Noobmaster69korg/EMG_gesture_classifier_Verilog/Files for analysis/description.md

This folder contains the files which was used to check if the model was working as intended.

Total 6 files are there. What's absolutely necessary is that u **add the "emg_data.hex" file to your verilog project. ** Since the test bench will be reading the sample values from this very file itself.
