Noobmaster69korg/EMG_gesture_classifier_Verilog/COE files/description.md

COE files basically contain the paramters which are to be loaded in the respective bram IPs of the verilog project.

**Details**

Total COE files: 197

Mapping of the COE files( the mapping information of the "bram_0.xci – bram_31.xci (32)" is completely verified. Ignore the identifier 'likely' in that respective description)
