Noobmaster69korg/EMG_gesture_classifier_Verilog/Model_description/summary_of_MODEL.png

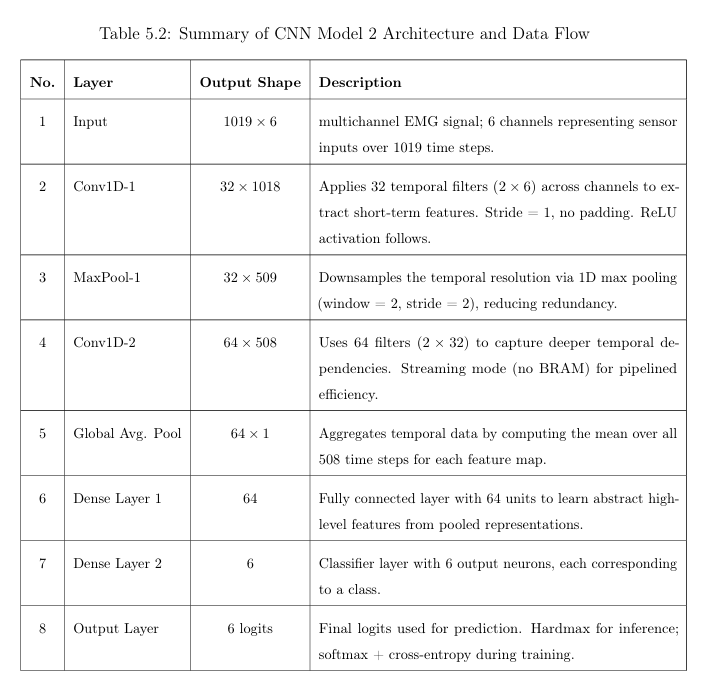
Model_description/summary_of_MODEL.png
