Noobmaster69korg/EMG_gesture_classifier_Verilog/verilog testbench files/description.md

This folder contains the various testbenches of the project
