Noobmaster69korg/EMG_gesture_classifier_Verilog/verilog_code_files/L2_main.v

`timescale 1ns / 1ps


module pre_fetch (
    input clk,
    input reset,
    input clk_2,
    input reset_data,
 (*dont_touch = "true"*)   input signed [17:0] data_in_0, 
 (*dont_touch = "true"*)   input signed [17:0] data_in_1, 
    input signed [17:0] data_in_2, 
    input signed [17:0] data_in_3, 
    input signed [17:0] data_in_4, 
    input signed [17:0] data_in_5, 
    input signed [17:0] data_in_6, 
    input signed [17:0] data_in_7, 
    input signed [17:0] data_in_8, 
    input signed [17:0] data_in_9, 
    input signed [17:0] data_in_10, 
    input signed [17:0] data_in_11, 
    input signed [17:0] data_in_12, 
    input signed [17:0] data_in_13, 
    input signed [17:0] data_in_14, 
    input signed [17:0] data_in_15, 
    input signed [17:0] data_in_16, 
    input signed [17:0] data_in_17, 
    input signed [17:0] data_in_18, 
    input signed [17:0] data_in_19, 
    input signed [17:0] data_in_20, 
    input signed [17:0] data_in_21, 
    input signed [17:0] data_in_22, 
    input signed [17:0] data_in_23, 
    input signed [17:0] data_in_24, 
    input signed [17:0] data_in_25, 
    input signed [17:0] data_in_26, 
    input signed [17:0] data_in_27, 
    input signed [17:0] data_in_28, 
    input signed [17:0] data_in_29, 
    input signed [17:0] data_in_30, 
    input signed [17:0] data_in_31, 
    
 (*dont_touch = "true"*)   output reset_next_stage,
 (*dont_touch = "true"*)    output signed [31:0] data_out_0, 
 (*dont_touch = "true"*)   output signed [31:0] data_out_1, 
    output signed [31:0] data_out_2, 
    output signed [31:0] data_out_3, 
    output signed [31:0] data_out_4, 
    output signed [31:0] data_out_5, 
    output signed [31:0] data_out_6, 
    output signed [31:0] data_out_7, 
    output signed [31:0] data_out_8, 
    output signed [31:0] data_out_9, 
    output signed [31:0] data_out_10, 
    output signed [31:0] data_out_11, 
    output signed [31:0] data_out_12, 
    output signed [31:0] data_out_13, 
    output signed [31:0] data_out_14, 
    output signed [31:0] data_out_15,
    output signed [31:0] data_out_16, 
    output signed [31:0] data_out_17, 
    output signed [31:0] data_out_18, 
    output signed [31:0] data_out_19, 
    output signed [31:0] data_out_20, 
    output signed [31:0] data_out_21, 
    output signed [31:0] data_out_22, 
    output signed [31:0] data_out_23, 
    output signed [31:0] data_out_24, 
    output signed [31:0] data_out_25, 
    output signed [31:0] data_out_26, 
    output signed [31:0] data_out_27, 
    output signed [31:0] data_out_28, 
    output signed [31:0] data_out_29, 
    output signed [31:0] data_out_30, 
    output signed [31:0] data_out_31, 
    output signed [31:0] data_out_32, 
    output signed [31:0] data_out_33, 
    output signed [31:0] data_out_34, 
    output signed [31:0] data_out_35, 
    output signed [31:0] data_out_36, 
    output signed [31:0] data_out_37, 
    output signed [31:0] data_out_38, 
    output signed [31:0] data_out_39, 
    output signed [31:0] data_out_40, 
    output signed [31:0] data_out_41, 
    output signed [31:0] data_out_42, 
    output signed [31:0] data_out_43, 
    output signed [31:0] data_out_44, 
    output signed [31:0] data_out_45, 
    output signed [31:0] data_out_46, 
    output signed [31:0] data_out_47, 
    output signed [31:0] data_out_48, 
    output signed [31:0] data_out_49, 
    output signed [31:0] data_out_50, 
    output signed [31:0] data_out_51, 
    output signed [31:0] data_out_52, 
    output signed [31:0] data_out_53, 
    output signed [31:0] data_out_54, 
    output signed [31:0] data_out_55, 
    output signed [31:0] data_out_56, 
    output signed [31:0] data_out_57, 
    output signed [31:0] data_out_58, 
    output signed [31:0] data_out_59, 
    output signed [31:0] data_out_60, 
    output signed [31:0] data_out_61, 
    output signed [31:0] data_out_62, 
    output signed [31:0] data_out_63

    );
    // multiplexing is done. 16 filters are reused 4 times so as to accomadate 64 filters
    wire signed [7:0] bram_data_out_wire [63:0] ; //outputs of BRAM
    wire signed [7:0] w  [4095:0] ; // holds the 4096 weights of 64 filters; each having 64 parameters
    wire signed [7:0] wa [1023:0]; // holds the 1024 parameters used at a time
    wire signed [26:0] data_out_wire [15:0];
    wire signed [7:0] bias_out_wire [63:0];
    wire signed [7:0] ba [15:0];
    wire signed [31:0] baa [63:0];
(*dont_touch = "true"*)    wire signed [26:0] wxa [15:0];
 //   wire signed [26:0] wxb [15:0];
(*dont_touch = "true"*)    wire [1:0] sel_wire; // for weight mux
(*dont_touch = "true"*)    wire reset_test_1,reset_test_2,new_reset;
(*dont_touch = "true"*)    wire reset_test_3, reset_test_4, reset_test_5;
    genvar i,j,k;
   
    
    bram                      m0 (clk,reset,bram_data_out_wire[0],bram_data_out_wire[1],bram_data_out_wire[2],bram_data_out_wire[3],
                                  bram_data_out_wire[4],bram_data_out_wire[5],bram_data_out_wire[6],bram_data_out_wire[7],bram_data_out_wire[8],
                                  bram_data_out_wire[9],bram_data_out_wire[10],bram_data_out_wire[11],bram_data_out_wire[12],bram_data_out_wire[13],
                                  bram_data_out_wire[14],bram_data_out_wire[15],bram_data_out_wire[16],bram_data_out_wire[17],bram_data_out_wire[18],
                                  bram_data_out_wire[19],bram_data_out_wire[20],bram_data_out_wire[21],bram_data_out_wire[22],bram_data_out_wire[23],
                                  bram_data_out_wire[24],bram_data_out_wire[25],bram_data_out_wire[26],bram_data_out_wire[27],bram_data_out_wire[28],
                                  bram_data_out_wire[29],bram_data_out_wire[30],bram_data_out_wire[31],bram_data_out_wire[32],bram_data_out_wire[33],
                                  bram_data_out_wire[34],bram_data_out_wire[35],bram_data_out_wire[36],bram_data_out_wire[37],bram_data_out_wire[38],
                                  bram_data_out_wire[39],bram_data_out_wire[40],bram_data_out_wire[41],bram_data_out_wire[42],bram_data_out_wire[43],
                                  bram_data_out_wire[44],bram_data_out_wire[45],bram_data_out_wire[46],bram_data_out_wire[47],bram_data_out_wire[48],
                                  bram_data_out_wire[49],bram_data_out_wire[50],bram_data_out_wire[51],bram_data_out_wire[52],bram_data_out_wire[53],
                                  bram_data_out_wire[54],bram_data_out_wire[55],bram_data_out_wire[56],bram_data_out_wire[57],bram_data_out_wire[58],
                                  bram_data_out_wire[59],bram_data_out_wire[60],bram_data_out_wire[61],bram_data_out_wire[62],bram_data_out_wire[63]);
    
    weight_loader_for_bias m1     (.clk(clk),.reset(reset),.bias_0(bias_out_wire[0]), .bias_1(bias_out_wire[1]), .bias_2(bias_out_wire[2]), .bias_3(bias_out_wire[3]),
                                   .bias_4(bias_out_wire[4]), .bias_5(bias_out_wire[5]), .bias_6(bias_out_wire[6]), .bias_7(bias_out_wire[7]), .bias_8(bias_out_wire[8]),
                                   .bias_9(bias_out_wire[9]), .bias_10(bias_out_wire[10]), .bias_11(bias_out_wire[11]), .bias_12(bias_out_wire[12]), .bias_13(bias_out_wire[13]),
                                   .bias_14(bias_out_wire[14]), .bias_15(bias_out_wire[15]), .bias_16(bias_out_wire[16]), .bias_17(bias_out_wire[17]), .bias_18(bias_out_wire[18]),
                                   .bias_19(bias_out_wire[19]), .bias_20(bias_out_wire[20]), .bias_21(bias_out_wire[21]), .bias_22(bias_out_wire[22]), .bias_23(bias_out_wire[23]),
                                   .bias_24(bias_out_wire[24]), .bias_25(bias_out_wire[25]), .bias_26(bias_out_wire[26]), .bias_27(bias_out_wire[27]), .bias_28(bias_out_wire[28]),
                                   .bias_29(bias_out_wire[29]), .bias_30(bias_out_wire[30]), .bias_31(bias_out_wire[31]), .bias_32(bias_out_wire[32]), .bias_33(bias_out_wire[33]),
                                   .bias_34(bias_out_wire[34]), .bias_35(bias_out_wire[35]), .bias_36(bias_out_wire[36]), .bias_37(bias_out_wire[37]), .bias_38(bias_out_wire[38]),
                                   .bias_39(bias_out_wire[39]), .bias_40(bias_out_wire[40]), .bias_41(bias_out_wire[41]), .bias_42(bias_out_wire[42]), .bias_43(bias_out_wire[43]), 
                                   .bias_44(bias_out_wire[44]), .bias_45(bias_out_wire[45]), .bias_46(bias_out_wire[46]), .bias_47(bias_out_wire[47]), .bias_48(bias_out_wire[48]),
                                   .bias_49(bias_out_wire[49]), .bias_50(bias_out_wire[50]), .bias_51(bias_out_wire[51]), .bias_52(bias_out_wire[52]), .bias_53(bias_out_wire[53]),
                                   .bias_54(bias_out_wire[54]), .bias_55(bias_out_wire[55]), .bias_56(bias_out_wire[56]), .bias_57(bias_out_wire[57]), .bias_58(bias_out_wire[58]),
                                   .bias_59(bias_out_wire[59]), .bias_60(bias_out_wire[60]), .bias_61(bias_out_wire[61]), .bias_62(bias_out_wire[62]), .bias_63(bias_out_wire[63]));
   generate
   for(i= 0 ; i < 64 ; i = i+1)begin
          weight_loader q1         (.clk(clk),.reset(reset),.data_in(bram_data_out_wire[i]),.w0(w[i*64 + 0]), .w1(w[i*64 + 1]), .w2(w[i*64 + 2]), .w3(w[i*64 + 3]), .w4(w[i*64 + 4]),
                                    .w5(w[i*64 + 5]), .w6(w[i*64 + 6]), .w7(w[i*64 + 7]), .w8(w[i*64 + 8]), .w9(w[i*64 + 9]), .w10(w[i*64 + 10]), .w11(w[i*64 + 11]), .w12(w[i*64 + 12]),
                                    .w13(w[i*64 + 13]), .w14(w[i*64 + 14]), .w15(w[i*64 + 15]), .w16(w[i*64 + 16]), .w17(w[i*64 + 17]), .w18(w[i*64 + 18]), .w19(w[i*64 + 19]), .w20(w[i*64 + 20]),
                                    .w21(w[i*64 + 21]), .w22(w[i*64 + 22]), .w23(w[i*64 + 23]), .w24(w[i*64 + 24]), .w25(w[i*64 + 25]), .w26(w[i*64 + 26]), .w27(w[i*64 + 27]), .w28(w[i*64 + 28]),
                                    .w29(w[i*64 + 29]), .w30(w[i*64 + 30]), .w31(w[i*64 + 31]), .w32(w[i*64 + 32]), .w33(w[i*64 + 33]), .w34(w[i*64 + 34]), .w35(w[i*64 + 35]), .w36(w[i*64 + 36]),
                                    .w37(w[i*64 + 37]), .w38(w[i*64 + 38]), .w39(w[i*64 + 39]), .w40(w[i*64 + 40]), .w41(w[i*64 + 41]), .w42(w[i*64 + 42]), .w43(w[i*64 + 43]), .w44(w[i*64 + 44]),
                                    .w45(w[i*64 + 45]), .w46(w[i*64 + 46]), .w47(w[i*64 + 47]), .w48(w[i*64 + 48]), .w49(w[i*64 + 49]), .w50(w[i*64 + 50]), .w51(w[i*64 + 51]), .w52(w[i*64 + 52]),
                                    .w53(w[i*64 + 53]), .w54(w[i*64 + 54]), .w55(w[i*64 + 55]), .w56(w[i*64 + 56]), .w57(w[i*64 + 57]), .w58(w[i*64 + 58]), .w59(w[i*64 + 59]), .w60(w[i*64 + 60]),
                                    .w61(w[i*64 + 61]), .w62(w[i*64 + 62]), .w63(w[i*64 + 63]));
   end 
   endgenerate 
   
   mux_4096 q2 (.sel(sel_wire),.data_in_0(w[0]),.data_in_1(w[1]),.data_in_2(w[2]),.data_in_3(w[3]),.data_in_4(w[4]),.data_in_5(w[5]),.data_in_6(w[6]),.data_in_7(w[7]),.data_in_8(w[8]),.data_in_9(w[9]),.data_in_10(w[10]),
                .data_in_11(w[11]),.data_in_12(w[12]),.data_in_13(w[13]),.data_in_14(w[14]),.data_in_15(w[15]),.data_in_16(w[16]),.data_in_17(w[17]),.data_in_18(w[18]),.data_in_19(w[19]),.data_in_20(w[20]),
                .data_in_21(w[21]),.data_in_22(w[22]),.data_in_23(w[23]),.data_in_24(w[24]),.data_in_25(w[25]),.data_in_26(w[26]),.data_in_27(w[27]),.data_in_28(w[28]),.data_in_29(w[29]),.data_in_30(w[30]),
                .data_in_31(w[31]),.data_in_32(w[32]),.data_in_33(w[33]),.data_in_34(w[34]),.data_in_35(w[35]),.data_in_36(w[36]),.data_in_37(w[37]),.data_in_38(w[38]),.data_in_39(w[39]),.data_in_40(w[40]),
                .data_in_41(w[41]),.data_in_42(w[42]),.data_in_43(w[43]),.data_in_44(w[44]),.data_in_45(w[45]),.data_in_46(w[46]),.data_in_47(w[47]),.data_in_48(w[48]),.data_in_49(w[49]),.data_in_50(w[50]),
                .data_in_51(w[51]),.data_in_52(w[52]),.data_in_53(w[53]),.data_in_54(w[54]),.data_in_55(w[55]),.data_in_56(w[56]),.data_in_57(w[57]),.data_in_58(w[58]),.data_in_59(w[59]),.data_in_60(w[60]),
                .data_in_61(w[61]),.data_in_62(w[62]),.data_in_63(w[63]),.data_in_64(w[64]),.data_in_65(w[65]),.data_in_66(w[66]),.data_in_67(w[67]),.data_in_68(w[68]),.data_in_69(w[69]),.data_in_70(w[70]),
                .data_in_71(w[71]),.data_in_72(w[72]),.data_in_73(w[73]),.data_in_74(w[74]),.data_in_75(w[75]),.data_in_76(w[76]),.data_in_77(w[77]),.data_in_78(w[78]),.data_in_79(w[79]),.data_in_80(w[80]),
                .data_in_81(w[81]),.data_in_82(w[82]),.data_in_83(w[83]),.data_in_84(w[84]),.data_in_85(w[85]),.data_in_86(w[86]),.data_in_87(w[87]),.data_in_88(w[88]),.data_in_89(w[89]),.data_in_90(w[90]),
                .data_in_91(w[91]),.data_in_92(w[92]),.data_in_93(w[93]),.data_in_94(w[94]),.data_in_95(w[95]),.data_in_96(w[96]),.data_in_97(w[97]),.data_in_98(w[98]),.data_in_99(w[99]),.data_in_100(w[100]),
                .data_in_101(w[101]),.data_in_102(w[102]),.data_in_103(w[103]),.data_in_104(w[104]),.data_in_105(w[105]),.data_in_106(w[106]),.data_in_107(w[107]),.data_in_108(w[108]),.data_in_109(w[109]),
                .data_in_110(w[110]),.data_in_111(w[111]),.data_in_112(w[112]),.data_in_113(w[113]),.data_in_114(w[114]),.data_in_115(w[115]),.data_in_116(w[116]),.data_in_117(w[117]),.data_in_118(w[118]),
                .data_in_119(w[119]),.data_in_120(w[120]),.data_in_121(w[121]),.data_in_122(w[122]),.data_in_123(w[123]),.data_in_124(w[124]),.data_in_125(w[125]),.data_in_126(w[126]),.data_in_127(w[127]),
                .data_in_128(w[128]),.data_in_129(w[129]),.data_in_130(w[130]),.data_in_131(w[131]),.data_in_132(w[132]),.data_in_133(w[133]),.data_in_134(w[134]),.data_in_135(w[135]),.data_in_136(w[136]),
                .data_in_137(w[137]),.data_in_138(w[138]),.data_in_139(w[139]),.data_in_140(w[140]),.data_in_141(w[141]),.data_in_142(w[142]),.data_in_143(w[143]),.data_in_144(w[144]),.data_in_145(w[145]),
                .data_in_146(w[146]),.data_in_147(w[147]),.data_in_148(w[148]),.data_in_149(w[149]),.data_in_150(w[150]),.data_in_151(w[151]),.data_in_152(w[152]),.data_in_153(w[153]),.data_in_154(w[154]),
                .data_in_155(w[155]),.data_in_156(w[156]),.data_in_157(w[157]),.data_in_158(w[158]),.data_in_159(w[159]),.data_in_160(w[160]),.data_in_161(w[161]),.data_in_162(w[162]),.data_in_163(w[163]),
                .data_in_164(w[164]),.data_in_165(w[165]),.data_in_166(w[166]),.data_in_167(w[167]),.data_in_168(w[168]),.data_in_169(w[169]),.data_in_170(w[170]),.data_in_171(w[171]),.data_in_172(w[172]),
                .data_in_173(w[173]),.data_in_174(w[174]),.data_in_175(w[175]),.data_in_176(w[176]),.data_in_177(w[177]),.data_in_178(w[178]),.data_in_179(w[179]),.data_in_180(w[180]),.data_in_181(w[181]),
                .data_in_182(w[182]),.data_in_183(w[183]),.data_in_184(w[184]),.data_in_185(w[185]),.data_in_186(w[186]),.data_in_187(w[187]),.data_in_188(w[188]),.data_in_189(w[189]),.data_in_190(w[190]),
                .data_in_191(w[191]),.data_in_192(w[192]),.data_in_193(w[193]),.data_in_194(w[194]),.data_in_195(w[195]),.data_in_196(w[196]),.data_in_197(w[197]),.data_in_198(w[198]),.data_in_199(w[199]),
                .data_in_200(w[200]),.data_in_201(w[201]),.data_in_202(w[202]),.data_in_203(w[203]),.data_in_204(w[204]),.data_in_205(w[205]),.data_in_206(w[206]),.data_in_207(w[207]),.data_in_208(w[208]),
                .data_in_209(w[209]),.data_in_210(w[210]),.data_in_211(w[211]),.data_in_212(w[212]),.data_in_213(w[213]),.data_in_214(w[214]),.data_in_215(w[215]),.data_in_216(w[216]),.data_in_217(w[217]),
                .data_in_218(w[218]),.data_in_219(w[219]),.data_in_220(w[220]),.data_in_221(w[221]),.data_in_222(w[222]),.data_in_223(w[223]),.data_in_224(w[224]),.data_in_225(w[225]),.data_in_226(w[226]),
                .data_in_227(w[227]),.data_in_228(w[228]),.data_in_229(w[229]),.data_in_230(w[230]),.data_in_231(w[231]),.data_in_232(w[232]),.data_in_233(w[233]),.data_in_234(w[234]),.data_in_235(w[235]),
                .data_in_236(w[236]),.data_in_237(w[237]),.data_in_238(w[238]),.data_in_239(w[239]),.data_in_240(w[240]),.data_in_241(w[241]),.data_in_242(w[242]),.data_in_243(w[243]),.data_in_244(w[244]),
                .data_in_245(w[245]),.data_in_246(w[246]),.data_in_247(w[247]),.data_in_248(w[248]),.data_in_249(w[249]),.data_in_250(w[250]),.data_in_251(w[251]),.data_in_252(w[252]),.data_in_253(w[253]),
                .data_in_254(w[254]),.data_in_255(w[255]),.data_in_256(w[256]),.data_in_257(w[257]),.data_in_258(w[258]),.data_in_259(w[259]),.data_in_260(w[260]),.data_in_261(w[261]),.data_in_262(w[262]),
                .data_in_263(w[263]),.data_in_264(w[264]),.data_in_265(w[265]),.data_in_266(w[266]),.data_in_267(w[267]),.data_in_268(w[268]),.data_in_269(w[269]),.data_in_270(w[270]),.data_in_271(w[271]),
                .data_in_272(w[272]),.data_in_273(w[273]),.data_in_274(w[274]),.data_in_275(w[275]),.data_in_276(w[276]),.data_in_277(w[277]),.data_in_278(w[278]),.data_in_279(w[279]),.data_in_280(w[280]),
                .data_in_281(w[281]),.data_in_282(w[282]),.data_in_283(w[283]),.data_in_284(w[284]),.data_in_285(w[285]),.data_in_286(w[286]),.data_in_287(w[287]),.data_in_288(w[288]),.data_in_289(w[289]),
                .data_in_290(w[290]),.data_in_291(w[291]),.data_in_292(w[292]),.data_in_293(w[293]),.data_in_294(w[294]),.data_in_295(w[295]),.data_in_296(w[296]),.data_in_297(w[297]),.data_in_298(w[298]),
                .data_in_299(w[299]),.data_in_300(w[300]),.data_in_301(w[301]),.data_in_302(w[302]),.data_in_303(w[303]),.data_in_304(w[304]),.data_in_305(w[305]),.data_in_306(w[306]),.data_in_307(w[307]),
                .data_in_308(w[308]),.data_in_309(w[309]),.data_in_310(w[310]),.data_in_311(w[311]),.data_in_312(w[312]),.data_in_313(w[313]),.data_in_314(w[314]),.data_in_315(w[315]),.data_in_316(w[316]),
                .data_in_317(w[317]),.data_in_318(w[318]),.data_in_319(w[319]),.data_in_320(w[320]),.data_in_321(w[321]),.data_in_322(w[322]),.data_in_323(w[323]),.data_in_324(w[324]),.data_in_325(w[325]),
                .data_in_326(w[326]),.data_in_327(w[327]),.data_in_328(w[328]),.data_in_329(w[329]),.data_in_330(w[330]),.data_in_331(w[331]),.data_in_332(w[332]),.data_in_333(w[333]),.data_in_334(w[334]),
                .data_in_335(w[335]),.data_in_336(w[336]),.data_in_337(w[337]),.data_in_338(w[338]),.data_in_339(w[339]),.data_in_340(w[340]),.data_in_341(w[341]),.data_in_342(w[342]),.data_in_343(w[343]),
                .data_in_344(w[344]),.data_in_345(w[345]),.data_in_346(w[346]),.data_in_347(w[347]),.data_in_348(w[348]),.data_in_349(w[349]),.data_in_350(w[350]),.data_in_351(w[351]),.data_in_352(w[352]),
                .data_in_353(w[353]),.data_in_354(w[354]),.data_in_355(w[355]),.data_in_356(w[356]),.data_in_357(w[357]),.data_in_358(w[358]),.data_in_359(w[359]),.data_in_360(w[360]),.data_in_361(w[361]),
                .data_in_362(w[362]),.data_in_363(w[363]),.data_in_364(w[364]),.data_in_365(w[365]),.data_in_366(w[366]),.data_in_367(w[367]),.data_in_368(w[368]),.data_in_369(w[369]),.data_in_370(w[370]),
                .data_in_371(w[371]),.data_in_372(w[372]),.data_in_373(w[373]),.data_in_374(w[374]),.data_in_375(w[375]),.data_in_376(w[376]),.data_in_377(w[377]),.data_in_378(w[378]),.data_in_379(w[379]),
                .data_in_380(w[380]),.data_in_381(w[381]),.data_in_382(w[382]),.data_in_383(w[383]),.data_in_384(w[384]),.data_in_385(w[385]),.data_in_386(w[386]),.data_in_387(w[387]),.data_in_388(w[388]),
                .data_in_389(w[389]),.data_in_390(w[390]),.data_in_391(w[391]),.data_in_392(w[392]),.data_in_393(w[393]),.data_in_394(w[394]),.data_in_395(w[395]),.data_in_396(w[396]),.data_in_397(w[397]),
                .data_in_398(w[398]),.data_in_399(w[399]),.data_in_400(w[400]),.data_in_401(w[401]),.data_in_402(w[402]),.data_in_403(w[403]),.data_in_404(w[404]),.data_in_405(w[405]),.data_in_406(w[406]),
                .data_in_407(w[407]),.data_in_408(w[408]),.data_in_409(w[409]),.data_in_410(w[410]),.data_in_411(w[411]),.data_in_412(w[412]),.data_in_413(w[413]),.data_in_414(w[414]),.data_in_415(w[415]),
                .data_in_416(w[416]),.data_in_417(w[417]),.data_in_418(w[418]),.data_in_419(w[419]),.data_in_420(w[420]),.data_in_421(w[421]),.data_in_422(w[422]),.data_in_423(w[423]),.data_in_424(w[424]),
                .data_in_425(w[425]),.data_in_426(w[426]),.data_in_427(w[427]),.data_in_428(w[428]),.data_in_429(w[429]),.data_in_430(w[430]),.data_in_431(w[431]),.data_in_432(w[432]),.data_in_433(w[433]),
                .data_in_434(w[434]),.data_in_435(w[435]),.data_in_436(w[436]),.data_in_437(w[437]),.data_in_438(w[438]),.data_in_439(w[439]),.data_in_440(w[440]),.data_in_441(w[441]),.data_in_442(w[442]),
                .data_in_443(w[443]),.data_in_444(w[444]),.data_in_445(w[445]),.data_in_446(w[446]),.data_in_447(w[447]),.data_in_448(w[448]),.data_in_449(w[449]),.data_in_450(w[450]),.data_in_451(w[451]),
                .data_in_452(w[452]),.data_in_453(w[453]),.data_in_454(w[454]),.data_in_455(w[455]),.data_in_456(w[456]),.data_in_457(w[457]),.data_in_458(w[458]),.data_in_459(w[459]),.data_in_460(w[460]),
                .data_in_461(w[461]),.data_in_462(w[462]),.data_in_463(w[463]),.data_in_464(w[464]),.data_in_465(w[465]),.data_in_466(w[466]),.data_in_467(w[467]),.data_in_468(w[468]),.data_in_469(w[469]),
                .data_in_470(w[470]),.data_in_471(w[471]),.data_in_472(w[472]),.data_in_473(w[473]),.data_in_474(w[474]),.data_in_475(w[475]),.data_in_476(w[476]),.data_in_477(w[477]),.data_in_478(w[478]),
                .data_in_479(w[479]),.data_in_480(w[480]),.data_in_481(w[481]),.data_in_482(w[482]),.data_in_483(w[483]),.data_in_484(w[484]),.data_in_485(w[485]),.data_in_486(w[486]),.data_in_487(w[487]),
                .data_in_488(w[488]),.data_in_489(w[489]),.data_in_490(w[490]),.data_in_491(w[491]),.data_in_492(w[492]),.data_in_493(w[493]),.data_in_494(w[494]),.data_in_495(w[495]),.data_in_496(w[496]),
                .data_in_497(w[497]),.data_in_498(w[498]),.data_in_499(w[499]),.data_in_500(w[500]),.data_in_501(w[501]),.data_in_502(w[502]),.data_in_503(w[503]),.data_in_504(w[504]),.data_in_505(w[505]),
                .data_in_506(w[506]),.data_in_507(w[507]),.data_in_508(w[508]),.data_in_509(w[509]),.data_in_510(w[510]),.data_in_511(w[511]),.data_in_512(w[512]),.data_in_513(w[513]),.data_in_514(w[514]),
                .data_in_515(w[515]),.data_in_516(w[516]),.data_in_517(w[517]),.data_in_518(w[518]),.data_in_519(w[519]),.data_in_520(w[520]),.data_in_521(w[521]),.data_in_522(w[522]),.data_in_523(w[523]),
                .data_in_524(w[524]),.data_in_525(w[525]),.data_in_526(w[526]),.data_in_527(w[527]),.data_in_528(w[528]),.data_in_529(w[529]),.data_in_530(w[530]),.data_in_531(w[531]),.data_in_532(w[532]),
                .data_in_533(w[533]),.data_in_534(w[534]),.data_in_535(w[535]),.data_in_536(w[536]),.data_in_537(w[537]),.data_in_538(w[538]),.data_in_539(w[539]),.data_in_540(w[540]),.data_in_541(w[541]),
                .data_in_542(w[542]),.data_in_543(w[543]),.data_in_544(w[544]),.data_in_545(w[545]),.data_in_546(w[546]),.data_in_547(w[547]),.data_in_548(w[548]),.data_in_549(w[549]),.data_in_550(w[550]),
                .data_in_551(w[551]),.data_in_552(w[552]),.data_in_553(w[553]),.data_in_554(w[554]),.data_in_555(w[555]),.data_in_556(w[556]),.data_in_557(w[557]),.data_in_558(w[558]),.data_in_559(w[559]),
                .data_in_560(w[560]),.data_in_561(w[561]),.data_in_562(w[562]),.data_in_563(w[563]),.data_in_564(w[564]),.data_in_565(w[565]),.data_in_566(w[566]),.data_in_567(w[567]),.data_in_568(w[568]),
                .data_in_569(w[569]),.data_in_570(w[570]),.data_in_571(w[571]),.data_in_572(w[572]),.data_in_573(w[573]),.data_in_574(w[574]),.data_in_575(w[575]),.data_in_576(w[576]),.data_in_577(w[577]),
                .data_in_578(w[578]),.data_in_579(w[579]),.data_in_580(w[580]),.data_in_581(w[581]),.data_in_582(w[582]),.data_in_583(w[583]),.data_in_584(w[584]),.data_in_585(w[585]),.data_in_586(w[586]),
                .data_in_587(w[587]),.data_in_588(w[588]),.data_in_589(w[589]),.data_in_590(w[590]),.data_in_591(w[591]),.data_in_592(w[592]),.data_in_593(w[593]),.data_in_594(w[594]),.data_in_595(w[595]),
                .data_in_596(w[596]),.data_in_597(w[597]),.data_in_598(w[598]),.data_in_599(w[599]),.data_in_600(w[600]),.data_in_601(w[601]),.data_in_602(w[602]),.data_in_603(w[603]),.data_in_604(w[604]),
                .data_in_605(w[605]),.data_in_606(w[606]),.data_in_607(w[607]),.data_in_608(w[608]),.data_in_609(w[609]),.data_in_610(w[610]),.data_in_611(w[611]),.data_in_612(w[612]),.data_in_613(w[613]),
                .data_in_614(w[614]),.data_in_615(w[615]),.data_in_616(w[616]),.data_in_617(w[617]),.data_in_618(w[618]),.data_in_619(w[619]),.data_in_620(w[620]),.data_in_621(w[621]),.data_in_622(w[622]),
                .data_in_623(w[623]),.data_in_624(w[624]),.data_in_625(w[625]),.data_in_626(w[626]),.data_in_627(w[627]),.data_in_628(w[628]),.data_in_629(w[629]),.data_in_630(w[630]),.data_in_631(w[631]),
                .data_in_632(w[632]),.data_in_633(w[633]),.data_in_634(w[634]),.data_in_635(w[635]),.data_in_636(w[636]),.data_in_637(w[637]),.data_in_638(w[638]),.data_in_639(w[639]),.data_in_640(w[640]),
                .data_in_641(w[641]),.data_in_642(w[642]),.data_in_643(w[643]),.data_in_644(w[644]),.data_in_645(w[645]),.data_in_646(w[646]),.data_in_647(w[647]),.data_in_648(w[648]),.data_in_649(w[649]),
                .data_in_650(w[650]),.data_in_651(w[651]),.data_in_652(w[652]),.data_in_653(w[653]),.data_in_654(w[654]),.data_in_655(w[655]),.data_in_656(w[656]),.data_in_657(w[657]),.data_in_658(w[658]),
                .data_in_659(w[659]),.data_in_660(w[660]),.data_in_661(w[661]),.data_in_662(w[662]),.data_in_663(w[663]),.data_in_664(w[664]),.data_in_665(w[665]),.data_in_666(w[666]),.data_in_667(w[667]),
                .data_in_668(w[668]),.data_in_669(w[669]),.data_in_670(w[670]),.data_in_671(w[671]),.data_in_672(w[672]),.data_in_673(w[673]),.data_in_674(w[674]),.data_in_675(w[675]),.data_in_676(w[676]),
                .data_in_677(w[677]),.data_in_678(w[678]),.data_in_679(w[679]),.data_in_680(w[680]),.data_in_681(w[681]),.data_in_682(w[682]),.data_in_683(w[683]),.data_in_684(w[684]),.data_in_685(w[685]),
                .data_in_686(w[686]),.data_in_687(w[687]),.data_in_688(w[688]),.data_in_689(w[689]),.data_in_690(w[690]),.data_in_691(w[691]),.data_in_692(w[692]),.data_in_693(w[693]),.data_in_694(w[694]),
                .data_in_695(w[695]),.data_in_696(w[696]),.data_in_697(w[697]),.data_in_698(w[698]),.data_in_699(w[699]),.data_in_700(w[700]),.data_in_701(w[701]),.data_in_702(w[702]),.data_in_703(w[703]),
                .data_in_704(w[704]),.data_in_705(w[705]),.data_in_706(w[706]),.data_in_707(w[707]),.data_in_708(w[708]),.data_in_709(w[709]),.data_in_710(w[710]),.data_in_711(w[711]),.data_in_712(w[712]),
                .data_in_713(w[713]),.data_in_714(w[714]),.data_in_715(w[715]),.data_in_716(w[716]),.data_in_717(w[717]),.data_in_718(w[718]),.data_in_719(w[719]),.data_in_720(w[720]),.data_in_721(w[721]),
                .data_in_722(w[722]),.data_in_723(w[723]),.data_in_724(w[724]),.data_in_725(w[725]),.data_in_726(w[726]),.data_in_727(w[727]),.data_in_728(w[728]),.data_in_729(w[729]),.data_in_730(w[730]),
                .data_in_731(w[731]),.data_in_732(w[732]),.data_in_733(w[733]),.data_in_734(w[734]),.data_in_735(w[735]),.data_in_736(w[736]),.data_in_737(w[737]),.data_in_738(w[738]),.data_in_739(w[739]),
                .data_in_740(w[740]),.data_in_741(w[741]),.data_in_742(w[742]),.data_in_743(w[743]),.data_in_744(w[744]),.data_in_745(w[745]),.data_in_746(w[746]),.data_in_747(w[747]),.data_in_748(w[748]),
                .data_in_749(w[749]),.data_in_750(w[750]),.data_in_751(w[751]),.data_in_752(w[752]),.data_in_753(w[753]),.data_in_754(w[754]),.data_in_755(w[755]),.data_in_756(w[756]),.data_in_757(w[757]),
                .data_in_758(w[758]),.data_in_759(w[759]),.data_in_760(w[760]),.data_in_761(w[761]),.data_in_762(w[762]),.data_in_763(w[763]),.data_in_764(w[764]),.data_in_765(w[765]),.data_in_766(w[766]),
                .data_in_767(w[767]),.data_in_768(w[768]),.data_in_769(w[769]),.data_in_770(w[770]),.data_in_771(w[771]),.data_in_772(w[772]),.data_in_773(w[773]),.data_in_774(w[774]),.data_in_775(w[775]),
                .data_in_776(w[776]),.data_in_777(w[777]),.data_in_778(w[778]),.data_in_779(w[779]),.data_in_780(w[780]),.data_in_781(w[781]),.data_in_782(w[782]),.data_in_783(w[783]),.data_in_784(w[784]),
                .data_in_785(w[785]),.data_in_786(w[786]),.data_in_787(w[787]),.data_in_788(w[788]),.data_in_789(w[789]),.data_in_790(w[790]),.data_in_791(w[791]),.data_in_792(w[792]),.data_in_793(w[793]),
                .data_in_794(w[794]),.data_in_795(w[795]),.data_in_796(w[796]),.data_in_797(w[797]),.data_in_798(w[798]),.data_in_799(w[799]),.data_in_800(w[800]),.data_in_801(w[801]),.data_in_802(w[802]),
                .data_in_803(w[803]),.data_in_804(w[804]),.data_in_805(w[805]),.data_in_806(w[806]),.data_in_807(w[807]),.data_in_808(w[808]),.data_in_809(w[809]),.data_in_810(w[810]),.data_in_811(w[811]),
                .data_in_812(w[812]),.data_in_813(w[813]),.data_in_814(w[814]),.data_in_815(w[815]),.data_in_816(w[816]),.data_in_817(w[817]),.data_in_818(w[818]),.data_in_819(w[819]),.data_in_820(w[820]),
                .data_in_821(w[821]),.data_in_822(w[822]),.data_in_823(w[823]),.data_in_824(w[824]),.data_in_825(w[825]),.data_in_826(w[826]),.data_in_827(w[827]),.data_in_828(w[828]),.data_in_829(w[829]),
                .data_in_830(w[830]),.data_in_831(w[831]),.data_in_832(w[832]),.data_in_833(w[833]),.data_in_834(w[834]),.data_in_835(w[835]),.data_in_836(w[836]),.data_in_837(w[837]),.data_in_838(w[838]),
                .data_in_839(w[839]),.data_in_840(w[840]),.data_in_841(w[841]),.data_in_842(w[842]),.data_in_843(w[843]),.data_in_844(w[844]),.data_in_845(w[845]),.data_in_846(w[846]),.data_in_847(w[847]),
                .data_in_848(w[848]),.data_in_849(w[849]),.data_in_850(w[850]),.data_in_851(w[851]),.data_in_852(w[852]),.data_in_853(w[853]),.data_in_854(w[854]),.data_in_855(w[855]),.data_in_856(w[856]),
                .data_in_857(w[857]),.data_in_858(w[858]),.data_in_859(w[859]),.data_in_860(w[860]),.data_in_861(w[861]),.data_in_862(w[862]),.data_in_863(w[863]),.data_in_864(w[864]),.data_in_865(w[865]),
                .data_in_866(w[866]),.data_in_867(w[867]),.data_in_868(w[868]),.data_in_869(w[869]),.data_in_870(w[870]),.data_in_871(w[871]),.data_in_872(w[872]),.data_in_873(w[873]),.data_in_874(w[874]),
                .data_in_875(w[875]),.data_in_876(w[876]),.data_in_877(w[877]),.data_in_878(w[878]),.data_in_879(w[879]),.data_in_880(w[880]),.data_in_881(w[881]),.data_in_882(w[882]),.data_in_883(w[883]),
                .data_in_884(w[884]),.data_in_885(w[885]),.data_in_886(w[886]),.data_in_887(w[887]),.data_in_888(w[888]),.data_in_889(w[889]),.data_in_890(w[890]),.data_in_891(w[891]),.data_in_892(w[892]),
                .data_in_893(w[893]),.data_in_894(w[894]),.data_in_895(w[895]),.data_in_896(w[896]),.data_in_897(w[897]),.data_in_898(w[898]),.data_in_899(w[899]),.data_in_900(w[900]),.data_in_901(w[901]),
                .data_in_902(w[902]),.data_in_903(w[903]),.data_in_904(w[904]),.data_in_905(w[905]),.data_in_906(w[906]),.data_in_907(w[907]),.data_in_908(w[908]),.data_in_909(w[909]),.data_in_910(w[910]),
                .data_in_911(w[911]),.data_in_912(w[912]),.data_in_913(w[913]),.data_in_914(w[914]),.data_in_915(w[915]),.data_in_916(w[916]),.data_in_917(w[917]),.data_in_918(w[918]),.data_in_919(w[919]),
                .data_in_920(w[920]),.data_in_921(w[921]),.data_in_922(w[922]),.data_in_923(w[923]),.data_in_924(w[924]),.data_in_925(w[925]),.data_in_926(w[926]),.data_in_927(w[927]),.data_in_928(w[928]),
                .data_in_929(w[929]),.data_in_930(w[930]),.data_in_931(w[931]),.data_in_932(w[932]),.data_in_933(w[933]),.data_in_934(w[934]),.data_in_935(w[935]),.data_in_936(w[936]),.data_in_937(w[937]),
                .data_in_938(w[938]),.data_in_939(w[939]),.data_in_940(w[940]),.data_in_941(w[941]),.data_in_942(w[942]),.data_in_943(w[943]),.data_in_944(w[944]),.data_in_945(w[945]),.data_in_946(w[946]),
                .data_in_947(w[947]),.data_in_948(w[948]),.data_in_949(w[949]),.data_in_950(w[950]),.data_in_951(w[951]),.data_in_952(w[952]),.data_in_953(w[953]),.data_in_954(w[954]),.data_in_955(w[955]),
                .data_in_956(w[956]),.data_in_957(w[957]),.data_in_958(w[958]),.data_in_959(w[959]),.data_in_960(w[960]),.data_in_961(w[961]),.data_in_962(w[962]),.data_in_963(w[963]),.data_in_964(w[964]),
                .data_in_965(w[965]),.data_in_966(w[966]),.data_in_967(w[967]),.data_in_968(w[968]),.data_in_969(w[969]),.data_in_970(w[970]),.data_in_971(w[971]),.data_in_972(w[972]),.data_in_973(w[973]),
                .data_in_974(w[974]),.data_in_975(w[975]),.data_in_976(w[976]),.data_in_977(w[977]),.data_in_978(w[978]),.data_in_979(w[979]),.data_in_980(w[980]),.data_in_981(w[981]),.data_in_982(w[982]),
                .data_in_983(w[983]),.data_in_984(w[984]),.data_in_985(w[985]),.data_in_986(w[986]),.data_in_987(w[987]),.data_in_988(w[988]),.data_in_989(w[989]),.data_in_990(w[990]),.data_in_991(w[991]),
                .data_in_992(w[992]),.data_in_993(w[993]),.data_in_994(w[994]),.data_in_995(w[995]),.data_in_996(w[996]),.data_in_997(w[997]),.data_in_998(w[998]),.data_in_999(w[999]),.data_in_1000(w[1000]),
                .data_in_1001(w[1001]),.data_in_1002(w[1002]),.data_in_1003(w[1003]),.data_in_1004(w[1004]),.data_in_1005(w[1005]),.data_in_1006(w[1006]),.data_in_1007(w[1007]),.data_in_1008(w[1008]),.data_in_1009(w[1009]),
                .data_in_1010(w[1010]),.data_in_1011(w[1011]),.data_in_1012(w[1012]),.data_in_1013(w[1013]),.data_in_1014(w[1014]),.data_in_1015(w[1015]),.data_in_1016(w[1016]),.data_in_1017(w[1017]),.data_in_1018(w[1018]),
                .data_in_1019(w[1019]),.data_in_1020(w[1020]),.data_in_1021(w[1021]),.data_in_1022(w[1022]),.data_in_1023(w[1023]),.data_in_1024(w[1024]),.data_in_1025(w[1025]),.data_in_1026(w[1026]),.data_in_1027(w[1027]),
                .data_in_1028(w[1028]),.data_in_1029(w[1029]),.data_in_1030(w[1030]),.data_in_1031(w[1031]),.data_in_1032(w[1032]),.data_in_1033(w[1033]),.data_in_1034(w[1034]),.data_in_1035(w[1035]),.data_in_1036(w[1036]),
                .data_in_1037(w[1037]),.data_in_1038(w[1038]),.data_in_1039(w[1039]),.data_in_1040(w[1040]),.data_in_1041(w[1041]),.data_in_1042(w[1042]),.data_in_1043(w[1043]),.data_in_1044(w[1044]),.data_in_1045(w[1045]),
                .data_in_1046(w[1046]),.data_in_1047(w[1047]),.data_in_1048(w[1048]),.data_in_1049(w[1049]),.data_in_1050(w[1050]),.data_in_1051(w[1051]),.data_in_1052(w[1052]),.data_in_1053(w[1053]),.data_in_1054(w[1054]),
                .data_in_1055(w[1055]),.data_in_1056(w[1056]),.data_in_1057(w[1057]),.data_in_1058(w[1058]),.data_in_1059(w[1059]),.data_in_1060(w[1060]),.data_in_1061(w[1061]),.data_in_1062(w[1062]),.data_in_1063(w[1063]),
                .data_in_1064(w[1064]),.data_in_1065(w[1065]),.data_in_1066(w[1066]),.data_in_1067(w[1067]),.data_in_1068(w[1068]),.data_in_1069(w[1069]),.data_in_1070(w[1070]),.data_in_1071(w[1071]),.data_in_1072(w[1072]),
                .data_in_1073(w[1073]),.data_in_1074(w[1074]),.data_in_1075(w[1075]),.data_in_1076(w[1076]),.data_in_1077(w[1077]),.data_in_1078(w[1078]),.data_in_1079(w[1079]),.data_in_1080(w[1080]),.data_in_1081(w[1081]),
                .data_in_1082(w[1082]),.data_in_1083(w[1083]),.data_in_1084(w[1084]),.data_in_1085(w[1085]),.data_in_1086(w[1086]),.data_in_1087(w[1087]),.data_in_1088(w[1088]),.data_in_1089(w[1089]),.data_in_1090(w[1090]),
                .data_in_1091(w[1091]),.data_in_1092(w[1092]),.data_in_1093(w[1093]),.data_in_1094(w[1094]),.data_in_1095(w[1095]),.data_in_1096(w[1096]),.data_in_1097(w[1097]),.data_in_1098(w[1098]),.data_in_1099(w[1099]),
                .data_in_1100(w[1100]),.data_in_1101(w[1101]),.data_in_1102(w[1102]),.data_in_1103(w[1103]),.data_in_1104(w[1104]),.data_in_1105(w[1105]),.data_in_1106(w[1106]),.data_in_1107(w[1107]),.data_in_1108(w[1108]),
                .data_in_1109(w[1109]),.data_in_1110(w[1110]),.data_in_1111(w[1111]),.data_in_1112(w[1112]),.data_in_1113(w[1113]),.data_in_1114(w[1114]),.data_in_1115(w[1115]),.data_in_1116(w[1116]),.data_in_1117(w[1117]),
                .data_in_1118(w[1118]),.data_in_1119(w[1119]),.data_in_1120(w[1120]),.data_in_1121(w[1121]),.data_in_1122(w[1122]),.data_in_1123(w[1123]),.data_in_1124(w[1124]),.data_in_1125(w[1125]),.data_in_1126(w[1126]),
                .data_in_1127(w[1127]),.data_in_1128(w[1128]),.data_in_1129(w[1129]),.data_in_1130(w[1130]),.data_in_1131(w[1131]),.data_in_1132(w[1132]),.data_in_1133(w[1133]),.data_in_1134(w[1134]),.data_in_1135(w[1135]),
                .data_in_1136(w[1136]),.data_in_1137(w[1137]),.data_in_1138(w[1138]),.data_in_1139(w[1139]),.data_in_1140(w[1140]),.data_in_1141(w[1141]),.data_in_1142(w[1142]),.data_in_1143(w[1143]),.data_in_1144(w[1144]),
                .data_in_1145(w[1145]),.data_in_1146(w[1146]),.data_in_1147(w[1147]),.data_in_1148(w[1148]),.data_in_1149(w[1149]),.data_in_1150(w[1150]),.data_in_1151(w[1151]),.data_in_1152(w[1152]),.data_in_1153(w[1153]),
                .data_in_1154(w[1154]),.data_in_1155(w[1155]),.data_in_1156(w[1156]),.data_in_1157(w[1157]),.data_in_1158(w[1158]),.data_in_1159(w[1159]),.data_in_1160(w[1160]),.data_in_1161(w[1161]),.data_in_1162(w[1162]),
                .data_in_1163(w[1163]),.data_in_1164(w[1164]),.data_in_1165(w[1165]),.data_in_1166(w[1166]),.data_in_1167(w[1167]),.data_in_1168(w[1168]),.data_in_1169(w[1169]),.data_in_1170(w[1170]),.data_in_1171(w[1171]),
                .data_in_1172(w[1172]),.data_in_1173(w[1173]),.data_in_1174(w[1174]),.data_in_1175(w[1175]),.data_in_1176(w[1176]),.data_in_1177(w[1177]),.data_in_1178(w[1178]),.data_in_1179(w[1179]),.data_in_1180(w[1180]),
                .data_in_1181(w[1181]),.data_in_1182(w[1182]),.data_in_1183(w[1183]),.data_in_1184(w[1184]),.data_in_1185(w[1185]),.data_in_1186(w[1186]),.data_in_1187(w[1187]),.data_in_1188(w[1188]),.data_in_1189(w[1189]),
                .data_in_1190(w[1190]),.data_in_1191(w[1191]),.data_in_1192(w[1192]),.data_in_1193(w[1193]),.data_in_1194(w[1194]),.data_in_1195(w[1195]),.data_in_1196(w[1196]),.data_in_1197(w[1197]),.data_in_1198(w[1198]),
                .data_in_1199(w[1199]),.data_in_1200(w[1200]),.data_in_1201(w[1201]),.data_in_1202(w[1202]),.data_in_1203(w[1203]),.data_in_1204(w[1204]),.data_in_1205(w[1205]),.data_in_1206(w[1206]),.data_in_1207(w[1207]),
                .data_in_1208(w[1208]),.data_in_1209(w[1209]),.data_in_1210(w[1210]),.data_in_1211(w[1211]),.data_in_1212(w[1212]),.data_in_1213(w[1213]),.data_in_1214(w[1214]),.data_in_1215(w[1215]),.data_in_1216(w[1216]),
                .data_in_1217(w[1217]),.data_in_1218(w[1218]),.data_in_1219(w[1219]),.data_in_1220(w[1220]),.data_in_1221(w[1221]),.data_in_1222(w[1222]),.data_in_1223(w[1223]),.data_in_1224(w[1224]),.data_in_1225(w[1225]),
                .data_in_1226(w[1226]),.data_in_1227(w[1227]),.data_in_1228(w[1228]),.data_in_1229(w[1229]),.data_in_1230(w[1230]),.data_in_1231(w[1231]),.data_in_1232(w[1232]),.data_in_1233(w[1233]),.data_in_1234(w[1234]),
                .data_in_1235(w[1235]),.data_in_1236(w[1236]),.data_in_1237(w[1237]),.data_in_1238(w[1238]),.data_in_1239(w[1239]),.data_in_1240(w[1240]),.data_in_1241(w[1241]),.data_in_1242(w[1242]),.data_in_1243(w[1243]),
                .data_in_1244(w[1244]),.data_in_1245(w[1245]),.data_in_1246(w[1246]),.data_in_1247(w[1247]),.data_in_1248(w[1248]),.data_in_1249(w[1249]),.data_in_1250(w[1250]),.data_in_1251(w[1251]),.data_in_1252(w[1252]),
                .data_in_1253(w[1253]),.data_in_1254(w[1254]),.data_in_1255(w[1255]),.data_in_1256(w[1256]),.data_in_1257(w[1257]),.data_in_1258(w[1258]),.data_in_1259(w[1259]),.data_in_1260(w[1260]),.data_in_1261(w[1261]),
                .data_in_1262(w[1262]),.data_in_1263(w[1263]),.data_in_1264(w[1264]),.data_in_1265(w[1265]),.data_in_1266(w[1266]),.data_in_1267(w[1267]),.data_in_1268(w[1268]),.data_in_1269(w[1269]),.data_in_1270(w[1270]),
                .data_in_1271(w[1271]),.data_in_1272(w[1272]),.data_in_1273(w[1273]),.data_in_1274(w[1274]),.data_in_1275(w[1275]),.data_in_1276(w[1276]),.data_in_1277(w[1277]),.data_in_1278(w[1278]),.data_in_1279(w[1279]),
                .data_in_1280(w[1280]),.data_in_1281(w[1281]),.data_in_1282(w[1282]),.data_in_1283(w[1283]),.data_in_1284(w[1284]),.data_in_1285(w[1285]),.data_in_1286(w[1286]),.data_in_1287(w[1287]),.data_in_1288(w[1288]),
                .data_in_1289(w[1289]),.data_in_1290(w[1290]),.data_in_1291(w[1291]),.data_in_1292(w[1292]),.data_in_1293(w[1293]),.data_in_1294(w[1294]),.data_in_1295(w[1295]),.data_in_1296(w[1296]),.data_in_1297(w[1297]),
                .data_in_1298(w[1298]),.data_in_1299(w[1299]),.data_in_1300(w[1300]),.data_in_1301(w[1301]),.data_in_1302(w[1302]),.data_in_1303(w[1303]),.data_in_1304(w[1304]),.data_in_1305(w[1305]),.data_in_1306(w[1306]),
                .data_in_1307(w[1307]),.data_in_1308(w[1308]),.data_in_1309(w[1309]),.data_in_1310(w[1310]),.data_in_1311(w[1311]),.data_in_1312(w[1312]),.data_in_1313(w[1313]),.data_in_1314(w[1314]),.data_in_1315(w[1315]),.data_in_1316(w[1316]),.data_in_1317(w[1317]),.data_in_1318(w[1318]),.data_in_1319(w[1319]),.data_in_1320(w[1320]),.data_in_1321(w[1321]),
                .data_in_1322(w[1322]),.data_in_1323(w[1323]),.data_in_1324(w[1324]),.data_in_1325(w[1325]),.data_in_1326(w[1326]),.data_in_1327(w[1327]),.data_in_1328(w[1328]),.data_in_1329(w[1329]),.data_in_1330(w[1330]),.data_in_1331(w[1331]),.data_in_1332(w[1332]),.data_in_1333(w[1333]),.data_in_1334(w[1334]),.data_in_1335(w[1335]),.data_in_1336(w[1336]),.data_in_1337(w[1337]),.data_in_1338(w[1338]),
                .data_in_1339(w[1339]),.data_in_1340(w[1340]),.data_in_1341(w[1341]),.data_in_1342(w[1342]),.data_in_1343(w[1343]),.data_in_1344(w[1344]),.data_in_1345(w[1345]),.data_in_1346(w[1346]),.data_in_1347(w[1347]),.data_in_1348(w[1348]),.data_in_1349(w[1349]),.data_in_1350(w[1350]),.data_in_1351(w[1351]),.data_in_1352(w[1352]),.data_in_1353(w[1353]),.data_in_1354(w[1354]),.data_in_1355(w[1355]),.data_in_1356(w[1356]),.data_in_1357(w[1357]),.data_in_1358(w[1358]),.data_in_1359(w[1359]),.data_in_1360(w[1360]),.data_in_1361(w[1361]),.data_in_1362(w[1362]),.data_in_1363(w[1363]),.data_in_1364(w[1364]),.data_in_1365(w[1365]),.data_in_1366(w[1366]),.data_in_1367(w[1367]),.data_in_1368(w[1368]),.data_in_1369(w[1369]),.data_in_1370(w[1370]),.data_in_1371(w[1371]),.data_in_1372(w[1372]),.data_in_1373(w[1373]),.data_in_1374(w[1374]),.data_in_1375(w[1375]),.data_in_1376(w[1376]),.data_in_1377(w[1377]),
                .data_in_1378(w[1378]),.data_in_1379(w[1379]),.data_in_1380(w[1380]),.data_in_1381(w[1381]),.data_in_1382(w[1382]),.data_in_1383(w[1383]),.data_in_1384(w[1384]),.data_in_1385(w[1385]),.data_in_1386(w[1386]),.data_in_1387(w[1387]),.data_in_1388(w[1388]),.data_in_1389(w[1389]),.data_in_1390(w[1390]),
                .data_in_1391(w[1391]),.data_in_1392(w[1392]),.data_in_1393(w[1393]),.data_in_1394(w[1394]),.data_in_1395(w[1395]),.data_in_1396(w[1396]),.data_in_1397(w[1397]),.data_in_1398(w[1398]),.data_in_1399(w[1399]),.data_in_1400(w[1400]),.data_in_1401(w[1401]),.data_in_1402(w[1402]),.data_in_1403(w[1403]),.data_in_1404(w[1404]),.data_in_1405(w[1405]),.data_in_1406(w[1406]),.data_in_1407(w[1407]),.data_in_1408(w[1408]),.data_in_1409(w[1409]),.data_in_1410(w[1410]),.data_in_1411(w[1411]),.data_in_1412(w[1412]),.data_in_1413(w[1413]),.data_in_1414(w[1414]),.data_in_1415(w[1415]),.data_in_1416(w[1416]),.data_in_1417(w[1417]),.data_in_1418(w[1418]),.data_in_1419(w[1419]),.data_in_1420(w[1420]),
                .data_in_1421(w[1421]),.data_in_1422(w[1422]),.data_in_1423(w[1423]),.data_in_1424(w[1424]),.data_in_1425(w[1425]),.data_in_1426(w[1426]),.data_in_1427(w[1427]),.data_in_1428(w[1428]),.data_in_1429(w[1429]),.data_in_1430(w[1430]),.data_in_1431(w[1431]),.data_in_1432(w[1432]),.data_in_1433(w[1433]),.data_in_1434(w[1434]),.data_in_1435(w[1435]),.data_in_1436(w[1436]),.data_in_1437(w[1437]),.data_in_1438(w[1438]),.data_in_1439(w[1439]),.data_in_1440(w[1440]),.data_in_1441(w[1441]),.data_in_1442(w[1442]),.data_in_1443(w[1443]),.data_in_1444(w[1444]),.data_in_1445(w[1445]),.data_in_1446(w[1446]),.data_in_1447(w[1447]),.data_in_1448(w[1448]),.data_in_1449(w[1449]),.data_in_1450(w[1450]),.data_in_1451(w[1451]),.data_in_1452(w[1452]),.data_in_1453(w[1453]),.data_in_1454(w[1454]),.data_in_1455(w[1455]),.data_in_1456(w[1456]),.data_in_1457(w[1457]),.data_in_1458(w[1458]),.data_in_1459(w[1459]),.data_in_1460(w[1460]),.data_in_1461(w[1461]),.data_in_1462(w[1462]),.data_in_1463(w[1463]),.data_in_1464(w[1464]),.data_in_1465(w[1465]),.data_in_1466(w[1466]),.data_in_1467(w[1467]),.data_in_1468(w[1468]),.data_in_1469(w[1469]),.data_in_1470(w[1470]),.data_in_1471(w[1471]),.data_in_1472(w[1472]),.data_in_1473(w[1473]),.data_in_1474(w[1474]),.data_in_1475(w[1475]),.data_in_1476(w[1476]),.data_in_1477(w[1477]),.data_in_1478(w[1478]),.data_in_1479(w[1479]),.data_in_1480(w[1480]),.data_in_1481(w[1481]),.data_in_1482(w[1482]),.data_in_1483(w[1483]),.data_in_1484(w[1484]),.data_in_1485(w[1485]),.data_in_1486(w[1486]),.data_in_1487(w[1487]),.data_in_1488(w[1488]),.data_in_1489(w[1489]),.data_in_1490(w[1490]),.data_in_1491(w[1491]),.data_in_1492(w[1492]),.data_in_1493(w[1493]),.data_in_1494(w[1494]),.data_in_1495(w[1495]),.data_in_1496(w[1496]),.data_in_1497(w[1497]),.data_in_1498(w[1498]),.data_in_1499(w[1499]),.data_in_1500(w[1500]),.data_in_1501(w[1501]),.data_in_1502(w[1502]),.data_in_1503(w[1503]),.data_in_1504(w[1504]),.data_in_1505(w[1505]),.data_in_1506(w[1506]),.data_in_1507(w[1507]),.data_in_1508(w[1508]),.data_in_1509(w[1509]),.data_in_1510(w[1510]),.data_in_1511(w[1511]),.data_in_1512(w[1512]),.data_in_1513(w[1513]),.data_in_1514(w[1514]),.data_in_1515(w[1515]),.data_in_1516(w[1516]),.data_in_1517(w[1517]),.data_in_1518(w[1518]),.data_in_1519(w[1519]),.data_in_1520(w[1520]),.data_in_1521(w[1521]),.data_in_1522(w[1522]),.data_in_1523(w[1523]),.data_in_1524(w[1524]),.data_in_1525(w[1525]),.data_in_1526(w[1526]),.data_in_1527(w[1527]),.data_in_1528(w[1528]),.data_in_1529(w[1529]),.data_in_1530(w[1530]),.data_in_1531(w[1531]),.data_in_1532(w[1532]),.data_in_1533(w[1533]),.data_in_1534(w[1534]),.data_in_1535(w[1535]),.data_in_1536(w[1536]),.data_in_1537(w[1537]),.data_in_1538(w[1538]),.data_in_1539(w[1539]),.data_in_1540(w[1540]),.data_in_1541(w[1541]),.data_in_1542(w[1542]),.data_in_1543(w[1543]),.data_in_1544(w[1544]),.data_in_1545(w[1545]),.data_in_1546(w[1546]),.data_in_1547(w[1547]),.data_in_1548(w[1548]),.data_in_1549(w[1549]),.data_in_1550(w[1550]),.data_in_1551(w[1551]),.data_in_1552(w[1552]),.data_in_1553(w[1553]),.data_in_1554(w[1554]),.data_in_1555(w[1555]),.data_in_1556(w[1556]),.data_in_1557(w[1557]),.data_in_1558(w[1558]),.data_in_1559(w[1559]),.data_in_1560(w[1560]),.data_in_1561(w[1561]),.data_in_1562(w[1562]),.data_in_1563(w[1563]),.data_in_1564(w[1564]),.data_in_1565(w[1565]),.data_in_1566(w[1566]),.data_in_1567(w[1567]),.data_in_1568(w[1568]),.data_in_1569(w[1569]),.data_in_1570(w[1570]),.data_in_1571(w[1571]),.data_in_1572(w[1572]),.data_in_1573(w[1573]),.data_in_1574(w[1574]),.data_in_1575(w[1575]),.data_in_1576(w[1576]),.data_in_1577(w[1577]),.data_in_1578(w[1578]),.data_in_1579(w[1579]),.data_in_1580(w[1580]),.data_in_1581(w[1581]),.data_in_1582(w[1582]),.data_in_1583(w[1583]),.data_in_1584(w[1584]),.data_in_1585(w[1585]),.data_in_1586(w[1586]),.data_in_1587(w[1587]),.data_in_1588(w[1588]),.data_in_1589(w[1589]),.data_in_1590(w[1590]),.data_in_1591(w[1591]),.data_in_1592(w[1592]),.data_in_1593(w[1593]),.data_in_1594(w[1594]),.data_in_1595(w[1595]),.data_in_1596(w[1596]),.data_in_1597(w[1597]),.data_in_1598(w[1598]),.data_in_1599(w[1599]),.data_in_1600(w[1600]),.data_in_1601(w[1601]),.data_in_1602(w[1602]),.data_in_1603(w[1603]),.data_in_1604(w[1604]),.data_in_1605(w[1605]),.data_in_1606(w[1606]),.data_in_1607(w[1607]),.data_in_1608(w[1608]),.data_in_1609(w[1609]),.data_in_1610(w[1610]),.data_in_1611(w[1611]),.data_in_1612(w[1612]),.data_in_1613(w[1613]),.data_in_1614(w[1614]),.data_in_1615(w[1615]),.data_in_1616(w[1616]),.data_in_1617(w[1617]),.data_in_1618(w[1618]),.data_in_1619(w[1619]),.data_in_1620(w[1620]),.data_in_1621(w[1621]),.data_in_1622(w[1622]),.data_in_1623(w[1623]),.data_in_1624(w[1624]),.data_in_1625(w[1625]),.data_in_1626(w[1626]),.data_in_1627(w[1627]),.data_in_1628(w[1628]),.data_in_1629(w[1629]),.data_in_1630(w[1630]),.data_in_1631(w[1631]),.data_in_1632(w[1632]),.data_in_1633(w[1633]),.data_in_1634(w[1634]),.data_in_1635(w[1635]),.data_in_1636(w[1636]),.data_in_1637(w[1637]),.data_in_1638(w[1638]),.data_in_1639(w[1639]),.data_in_1640(w[1640]),.data_in_1641(w[1641]),.data_in_1642(w[1642]),.data_in_1643(w[1643]),.data_in_1644(w[1644]),.data_in_1645(w[1645]),.data_in_1646(w[1646]),.data_in_1647(w[1647]),.data_in_1648(w[1648]),.data_in_1649(w[1649]),.data_in_1650(w[1650]),.data_in_1651(w[1651]),.data_in_1652(w[1652]),.data_in_1653(w[1653]),.data_in_1654(w[1654]),.data_in_1655(w[1655]),.data_in_1656(w[1656]),.data_in_1657(w[1657]),.data_in_1658(w[1658]),.data_in_1659(w[1659]),.data_in_1660(w[1660]),.data_in_1661(w[1661]),.data_in_1662(w[1662]),.data_in_1663(w[1663]),.data_in_1664(w[1664]),.data_in_1665(w[1665]),.data_in_1666(w[1666]),.data_in_1667(w[1667]),.data_in_1668(w[1668]),.data_in_1669(w[1669]),.data_in_1670(w[1670]),.data_in_1671(w[1671]),.data_in_1672(w[1672]),.data_in_1673(w[1673]),.data_in_1674(w[1674]),.data_in_1675(w[1675]),.data_in_1676(w[1676]),.data_in_1677(w[1677]),.data_in_1678(w[1678]),.data_in_1679(w[1679]),.data_in_1680(w[1680]),.data_in_1681(w[1681]),.data_in_1682(w[1682]),.data_in_1683(w[1683]),.data_in_1684(w[1684]),.data_in_1685(w[1685]),.data_in_1686(w[1686]),.data_in_1687(w[1687]),.data_in_1688(w[1688]),.data_in_1689(w[1689]),.data_in_1690(w[1690]),.data_in_1691(w[1691]),.data_in_1692(w[1692]),.data_in_1693(w[1693]),.data_in_1694(w[1694]),.data_in_1695(w[1695]),.data_in_1696(w[1696]),.data_in_1697(w[1697]),.data_in_1698(w[1698]),.data_in_1699(w[1699]),.data_in_1700(w[1700]),.data_in_1701(w[1701]),.data_in_1702(w[1702]),.data_in_1703(w[1703]),.data_in_1704(w[1704]),.data_in_1705(w[1705]),.data_in_1706(w[1706]),.data_in_1707(w[1707]),.data_in_1708(w[1708]),.data_in_1709(w[1709]),.data_in_1710(w[1710]),.data_in_1711(w[1711]),.data_in_1712(w[1712]),.data_in_1713(w[1713]),.data_in_1714(w[1714]),.data_in_1715(w[1715]),.data_in_1716(w[1716]),.data_in_1717(w[1717]),.data_in_1718(w[1718]),.data_in_1719(w[1719]),.data_in_1720(w[1720]),.data_in_1721(w[1721]),.data_in_1722(w[1722]),.data_in_1723(w[1723]),.data_in_1724(w[1724]),.data_in_1725(w[1725]),.data_in_1726(w[1726]),.data_in_1727(w[1727]),.data_in_1728(w[1728]),.data_in_1729(w[1729]),.data_in_1730(w[1730]),.data_in_1731(w[1731]),.data_in_1732(w[1732]),.data_in_1733(w[1733]),.data_in_1734(w[1734]),.data_in_1735(w[1735]),.data_in_1736(w[1736]),.data_in_1737(w[1737]),.data_in_1738(w[1738]),.data_in_1739(w[1739]),.data_in_1740(w[1740]),.data_in_1741(w[1741]),.data_in_1742(w[1742]),.data_in_1743(w[1743]),.data_in_1744(w[1744]),.data_in_1745(w[1745]),.data_in_1746(w[1746]),.data_in_1747(w[1747]),.data_in_1748(w[1748]),.data_in_1749(w[1749]),.data_in_1750(w[1750]),.data_in_1751(w[1751]),.data_in_1752(w[1752]),.data_in_1753(w[1753]),.data_in_1754(w[1754]),.data_in_1755(w[1755]),.data_in_1756(w[1756]),.data_in_1757(w[1757]),.data_in_1758(w[1758]),.data_in_1759(w[1759]),.data_in_1760(w[1760]),.data_in_1761(w[1761]),.data_in_1762(w[1762]),.data_in_1763(w[1763]),.data_in_1764(w[1764]),.data_in_1765(w[1765]),.data_in_1766(w[1766]),.data_in_1767(w[1767]),.data_in_1768(w[1768]),.data_in_1769(w[1769]),.data_in_1770(w[1770]),.data_in_1771(w[1771]),.data_in_1772(w[1772]),.data_in_1773(w[1773]),.data_in_1774(w[1774]),.data_in_1775(w[1775]),.data_in_1776(w[1776]),.data_in_1777(w[1777]),.data_in_1778(w[1778]),.data_in_1779(w[1779]),.data_in_1780(w[1780]),.data_in_1781(w[1781]),.data_in_1782(w[1782]),.data_in_1783(w[1783]),.data_in_1784(w[1784]),.data_in_1785(w[1785]),.data_in_1786(w[1786]),.data_in_1787(w[1787]),.data_in_1788(w[1788]),.data_in_1789(w[1789]),.data_in_1790(w[1790]),.data_in_1791(w[1791]),.data_in_1792(w[1792]),.data_in_1793(w[1793]),.data_in_1794(w[1794]),.data_in_1795(w[1795]),.data_in_1796(w[1796]),.data_in_1797(w[1797]),.data_in_1798(w[1798]),.data_in_1799(w[1799]),.data_in_1800(w[1800]),.data_in_1801(w[1801]),.data_in_1802(w[1802]),.data_in_1803(w[1803]),.data_in_1804(w[1804]),.data_in_1805(w[1805]),.data_in_1806(w[1806]),.data_in_1807(w[1807]),.data_in_1808(w[1808]),.data_in_1809(w[1809]),.data_in_1810(w[1810]),.data_in_1811(w[1811]),.data_in_1812(w[1812]),.data_in_1813(w[1813]),.data_in_1814(w[1814]),.data_in_1815(w[1815]),.data_in_1816(w[1816]),.data_in_1817(w[1817]),.data_in_1818(w[1818]),.data_in_1819(w[1819]),.data_in_1820(w[1820]),.data_in_1821(w[1821]),.data_in_1822(w[1822]),.data_in_1823(w[1823]),.data_in_1824(w[1824]),.data_in_1825(w[1825]),.data_in_1826(w[1826]),.data_in_1827(w[1827]),.data_in_1828(w[1828]),.data_in_1829(w[1829]),.data_in_1830(w[1830]),.data_in_1831(w[1831]),.data_in_1832(w[1832]),.data_in_1833(w[1833]),.data_in_1834(w[1834]),.data_in_1835(w[1835]),.data_in_1836(w[1836]),.data_in_1837(w[1837]),.data_in_1838(w[1838]),.data_in_1839(w[1839]),.data_in_1840(w[1840]),.data_in_1841(w[1841]),.data_in_1842(w[1842]),.data_in_1843(w[1843]),.data_in_1844(w[1844]),.data_in_1845(w[1845]),.data_in_1846(w[1846]),.data_in_1847(w[1847]),.data_in_1848(w[1848]),.data_in_1849(w[1849]),.data_in_1850(w[1850]),.data_in_1851(w[1851]),.data_in_1852(w[1852]),.data_in_1853(w[1853]),.data_in_1854(w[1854]),.data_in_1855(w[1855]),.data_in_1856(w[1856]),.data_in_1857(w[1857]),.data_in_1858(w[1858]),.data_in_1859(w[1859]),.data_in_1860(w[1860]),.data_in_1861(w[1861]),.data_in_1862(w[1862]),.data_in_1863(w[1863]),.data_in_1864(w[1864]),.data_in_1865(w[1865]),.data_in_1866(w[1866]),.data_in_1867(w[1867]),.data_in_1868(w[1868]),.data_in_1869(w[1869]),.data_in_1870(w[1870]),.data_in_1871(w[1871]),.data_in_1872(w[1872]),.data_in_1873(w[1873]),.data_in_1874(w[1874]),.data_in_1875(w[1875]),.data_in_1876(w[1876]),.data_in_1877(w[1877]),.data_in_1878(w[1878]),.data_in_1879(w[1879]),.data_in_1880(w[1880]),.data_in_1881(w[1881]),.data_in_1882(w[1882]),.data_in_1883(w[1883]),.data_in_1884(w[1884]),.data_in_1885(w[1885]),.data_in_1886(w[1886]),.data_in_1887(w[1887]),.data_in_1888(w[1888]),.data_in_1889(w[1889]),.data_in_1890(w[1890]),.data_in_1891(w[1891]),.data_in_1892(w[1892]),.data_in_1893(w[1893]),.data_in_1894(w[1894]),.data_in_1895(w[1895]),.data_in_1896(w[1896]),.data_in_1897(w[1897]),.data_in_1898(w[1898]),.data_in_1899(w[1899]),.data_in_1900(w[1900]),.data_in_1901(w[1901]),.data_in_1902(w[1902]),.data_in_1903(w[1903]),.data_in_1904(w[1904]),.data_in_1905(w[1905]),.data_in_1906(w[1906]),.data_in_1907(w[1907]),.data_in_1908(w[1908]),.data_in_1909(w[1909]),.data_in_1910(w[1910]),.data_in_1911(w[1911]),.data_in_1912(w[1912]),.data_in_1913(w[1913]),.data_in_1914(w[1914]),.data_in_1915(w[1915]),.data_in_1916(w[1916]),.data_in_1917(w[1917]),.data_in_1918(w[1918]),.data_in_1919(w[1919]),.data_in_1920(w[1920]),.data_in_1921(w[1921]),.data_in_1922(w[1922]),.data_in_1923(w[1923]),.data_in_1924(w[1924]),.data_in_1925(w[1925]),.data_in_1926(w[1926]),.data_in_1927(w[1927]),.data_in_1928(w[1928]),.data_in_1929(w[1929]),.data_in_1930(w[1930]),.data_in_1931(w[1931]),.data_in_1932(w[1932]),.data_in_1933(w[1933]),.data_in_1934(w[1934]),.data_in_1935(w[1935]),.data_in_1936(w[1936]),.data_in_1937(w[1937]),.data_in_1938(w[1938]),.data_in_1939(w[1939]),.data_in_1940(w[1940]),.data_in_1941(w[1941]),.data_in_1942(w[1942]),.data_in_1943(w[1943]),.data_in_1944(w[1944]),.data_in_1945(w[1945]),.data_in_1946(w[1946]),.data_in_1947(w[1947]),.data_in_1948(w[1948]),.data_in_1949(w[1949]),.data_in_1950(w[1950]),.data_in_1951(w[1951]),.data_in_1952(w[1952]),.data_in_1953(w[1953]),.data_in_1954(w[1954]),.data_in_1955(w[1955]),.data_in_1956(w[1956]),.data_in_1957(w[1957]),.data_in_1958(w[1958]),.data_in_1959(w[1959]),.data_in_1960(w[1960]),.data_in_1961(w[1961]),.data_in_1962(w[1962]),.data_in_1963(w[1963]),.data_in_1964(w[1964]),.data_in_1965(w[1965]),.data_in_1966(w[1966]),.data_in_1967(w[1967]),.data_in_1968(w[1968]),.data_in_1969(w[1969]),.data_in_1970(w[1970]),.data_in_1971(w[1971]),.data_in_1972(w[1972]),.data_in_1973(w[1973]),.data_in_1974(w[1974]),.data_in_1975(w[1975]),.data_in_1976(w[1976]),.data_in_1977(w[1977]),.data_in_1978(w[1978]),.data_in_1979(w[1979]),.data_in_1980(w[1980]),.data_in_1981(w[1981]),.data_in_1982(w[1982]),.data_in_1983(w[1983]),.data_in_1984(w[1984]),.data_in_1985(w[1985]),.data_in_1986(w[1986]),.data_in_1987(w[1987]),.data_in_1988(w[1988]),.data_in_1989(w[1989]),.data_in_1990(w[1990]),.data_in_1991(w[1991]),.data_in_1992(w[1992]),.data_in_1993(w[1993]),.data_in_1994(w[1994]),.data_in_1995(w[1995]),.data_in_1996(w[1996]),.data_in_1997(w[1997]),.data_in_1998(w[1998]),.data_in_1999(w[1999]),.data_in_2000(w[2000]),.data_in_2001(w[2001]),.data_in_2002(w[2002]),.data_in_2003(w[2003]),.data_in_2004(w[2004]),.data_in_2005(w[2005]),.data_in_2006(w[2006]),.data_in_2007(w[2007]),.data_in_2008(w[2008]),.data_in_2009(w[2009]),.data_in_2010(w[2010]),.data_in_2011(w[2011]),.data_in_2012(w[2012]),.data_in_2013(w[2013]),.data_in_2014(w[2014]),.data_in_2015(w[2015]),.data_in_2016(w[2016]),.data_in_2017(w[2017]),.data_in_2018(w[2018]),.data_in_2019(w[2019]),.data_in_2020(w[2020]),.data_in_2021(w[2021]),.data_in_2022(w[2022]),.data_in_2023(w[2023]),.data_in_2024(w[2024]),.data_in_2025(w[2025]),.data_in_2026(w[2026]),.data_in_2027(w[2027]),.data_in_2028(w[2028]),.data_in_2029(w[2029]),.data_in_2030(w[2030]),.data_in_2031(w[2031]),.data_in_2032(w[2032]),.data_in_2033(w[2033]),.data_in_2034(w[2034]),.data_in_2035(w[2035]),.data_in_2036(w[2036]),.data_in_2037(w[2037]),.data_in_2038(w[2038]),.data_in_2039(w[2039]),.data_in_2040(w[2040]),.data_in_2041(w[2041]),.data_in_2042(w[2042]),.data_in_2043(w[2043]),.data_in_2044(w[2044]),.data_in_2045(w[2045]),.data_in_2046(w[2046]),.data_in_2047(w[2047]),.data_in_2048(w[2048]),.data_in_2049(w[2049]),.data_in_2050(w[2050]),.data_in_2051(w[2051]),.data_in_2052(w[2052]),.data_in_2053(w[2053]),.data_in_2054(w[2054]),.data_in_2055(w[2055]),.data_in_2056(w[2056]),.data_in_2057(w[2057]),.data_in_2058(w[2058]),.data_in_2059(w[2059]),.data_in_2060(w[2060]),.data_in_2061(w[2061]),.data_in_2062(w[2062]),.data_in_2063(w[2063]),.data_in_2064(w[2064]),.data_in_2065(w[2065]),.data_in_2066(w[2066]),.data_in_2067(w[2067]),.data_in_2068(w[2068]),.data_in_2069(w[2069]),.data_in_2070(w[2070]),.data_in_2071(w[2071]),.data_in_2072(w[2072]),.data_in_2073(w[2073]),.data_in_2074(w[2074]),.data_in_2075(w[2075]),.data_in_2076(w[2076]),.data_in_2077(w[2077]),.data_in_2078(w[2078]),.data_in_2079(w[2079]),.data_in_2080(w[2080]),.data_in_2081(w[2081]),.data_in_2082(w[2082]),.data_in_2083(w[2083]),.data_in_2084(w[2084]),.data_in_2085(w[2085]),.data_in_2086(w[2086]),.data_in_2087(w[2087]),.data_in_2088(w[2088]),.data_in_2089(w[2089]),.data_in_2090(w[2090]),.data_in_2091(w[2091]),.data_in_2092(w[2092]),.data_in_2093(w[2093]),.data_in_2094(w[2094]),.data_in_2095(w[2095]),.data_in_2096(w[2096]),.data_in_2097(w[2097]),.data_in_2098(w[2098]),.data_in_2099(w[2099]),.data_in_2100(w[2100]),.data_in_2101(w[2101]),.data_in_2102(w[2102]),.data_in_2103(w[2103]),.data_in_2104(w[2104]),.data_in_2105(w[2105]),.data_in_2106(w[2106]),.data_in_2107(w[2107]),.data_in_2108(w[2108]),.data_in_2109(w[2109]),.data_in_2110(w[2110]),.data_in_2111(w[2111]),.data_in_2112(w[2112]),.data_in_2113(w[2113]),.data_in_2114(w[2114]),.data_in_2115(w[2115]),.data_in_2116(w[2116]),.data_in_2117(w[2117]),.data_in_2118(w[2118]),.data_in_2119(w[2119]),.data_in_2120(w[2120]),.data_in_2121(w[2121]),.data_in_2122(w[2122]),.data_in_2123(w[2123]),.data_in_2124(w[2124]),.data_in_2125(w[2125]),.data_in_2126(w[2126]),.data_in_2127(w[2127]),.data_in_2128(w[2128]),.data_in_2129(w[2129]),.data_in_2130(w[2130]),.data_in_2131(w[2131]),.data_in_2132(w[2132]),.data_in_2133(w[2133]),.data_in_2134(w[2134]),.data_in_2135(w[2135]),.data_in_2136(w[2136]),.data_in_2137(w[2137]),.data_in_2138(w[2138]),.data_in_2139(w[2139]),.data_in_2140(w[2140]),.data_in_2141(w[2141]),.data_in_2142(w[2142]),.data_in_2143(w[2143]),.data_in_2144(w[2144]),.data_in_2145(w[2145]),.data_in_2146(w[2146]),.data_in_2147(w[2147]),.data_in_2148(w[2148]),.data_in_2149(w[2149]),.data_in_2150(w[2150]),.data_in_2151(w[2151]),.data_in_2152(w[2152]),.data_in_2153(w[2153]),.data_in_2154(w[2154]),.data_in_2155(w[2155]),.data_in_2156(w[2156]),.data_in_2157(w[2157]),.data_in_2158(w[2158]),.data_in_2159(w[2159]),.data_in_2160(w[2160]),.data_in_2161(w[2161]),.data_in_2162(w[2162]),.data_in_2163(w[2163]),.data_in_2164(w[2164]),.data_in_2165(w[2165]),.data_in_2166(w[2166]),.data_in_2167(w[2167]),.data_in_2168(w[2168]),.data_in_2169(w[2169]),.data_in_2170(w[2170]),.data_in_2171(w[2171]),.data_in_2172(w[2172]),.data_in_2173(w[2173]),.data_in_2174(w[2174]),.data_in_2175(w[2175]),.data_in_2176(w[2176]),.data_in_2177(w[2177]),.data_in_2178(w[2178]),.data_in_2179(w[2179]),.data_in_2180(w[2180]),.data_in_2181(w[2181]),.data_in_2182(w[2182]),.data_in_2183(w[2183]),.data_in_2184(w[2184]),.data_in_2185(w[2185]),.data_in_2186(w[2186]),.data_in_2187(w[2187]),.data_in_2188(w[2188]),.data_in_2189(w[2189]),.data_in_2190(w[2190]),.data_in_2191(w[2191]),.data_in_2192(w[2192]),.data_in_2193(w[2193]),.data_in_2194(w[2194]),.data_in_2195(w[2195]),.data_in_2196(w[2196]),.data_in_2197(w[2197]),.data_in_2198(w[2198]),.data_in_2199(w[2199]),.data_in_2200(w[2200]),.data_in_2201(w[2201]),.data_in_2202(w[2202]),.data_in_2203(w[2203]),.data_in_2204(w[2204]),.data_in_2205(w[2205]),.data_in_2206(w[2206]),.data_in_2207(w[2207]),.data_in_2208(w[2208]),.data_in_2209(w[2209]),.data_in_2210(w[2210]),.data_in_2211(w[2211]),.data_in_2212(w[2212]),.data_in_2213(w[2213]),.data_in_2214(w[2214]),.data_in_2215(w[2215]),.data_in_2216(w[2216]),.data_in_2217(w[2217]),.data_in_2218(w[2218]),.data_in_2219(w[2219]),.data_in_2220(w[2220]),.data_in_2221(w[2221]),.data_in_2222(w[2222]),.data_in_2223(w[2223]),.data_in_2224(w[2224]),.data_in_2225(w[2225]),.data_in_2226(w[2226]),.data_in_2227(w[2227]),.data_in_2228(w[2228]),.data_in_2229(w[2229]),.data_in_2230(w[2230]),.data_in_2231(w[2231]),.data_in_2232(w[2232]),.data_in_2233(w[2233]),.data_in_2234(w[2234]),.data_in_2235(w[2235]),.data_in_2236(w[2236]),.data_in_2237(w[2237]),.data_in_2238(w[2238]),.data_in_2239(w[2239]),.data_in_2240(w[2240]),.data_in_2241(w[2241]),.data_in_2242(w[2242]),.data_in_2243(w[2243]),.data_in_2244(w[2244]),.data_in_2245(w[2245]),.data_in_2246(w[2246]),.data_in_2247(w[2247]),.data_in_2248(w[2248]),.data_in_2249(w[2249]),.data_in_2250(w[2250]),.data_in_2251(w[2251]),.data_in_2252(w[2252]),.data_in_2253(w[2253]),.data_in_2254(w[2254]),.data_in_2255(w[2255]),.data_in_2256(w[2256]),.data_in_2257(w[2257]),.data_in_2258(w[2258]),.data_in_2259(w[2259]),.data_in_2260(w[2260]),.data_in_2261(w[2261]),.data_in_2262(w[2262]),.data_in_2263(w[2263]),.data_in_2264(w[2264]),.data_in_2265(w[2265]),.data_in_2266(w[2266]),.data_in_2267(w[2267]),.data_in_2268(w[2268]),.data_in_2269(w[2269]),.data_in_2270(w[2270]),.data_in_2271(w[2271]),.data_in_2272(w[2272]),.data_in_2273(w[2273]),.data_in_2274(w[2274]),.data_in_2275(w[2275]),.data_in_2276(w[2276]),.data_in_2277(w[2277]),.data_in_2278(w[2278]),.data_in_2279(w[2279]),.data_in_2280(w[2280]),.data_in_2281(w[2281]),.data_in_2282(w[2282]),.data_in_2283(w[2283]),.data_in_2284(w[2284]),.data_in_2285(w[2285]),.data_in_2286(w[2286]),.data_in_2287(w[2287]),.data_in_2288(w[2288]),.data_in_2289(w[2289]),.data_in_2290(w[2290]),.data_in_2291(w[2291]),.data_in_2292(w[2292]),.data_in_2293(w[2293]),.data_in_2294(w[2294]),.data_in_2295(w[2295]),.data_in_2296(w[2296]),.data_in_2297(w[2297]),.data_in_2298(w[2298]),.data_in_2299(w[2299]),.data_in_2300(w[2300]),.data_in_2301(w[2301]),.data_in_2302(w[2302]),.data_in_2303(w[2303]),.data_in_2304(w[2304]),.data_in_2305(w[2305]),.data_in_2306(w[2306]),.data_in_2307(w[2307]),.data_in_2308(w[2308]),.data_in_2309(w[2309]),.data_in_2310(w[2310]),.data_in_2311(w[2311]),.data_in_2312(w[2312]),.data_in_2313(w[2313]),.data_in_2314(w[2314]),.data_in_2315(w[2315]),.data_in_2316(w[2316]),.data_in_2317(w[2317]),.data_in_2318(w[2318]),.data_in_2319(w[2319]),.data_in_2320(w[2320]),.data_in_2321(w[2321]),.data_in_2322(w[2322]),.data_in_2323(w[2323]),.data_in_2324(w[2324]),.data_in_2325(w[2325]),.data_in_2326(w[2326]),.data_in_2327(w[2327]),.data_in_2328(w[2328]),.data_in_2329(w[2329]),.data_in_2330(w[2330]),.data_in_2331(w[2331]),.data_in_2332(w[2332]),.data_in_2333(w[2333]),.data_in_2334(w[2334]),.data_in_2335(w[2335]),.data_in_2336(w[2336]),.data_in_2337(w[2337]),.data_in_2338(w[2338]),.data_in_2339(w[2339]),.data_in_2340(w[2340]),.data_in_2341(w[2341]),.data_in_2342(w[2342]),.data_in_2343(w[2343]),.data_in_2344(w[2344]),.data_in_2345(w[2345]),.data_in_2346(w[2346]),.data_in_2347(w[2347]),.data_in_2348(w[2348]),.data_in_2349(w[2349]),.data_in_2350(w[2350]),.data_in_2351(w[2351]),.data_in_2352(w[2352]),.data_in_2353(w[2353]),.data_in_2354(w[2354]),.data_in_2355(w[2355]),.data_in_2356(w[2356]),.data_in_2357(w[2357]),.data_in_2358(w[2358]),.data_in_2359(w[2359]),.data_in_2360(w[2360]),.data_in_2361(w[2361]),.data_in_2362(w[2362]),.data_in_2363(w[2363]),.data_in_2364(w[2364]),.data_in_2365(w[2365]),.data_in_2366(w[2366]),.data_in_2367(w[2367]),.data_in_2368(w[2368]),.data_in_2369(w[2369]),.data_in_2370(w[2370]),.data_in_2371(w[2371]),.data_in_2372(w[2372]),.data_in_2373(w[2373]),.data_in_2374(w[2374]),.data_in_2375(w[2375]),.data_in_2376(w[2376]),.data_in_2377(w[2377]),.data_in_2378(w[2378]),.data_in_2379(w[2379]),.data_in_2380(w[2380]),.data_in_2381(w[2381]),.data_in_2382(w[2382]),.data_in_2383(w[2383]),.data_in_2384(w[2384]),.data_in_2385(w[2385]),.data_in_2386(w[2386]),.data_in_2387(w[2387]),.data_in_2388(w[2388]),.data_in_2389(w[2389]),.data_in_2390(w[2390]),.data_in_2391(w[2391]),.data_in_2392(w[2392]),.data_in_2393(w[2393]),.data_in_2394(w[2394]),.data_in_2395(w[2395]),.data_in_2396(w[2396]),.data_in_2397(w[2397]),.data_in_2398(w[2398]),.data_in_2399(w[2399]),.data_in_2400(w[2400]),.data_in_2401(w[2401]),.data_in_2402(w[2402]),.data_in_2403(w[2403]),.data_in_2404(w[2404]),.data_in_2405(w[2405]),.data_in_2406(w[2406]),.data_in_2407(w[2407]),.data_in_2408(w[2408]),.data_in_2409(w[2409]),.data_in_2410(w[2410]),.data_in_2411(w[2411]),.data_in_2412(w[2412]),.data_in_2413(w[2413]),.data_in_2414(w[2414]),.data_in_2415(w[2415]),.data_in_2416(w[2416]),.data_in_2417(w[2417]),.data_in_2418(w[2418]),.data_in_2419(w[2419]),.data_in_2420(w[2420]),.data_in_2421(w[2421]),.data_in_2422(w[2422]),.data_in_2423(w[2423]),.data_in_2424(w[2424]),.data_in_2425(w[2425]),.data_in_2426(w[2426]),.data_in_2427(w[2427]),.data_in_2428(w[2428]),.data_in_2429(w[2429]),.data_in_2430(w[2430]),.data_in_2431(w[2431]),.data_in_2432(w[2432]),.data_in_2433(w[2433]),.data_in_2434(w[2434]),.data_in_2435(w[2435]),.data_in_2436(w[2436]),.data_in_2437(w[2437]),.data_in_2438(w[2438]),.data_in_2439(w[2439]),.data_in_2440(w[2440]),.data_in_2441(w[2441]),.data_in_2442(w[2442]),.data_in_2443(w[2443]),.data_in_2444(w[2444]),.data_in_2445(w[2445]),.data_in_2446(w[2446]),.data_in_2447(w[2447]),.data_in_2448(w[2448]),.data_in_2449(w[2449]),.data_in_2450(w[2450]),.data_in_2451(w[2451]),.data_in_2452(w[2452]),.data_in_2453(w[2453]),.data_in_2454(w[2454]),.data_in_2455(w[2455]),.data_in_2456(w[2456]),.data_in_2457(w[2457]),.data_in_2458(w[2458]),.data_in_2459(w[2459]),.data_in_2460(w[2460]),.data_in_2461(w[2461]),.data_in_2462(w[2462]),.data_in_2463(w[2463]),.data_in_2464(w[2464]),.data_in_2465(w[2465]),.data_in_2466(w[2466]),.data_in_2467(w[2467]),.data_in_2468(w[2468]),.data_in_2469(w[2469]),.data_in_2470(w[2470]),.data_in_2471(w[2471]),.data_in_2472(w[2472]),.data_in_2473(w[2473]),.data_in_2474(w[2474]),.data_in_2475(w[2475]),.data_in_2476(w[2476]),.data_in_2477(w[2477]),.data_in_2478(w[2478]),.data_in_2479(w[2479]),.data_in_2480(w[2480]),.data_in_2481(w[2481]),.data_in_2482(w[2482]),.data_in_2483(w[2483]),.data_in_2484(w[2484]),.data_in_2485(w[2485]),.data_in_2486(w[2486]),.data_in_2487(w[2487]),.data_in_2488(w[2488]),.data_in_2489(w[2489]),.data_in_2490(w[2490]),.data_in_2491(w[2491]),.data_in_2492(w[2492]),.data_in_2493(w[2493]),.data_in_2494(w[2494]),.data_in_2495(w[2495]),.data_in_2496(w[2496]),.data_in_2497(w[2497]),.data_in_2498(w[2498]),.data_in_2499(w[2499]),.data_in_2500(w[2500]),.data_in_2501(w[2501]),.data_in_2502(w[2502]),.data_in_2503(w[2503]),.data_in_2504(w[2504]),.data_in_2505(w[2505]),.data_in_2506(w[2506]),.data_in_2507(w[2507]),.data_in_2508(w[2508]),.data_in_2509(w[2509]),.data_in_2510(w[2510]),.data_in_2511(w[2511]),.data_in_2512(w[2512]),.data_in_2513(w[2513]),.data_in_2514(w[2514]),.data_in_2515(w[2515]),.data_in_2516(w[2516]),.data_in_2517(w[2517]),.data_in_2518(w[2518]),.data_in_2519(w[2519]),.data_in_2520(w[2520]),.data_in_2521(w[2521]),.data_in_2522(w[2522]),.data_in_2523(w[2523]),.data_in_2524(w[2524]),.data_in_2525(w[2525]),.data_in_2526(w[2526]),.data_in_2527(w[2527]),.data_in_2528(w[2528]),.data_in_2529(w[2529]),.data_in_2530(w[2530]),.data_in_2531(w[2531]),.data_in_2532(w[2532]),.data_in_2533(w[2533]),.data_in_2534(w[2534]),.data_in_2535(w[2535]),.data_in_2536(w[2536]),.data_in_2537(w[2537]),.data_in_2538(w[2538]),.data_in_2539(w[2539]),.data_in_2540(w[2540]),.data_in_2541(w[2541]),.data_in_2542(w[2542]),.data_in_2543(w[2543]),.data_in_2544(w[2544]),.data_in_2545(w[2545]),.data_in_2546(w[2546]),.data_in_2547(w[2547]),.data_in_2548(w[2548]),.data_in_2549(w[2549]),.data_in_2550(w[2550]),.data_in_2551(w[2551]),.data_in_2552(w[2552]),.data_in_2553(w[2553]),.data_in_2554(w[2554]),.data_in_2555(w[2555]),.data_in_2556(w[2556]),.data_in_2557(w[2557]),.data_in_2558(w[2558]),.data_in_2559(w[2559]),.data_in_2560(w[2560]),.data_in_2561(w[2561]),.data_in_2562(w[2562]),.data_in_2563(w[2563]),.data_in_2564(w[2564]),.data_in_2565(w[2565]),.data_in_2566(w[2566]),.data_in_2567(w[2567]),.data_in_2568(w[2568]),.data_in_2569(w[2569]),.data_in_2570(w[2570]),.data_in_2571(w[2571]),.data_in_2572(w[2572]),.data_in_2573(w[2573]),.data_in_2574(w[2574]),.data_in_2575(w[2575]),.data_in_2576(w[2576]),.data_in_2577(w[2577]),.data_in_2578(w[2578]),.data_in_2579(w[2579]),.data_in_2580(w[2580]),.data_in_2581(w[2581]),.data_in_2582(w[2582]),.data_in_2583(w[2583]),.data_in_2584(w[2584]),.data_in_2585(w[2585]),.data_in_2586(w[2586]),.data_in_2587(w[2587]),.data_in_2588(w[2588]),.data_in_2589(w[2589]),.data_in_2590(w[2590]),.data_in_2591(w[2591]),.data_in_2592(w[2592]),.data_in_2593(w[2593]),.data_in_2594(w[2594]),.data_in_2595(w[2595]),.data_in_2596(w[2596]),.data_in_2597(w[2597]),.data_in_2598(w[2598]),.data_in_2599(w[2599]),.data_in_2600(w[2600]),.data_in_2601(w[2601]),.data_in_2602(w[2602]),.data_in_2603(w[2603]),.data_in_2604(w[2604]),.data_in_2605(w[2605]),.data_in_2606(w[2606]),.data_in_2607(w[2607]),.data_in_2608(w[2608]),.data_in_2609(w[2609]),.data_in_2610(w[2610]),.data_in_2611(w[2611]),.data_in_2612(w[2612]),.data_in_2613(w[2613]),.data_in_2614(w[2614]),.data_in_2615(w[2615]),.data_in_2616(w[2616]),.data_in_2617(w[2617]),.data_in_2618(w[2618]),.data_in_2619(w[2619]),.data_in_2620(w[2620]),.data_in_2621(w[2621]),.data_in_2622(w[2622]),.data_in_2623(w[2623]),.data_in_2624(w[2624]),.data_in_2625(w[2625]),.data_in_2626(w[2626]),.data_in_2627(w[2627]),.data_in_2628(w[2628]),.data_in_2629(w[2629]),.data_in_2630(w[2630]),.data_in_2631(w[2631]),.data_in_2632(w[2632]),.data_in_2633(w[2633]),.data_in_2634(w[2634]),.data_in_2635(w[2635]),.data_in_2636(w[2636]),.data_in_2637(w[2637]),.data_in_2638(w[2638]),.data_in_2639(w[2639]),.data_in_2640(w[2640]),.data_in_2641(w[2641]),.data_in_2642(w[2642]),.data_in_2643(w[2643]),.data_in_2644(w[2644]),.data_in_2645(w[2645]),.data_in_2646(w[2646]),.data_in_2647(w[2647]),.data_in_2648(w[2648]),.data_in_2649(w[2649]),.data_in_2650(w[2650]),.data_in_2651(w[2651]),.data_in_2652(w[2652]),.data_in_2653(w[2653]),.data_in_2654(w[2654]),.data_in_2655(w[2655]),.data_in_2656(w[2656]),.data_in_2657(w[2657]),.data_in_2658(w[2658]),.data_in_2659(w[2659]),.data_in_2660(w[2660]),.data_in_2661(w[2661]),.data_in_2662(w[2662]),.data_in_2663(w[2663]),.data_in_2664(w[2664]),.data_in_2665(w[2665]),.data_in_2666(w[2666]),.data_in_2667(w[2667]),.data_in_2668(w[2668]),.data_in_2669(w[2669]),.data_in_2670(w[2670]),.data_in_2671(w[2671]),.data_in_2672(w[2672]),.data_in_2673(w[2673]),.data_in_2674(w[2674]),.data_in_2675(w[2675]),.data_in_2676(w[2676]),.data_in_2677(w[2677]),.data_in_2678(w[2678]),.data_in_2679(w[2679]),.data_in_2680(w[2680]),.data_in_2681(w[2681]),.data_in_2682(w[2682]),.data_in_2683(w[2683]),.data_in_2684(w[2684]),.data_in_2685(w[2685]),.data_in_2686(w[2686]),.data_in_2687(w[2687]),.data_in_2688(w[2688]),.data_in_2689(w[2689]),.data_in_2690(w[2690]),.data_in_2691(w[2691]),.data_in_2692(w[2692]),.data_in_2693(w[2693]),.data_in_2694(w[2694]),.data_in_2695(w[2695]),.data_in_2696(w[2696]),.data_in_2697(w[2697]),.data_in_2698(w[2698]),.data_in_2699(w[2699]),.data_in_2700(w[2700]),.data_in_2701(w[2701]),.data_in_2702(w[2702]),.data_in_2703(w[2703]),.data_in_2704(w[2704]),.data_in_2705(w[2705]),.data_in_2706(w[2706]),.data_in_2707(w[2707]),.data_in_2708(w[2708]),.data_in_2709(w[2709]),.data_in_2710(w[2710]),.data_in_2711(w[2711]),.data_in_2712(w[2712]),.data_in_2713(w[2713]),.data_in_2714(w[2714]),.data_in_2715(w[2715]),.data_in_2716(w[2716]),.data_in_2717(w[2717]),.data_in_2718(w[2718]),.data_in_2719(w[2719]),.data_in_2720(w[2720]),.data_in_2721(w[2721]),.data_in_2722(w[2722]),.data_in_2723(w[2723]),.data_in_2724(w[2724]),.data_in_2725(w[2725]),.data_in_2726(w[2726]),.data_in_2727(w[2727]),.data_in_2728(w[2728]),.data_in_2729(w[2729]),.data_in_2730(w[2730]),.data_in_2731(w[2731]),.data_in_2732(w[2732]),.data_in_2733(w[2733]),.data_in_2734(w[2734]),.data_in_2735(w[2735]),.data_in_2736(w[2736]),.data_in_2737(w[2737]),.data_in_2738(w[2738]),.data_in_2739(w[2739]),.data_in_2740(w[2740]),.data_in_2741(w[2741]),.data_in_2742(w[2742]),.data_in_2743(w[2743]),.data_in_2744(w[2744]),.data_in_2745(w[2745]),.data_in_2746(w[2746]),.data_in_2747(w[2747]),.data_in_2748(w[2748]),.data_in_2749(w[2749]),.data_in_2750(w[2750]),.data_in_2751(w[2751]),.data_in_2752(w[2752]),.data_in_2753(w[2753]),.data_in_2754(w[2754]),.data_in_2755(w[2755]),.data_in_2756(w[2756]),.data_in_2757(w[2757]),.data_in_2758(w[2758]),.data_in_2759(w[2759]),.data_in_2760(w[2760]),.data_in_2761(w[2761]),.data_in_2762(w[2762]),.data_in_2763(w[2763]),.data_in_2764(w[2764]),.data_in_2765(w[2765]),.data_in_2766(w[2766]),.data_in_2767(w[2767]),.data_in_2768(w[2768]),.data_in_2769(w[2769]),.data_in_2770(w[2770]),.data_in_2771(w[2771]),.data_in_2772(w[2772]),.data_in_2773(w[2773]),.data_in_2774(w[2774]),.data_in_2775(w[2775]),.data_in_2776(w[2776]),.data_in_2777(w[2777]),.data_in_2778(w[2778]),.data_in_2779(w[2779]),.data_in_2780(w[2780]),.data_in_2781(w[2781]),.data_in_2782(w[2782]),.data_in_2783(w[2783]),.data_in_2784(w[2784]),.data_in_2785(w[2785]),.data_in_2786(w[2786]),.data_in_2787(w[2787]),.data_in_2788(w[2788]),.data_in_2789(w[2789]),.data_in_2790(w[2790]),.data_in_2791(w[2791]),.data_in_2792(w[2792]),.data_in_2793(w[2793]),.data_in_2794(w[2794]),.data_in_2795(w[2795]),.data_in_2796(w[2796]),.data_in_2797(w[2797]),.data_in_2798(w[2798]),.data_in_2799(w[2799]),.data_in_2800(w[2800]),.data_in_2801(w[2801]),.data_in_2802(w[2802]),.data_in_2803(w[2803]),.data_in_2804(w[2804]),.data_in_2805(w[2805]),.data_in_2806(w[2806]),.data_in_2807(w[2807]),.data_in_2808(w[2808]),.data_in_2809(w[2809]),.data_in_2810(w[2810]),.data_in_2811(w[2811]),.data_in_2812(w[2812]),.data_in_2813(w[2813]),.data_in_2814(w[2814]),.data_in_2815(w[2815]),.data_in_2816(w[2816]),.data_in_2817(w[2817]),.data_in_2818(w[2818]),.data_in_2819(w[2819]),.data_in_2820(w[2820]),.data_in_2821(w[2821]),.data_in_2822(w[2822]),.data_in_2823(w[2823]),.data_in_2824(w[2824]),.data_in_2825(w[2825]),.data_in_2826(w[2826]),.data_in_2827(w[2827]),.data_in_2828(w[2828]),.data_in_2829(w[2829]),.data_in_2830(w[2830]),.data_in_2831(w[2831]),.data_in_2832(w[2832]),.data_in_2833(w[2833]),.data_in_2834(w[2834]),.data_in_2835(w[2835]),.data_in_2836(w[2836]),.data_in_2837(w[2837]),.data_in_2838(w[2838]),.data_in_2839(w[2839]),.data_in_2840(w[2840]),.data_in_2841(w[2841]),.data_in_2842(w[2842]),.data_in_2843(w[2843]),.data_in_2844(w[2844]),.data_in_2845(w[2845]),.data_in_2846(w[2846]),.data_in_2847(w[2847]),.data_in_2848(w[2848]),.data_in_2849(w[2849]),.data_in_2850(w[2850]),.data_in_2851(w[2851]),.data_in_2852(w[2852]),.data_in_2853(w[2853]),.data_in_2854(w[2854]),.data_in_2855(w[2855]),.data_in_2856(w[2856]),.data_in_2857(w[2857]),.data_in_2858(w[2858]),.data_in_2859(w[2859]),.data_in_2860(w[2860]),.data_in_2861(w[2861]),.data_in_2862(w[2862]),.data_in_2863(w[2863]),.data_in_2864(w[2864]),.data_in_2865(w[2865]),.data_in_2866(w[2866]),.data_in_2867(w[2867]),.data_in_2868(w[2868]),.data_in_2869(w[2869]),.data_in_2870(w[2870]),.data_in_2871(w[2871]),.data_in_2872(w[2872]),.data_in_2873(w[2873]),.data_in_2874(w[2874]),.data_in_2875(w[2875]),.data_in_2876(w[2876]),.data_in_2877(w[2877]),.data_in_2878(w[2878]),.data_in_2879(w[2879]),.data_in_2880(w[2880]),.data_in_2881(w[2881]),.data_in_2882(w[2882]),.data_in_2883(w[2883]),.data_in_2884(w[2884]),.data_in_2885(w[2885]),.data_in_2886(w[2886]),.data_in_2887(w[2887]),.data_in_2888(w[2888]),.data_in_2889(w[2889]),.data_in_2890(w[2890]),.data_in_2891(w[2891]),.data_in_2892(w[2892]),.data_in_2893(w[2893]),.data_in_2894(w[2894]),.data_in_2895(w[2895]),.data_in_2896(w[2896]),.data_in_2897(w[2897]),.data_in_2898(w[2898]),.data_in_2899(w[2899]),.data_in_2900(w[2900]),.data_in_2901(w[2901]),.data_in_2902(w[2902]),.data_in_2903(w[2903]),.data_in_2904(w[2904]),.data_in_2905(w[2905]),.data_in_2906(w[2906]),.data_in_2907(w[2907]),.data_in_2908(w[2908]),.data_in_2909(w[2909]),.data_in_2910(w[2910]),.data_in_2911(w[2911]),.data_in_2912(w[2912]),.data_in_2913(w[2913]),.data_in_2914(w[2914]),.data_in_2915(w[2915]),.data_in_2916(w[2916]),.data_in_2917(w[2917]),.data_in_2918(w[2918]),.data_in_2919(w[2919]),.data_in_2920(w[2920]),.data_in_2921(w[2921]),.data_in_2922(w[2922]),.data_in_2923(w[2923]),.data_in_2924(w[2924]),.data_in_2925(w[2925]),.data_in_2926(w[2926]),.data_in_2927(w[2927]),.data_in_2928(w[2928]),.data_in_2929(w[2929]),.data_in_2930(w[2930]),.data_in_2931(w[2931]),.data_in_2932(w[2932]),.data_in_2933(w[2933]),.data_in_2934(w[2934]),.data_in_2935(w[2935]),.data_in_2936(w[2936]),.data_in_2937(w[2937]),.data_in_2938(w[2938]),.data_in_2939(w[2939]),.data_in_2940(w[2940]),.data_in_2941(w[2941]),.data_in_2942(w[2942]),.data_in_2943(w[2943]),.data_in_2944(w[2944]),.data_in_2945(w[2945]),.data_in_2946(w[2946]),.data_in_2947(w[2947]),.data_in_2948(w[2948]),.data_in_2949(w[2949]),.data_in_2950(w[2950]),.data_in_2951(w[2951]),.data_in_2952(w[2952]),.data_in_2953(w[2953]),.data_in_2954(w[2954]),.data_in_2955(w[2955]),.data_in_2956(w[2956]),.data_in_2957(w[2957]),.data_in_2958(w[2958]),.data_in_2959(w[2959]),.data_in_2960(w[2960]),.data_in_2961(w[2961]),.data_in_2962(w[2962]),.data_in_2963(w[2963]),.data_in_2964(w[2964]),.data_in_2965(w[2965]),.data_in_2966(w[2966]),.data_in_2967(w[2967]),.data_in_2968(w[2968]),.data_in_2969(w[2969]),.data_in_2970(w[2970]),.data_in_2971(w[2971]),.data_in_2972(w[2972]),.data_in_2973(w[2973]),.data_in_2974(w[2974]),.data_in_2975(w[2975]),.data_in_2976(w[2976]),.data_in_2977(w[2977]),.data_in_2978(w[2978]),.data_in_2979(w[2979]),.data_in_2980(w[2980]),.data_in_2981(w[2981]),.data_in_2982(w[2982]),.data_in_2983(w[2983]),.data_in_2984(w[2984]),.data_in_2985(w[2985]),.data_in_2986(w[2986]),.data_in_2987(w[2987]),.data_in_2988(w[2988]),.data_in_2989(w[2989]),.data_in_2990(w[2990]),.data_in_2991(w[2991]),.data_in_2992(w[2992]),.data_in_2993(w[2993]),.data_in_2994(w[2994]),.data_in_2995(w[2995]),.data_in_2996(w[2996]),.data_in_2997(w[2997]),.data_in_2998(w[2998]),.data_in_2999(w[2999]),.data_in_3000(w[3000]),.data_in_3001(w[3001]),.data_in_3002(w[3002]),.data_in_3003(w[3003]),.data_in_3004(w[3004]),.data_in_3005(w[3005]),.data_in_3006(w[3006]),.data_in_3007(w[3007]),.data_in_3008(w[3008]),.data_in_3009(w[3009]),.data_in_3010(w[3010]),.data_in_3011(w[3011]),.data_in_3012(w[3012]),.data_in_3013(w[3013]),.data_in_3014(w[3014]),.data_in_3015(w[3015]),.data_in_3016(w[3016]),.data_in_3017(w[3017]),.data_in_3018(w[3018]),.data_in_3019(w[3019]),.data_in_3020(w[3020]),.data_in_3021(w[3021]),.data_in_3022(w[3022]),.data_in_3023(w[3023]),.data_in_3024(w[3024]),.data_in_3025(w[3025]),.data_in_3026(w[3026]),.data_in_3027(w[3027]),.data_in_3028(w[3028]),.data_in_3029(w[3029]),.data_in_3030(w[3030]),.data_in_3031(w[3031]),.data_in_3032(w[3032]),.data_in_3033(w[3033]),.data_in_3034(w[3034]),.data_in_3035(w[3035]),.data_in_3036(w[3036]),.data_in_3037(w[3037]),.data_in_3038(w[3038]),.data_in_3039(w[3039]),.data_in_3040(w[3040]),.data_in_3041(w[3041]),.data_in_3042(w[3042]),.data_in_3043(w[3043]),.data_in_3044(w[3044]),.data_in_3045(w[3045]),.data_in_3046(w[3046]),.data_in_3047(w[3047]),.data_in_3048(w[3048]),.data_in_3049(w[3049]),.data_in_3050(w[3050]),.data_in_3051(w[3051]),.data_in_3052(w[3052]),.data_in_3053(w[3053]),.data_in_3054(w[3054]),.data_in_3055(w[3055]),.data_in_3056(w[3056]),.data_in_3057(w[3057]),.data_in_3058(w[3058]),.data_in_3059(w[3059]),.data_in_3060(w[3060]),.data_in_3061(w[3061]),.data_in_3062(w[3062]),.data_in_3063(w[3063]),.data_in_3064(w[3064]),.data_in_3065(w[3065]),.data_in_3066(w[3066]),.data_in_3067(w[3067]),.data_in_3068(w[3068]),.data_in_3069(w[3069]),.data_in_3070(w[3070]),.data_in_3071(w[3071]),.data_in_3072(w[3072]),.data_in_3073(w[3073]),.data_in_3074(w[3074]),.data_in_3075(w[3075]),.data_in_3076(w[3076]),.data_in_3077(w[3077]),.data_in_3078(w[3078]),.data_in_3079(w[3079]),.data_in_3080(w[3080]),.data_in_3081(w[3081]),.data_in_3082(w[3082]),.data_in_3083(w[3083]),.data_in_3084(w[3084]),.data_in_3085(w[3085]),.data_in_3086(w[3086]),.data_in_3087(w[3087]),.data_in_3088(w[3088]),.data_in_3089(w[3089]),.data_in_3090(w[3090]),.data_in_3091(w[3091]),.data_in_3092(w[3092]),.data_in_3093(w[3093]),.data_in_3094(w[3094]),.data_in_3095(w[3095]),.data_in_3096(w[3096]),.data_in_3097(w[3097]),.data_in_3098(w[3098]),.data_in_3099(w[3099]),.data_in_3100(w[3100]),.data_in_3101(w[3101]),.data_in_3102(w[3102]),.data_in_3103(w[3103]),.data_in_3104(w[3104]),.data_in_3105(w[3105]),.data_in_3106(w[3106]),.data_in_3107(w[3107]),.data_in_3108(w[3108]),.data_in_3109(w[3109]),.data_in_3110(w[3110]),.data_in_3111(w[3111]),.data_in_3112(w[3112]),.data_in_3113(w[3113]),.data_in_3114(w[3114]),.data_in_3115(w[3115]),.data_in_3116(w[3116]),.data_in_3117(w[3117]),.data_in_3118(w[3118]),.data_in_3119(w[3119]),.data_in_3120(w[3120]),.data_in_3121(w[3121]),.data_in_3122(w[3122]),.data_in_3123(w[3123]),.data_in_3124(w[3124]),.data_in_3125(w[3125]),.data_in_3126(w[3126]),.data_in_3127(w[3127]),.data_in_3128(w[3128]),.data_in_3129(w[3129]),.data_in_3130(w[3130]),.data_in_3131(w[3131]),.data_in_3132(w[3132]),.data_in_3133(w[3133]),.data_in_3134(w[3134]),.data_in_3135(w[3135]),.data_in_3136(w[3136]),.data_in_3137(w[3137]),.data_in_3138(w[3138]),.data_in_3139(w[3139]),.data_in_3140(w[3140]),.data_in_3141(w[3141]),.data_in_3142(w[3142]),.data_in_3143(w[3143]),.data_in_3144(w[3144]),.data_in_3145(w[3145]),.data_in_3146(w[3146]),.data_in_3147(w[3147]),.data_in_3148(w[3148]),.data_in_3149(w[3149]),.data_in_3150(w[3150]),.data_in_3151(w[3151]),.data_in_3152(w[3152]),.data_in_3153(w[3153]),.data_in_3154(w[3154]),.data_in_3155(w[3155]),.data_in_3156(w[3156]),.data_in_3157(w[3157]),.data_in_3158(w[3158]),.data_in_3159(w[3159]),.data_in_3160(w[3160]),.data_in_3161(w[3161]),.data_in_3162(w[3162]),.data_in_3163(w[3163]),.data_in_3164(w[3164]),.data_in_3165(w[3165]),.data_in_3166(w[3166]),.data_in_3167(w[3167]),.data_in_3168(w[3168]),.data_in_3169(w[3169]),.data_in_3170(w[3170]),.data_in_3171(w[3171]),.data_in_3172(w[3172]),.data_in_3173(w[3173]),.data_in_3174(w[3174]),.data_in_3175(w[3175]),.data_in_3176(w[3176]),.data_in_3177(w[3177]),.data_in_3178(w[3178]),.data_in_3179(w[3179]),.data_in_3180(w[3180]),.data_in_3181(w[3181]),.data_in_3182(w[3182]),.data_in_3183(w[3183]),.data_in_3184(w[3184]),.data_in_3185(w[3185]),.data_in_3186(w[3186]),.data_in_3187(w[3187]),.data_in_3188(w[3188]),.data_in_3189(w[3189]),.data_in_3190(w[3190]),.data_in_3191(w[3191]),.data_in_3192(w[3192]),.data_in_3193(w[3193]),.data_in_3194(w[3194]),.data_in_3195(w[3195]),.data_in_3196(w[3196]),.data_in_3197(w[3197]),.data_in_3198(w[3198]),.data_in_3199(w[3199]),.data_in_3200(w[3200]),.data_in_3201(w[3201]),.data_in_3202(w[3202]),.data_in_3203(w[3203]),.data_in_3204(w[3204]),.data_in_3205(w[3205]),.data_in_3206(w[3206]),.data_in_3207(w[3207]),.data_in_3208(w[3208]),.data_in_3209(w[3209]),.data_in_3210(w[3210]),.data_in_3211(w[3211]),.data_in_3212(w[3212]),.data_in_3213(w[3213]),.data_in_3214(w[3214]),.data_in_3215(w[3215]),.data_in_3216(w[3216]),.data_in_3217(w[3217]),.data_in_3218(w[3218]),.data_in_3219(w[3219]),.data_in_3220(w[3220]),.data_in_3221(w[3221]),.data_in_3222(w[3222]),.data_in_3223(w[3223]),.data_in_3224(w[3224]),.data_in_3225(w[3225]),.data_in_3226(w[3226]),.data_in_3227(w[3227]),.data_in_3228(w[3228]),.data_in_3229(w[3229]),.data_in_3230(w[3230]),.data_in_3231(w[3231]),.data_in_3232(w[3232]),.data_in_3233(w[3233]),.data_in_3234(w[3234]),.data_in_3235(w[3235]),.data_in_3236(w[3236]),.data_in_3237(w[3237]),.data_in_3238(w[3238]),.data_in_3239(w[3239]),.data_in_3240(w[3240]),.data_in_3241(w[3241]),.data_in_3242(w[3242]),.data_in_3243(w[3243]),.data_in_3244(w[3244]),.data_in_3245(w[3245]),.data_in_3246(w[3246]),.data_in_3247(w[3247]),.data_in_3248(w[3248]),.data_in_3249(w[3249]),.data_in_3250(w[3250]),.data_in_3251(w[3251]),.data_in_3252(w[3252]),.data_in_3253(w[3253]),.data_in_3254(w[3254]),.data_in_3255(w[3255]),.data_in_3256(w[3256]),.data_in_3257(w[3257]),.data_in_3258(w[3258]),.data_in_3259(w[3259]),.data_in_3260(w[3260]),.data_in_3261(w[3261]),.data_in_3262(w[3262]),.data_in_3263(w[3263]),.data_in_3264(w[3264]),.data_in_3265(w[3265]),.data_in_3266(w[3266]),.data_in_3267(w[3267]),.data_in_3268(w[3268]),.data_in_3269(w[3269]),.data_in_3270(w[3270]),.data_in_3271(w[3271]),.data_in_3272(w[3272]),.data_in_3273(w[3273]),.data_in_3274(w[3274]),.data_in_3275(w[3275]),.data_in_3276(w[3276]),.data_in_3277(w[3277]),.data_in_3278(w[3278]),.data_in_3279(w[3279]),.data_in_3280(w[3280]),.data_in_3281(w[3281]),.data_in_3282(w[3282]),.data_in_3283(w[3283]),.data_in_3284(w[3284]),.data_in_3285(w[3285]),.data_in_3286(w[3286]),.data_in_3287(w[3287]),.data_in_3288(w[3288]),.data_in_3289(w[3289]),.data_in_3290(w[3290]),.data_in_3291(w[3291]),.data_in_3292(w[3292]),.data_in_3293(w[3293]),.data_in_3294(w[3294]),.data_in_3295(w[3295]),.data_in_3296(w[3296]),.data_in_3297(w[3297]),.data_in_3298(w[3298]),.data_in_3299(w[3299]),.data_in_3300(w[3300]),.data_in_3301(w[3301]),.data_in_3302(w[3302]),.data_in_3303(w[3303]),.data_in_3304(w[3304]),.data_in_3305(w[3305]),.data_in_3306(w[3306]),.data_in_3307(w[3307]),.data_in_3308(w[3308]),.data_in_3309(w[3309]),.data_in_3310(w[3310]),.data_in_3311(w[3311]),.data_in_3312(w[3312]),.data_in_3313(w[3313]),.data_in_3314(w[3314]),.data_in_3315(w[3315]),.data_in_3316(w[3316]),.data_in_3317(w[3317]),.data_in_3318(w[3318]),.data_in_3319(w[3319]),.data_in_3320(w[3320]),.data_in_3321(w[3321]),.data_in_3322(w[3322]),.data_in_3323(w[3323]),.data_in_3324(w[3324]),.data_in_3325(w[3325]),.data_in_3326(w[3326]),.data_in_3327(w[3327]),.data_in_3328(w[3328]),.data_in_3329(w[3329]),.data_in_3330(w[3330]),.data_in_3331(w[3331]),.data_in_3332(w[3332]),.data_in_3333(w[3333]),.data_in_3334(w[3334]),.data_in_3335(w[3335]),.data_in_3336(w[3336]),.data_in_3337(w[3337]),.data_in_3338(w[3338]),.data_in_3339(w[3339]),.data_in_3340(w[3340]),.data_in_3341(w[3341]),.data_in_3342(w[3342]),.data_in_3343(w[3343]),.data_in_3344(w[3344]),.data_in_3345(w[3345]),.data_in_3346(w[3346]),.data_in_3347(w[3347]),.data_in_3348(w[3348]),.data_in_3349(w[3349]),.data_in_3350(w[3350]),.data_in_3351(w[3351]),.data_in_3352(w[3352]),.data_in_3353(w[3353]),.data_in_3354(w[3354]),.data_in_3355(w[3355]),.data_in_3356(w[3356]),.data_in_3357(w[3357]),.data_in_3358(w[3358]),.data_in_3359(w[3359]),.data_in_3360(w[3360]),.data_in_3361(w[3361]),.data_in_3362(w[3362]),.data_in_3363(w[3363]),.data_in_3364(w[3364]),.data_in_3365(w[3365]),.data_in_3366(w[3366]),.data_in_3367(w[3367]),.data_in_3368(w[3368]),.data_in_3369(w[3369]),.data_in_3370(w[3370]),.data_in_3371(w[3371]),.data_in_3372(w[3372]),.data_in_3373(w[3373]),.data_in_3374(w[3374]),.data_in_3375(w[3375]),.data_in_3376(w[3376]),.data_in_3377(w[3377]),.data_in_3378(w[3378]),.data_in_3379(w[3379]),.data_in_3380(w[3380]),.data_in_3381(w[3381]),.data_in_3382(w[3382]),.data_in_3383(w[3383]),.data_in_3384(w[3384]),.data_in_3385(w[3385]),.data_in_3386(w[3386]),.data_in_3387(w[3387]),.data_in_3388(w[3388]),.data_in_3389(w[3389]),.data_in_3390(w[3390]),.data_in_3391(w[3391]),.data_in_3392(w[3392]),.data_in_3393(w[3393]),.data_in_3394(w[3394]),.data_in_3395(w[3395]),.data_in_3396(w[3396]),.data_in_3397(w[3397]),.data_in_3398(w[3398]),.data_in_3399(w[3399]),.data_in_3400(w[3400]),.data_in_3401(w[3401]),.data_in_3402(w[3402]),.data_in_3403(w[3403]),.data_in_3404(w[3404]),.data_in_3405(w[3405]),.data_in_3406(w[3406]),.data_in_3407(w[3407]),.data_in_3408(w[3408]),.data_in_3409(w[3409]),.data_in_3410(w[3410]),.data_in_3411(w[3411]),.data_in_3412(w[3412]),.data_in_3413(w[3413]),.data_in_3414(w[3414]),.data_in_3415(w[3415]),.data_in_3416(w[3416]),.data_in_3417(w[3417]),.data_in_3418(w[3418]),.data_in_3419(w[3419]),.data_in_3420(w[3420]),.data_in_3421(w[3421]),.data_in_3422(w[3422]),.data_in_3423(w[3423]),.data_in_3424(w[3424]),.data_in_3425(w[3425]),.data_in_3426(w[3426]),.data_in_3427(w[3427]),.data_in_3428(w[3428]),.data_in_3429(w[3429]),.data_in_3430(w[3430]),.data_in_3431(w[3431]),.data_in_3432(w[3432]),.data_in_3433(w[3433]),.data_in_3434(w[3434]),.data_in_3435(w[3435]),.data_in_3436(w[3436]),.data_in_3437(w[3437]),.data_in_3438(w[3438]),.data_in_3439(w[3439]),.data_in_3440(w[3440]),.data_in_3441(w[3441]),.data_in_3442(w[3442]),.data_in_3443(w[3443]),.data_in_3444(w[3444]),.data_in_3445(w[3445]),.data_in_3446(w[3446]),.data_in_3447(w[3447]),.data_in_3448(w[3448]),.data_in_3449(w[3449]),.data_in_3450(w[3450]),.data_in_3451(w[3451]),.data_in_3452(w[3452]),.data_in_3453(w[3453]),.data_in_3454(w[3454]),.data_in_3455(w[3455]),.data_in_3456(w[3456]),.data_in_3457(w[3457]),.data_in_3458(w[3458]),.data_in_3459(w[3459]),.data_in_3460(w[3460]),.data_in_3461(w[3461]),.data_in_3462(w[3462]),.data_in_3463(w[3463]),.data_in_3464(w[3464]),.data_in_3465(w[3465]),.data_in_3466(w[3466]),.data_in_3467(w[3467]),.data_in_3468(w[3468]),.data_in_3469(w[3469]),.data_in_3470(w[3470]),.data_in_3471(w[3471]),.data_in_3472(w[3472]),.data_in_3473(w[3473]),.data_in_3474(w[3474]),.data_in_3475(w[3475]),.data_in_3476(w[3476]),.data_in_3477(w[3477]),.data_in_3478(w[3478]),.data_in_3479(w[3479]),.data_in_3480(w[3480]),.data_in_3481(w[3481]),.data_in_3482(w[3482]),.data_in_3483(w[3483]),.data_in_3484(w[3484]),.data_in_3485(w[3485]),.data_in_3486(w[3486]),.data_in_3487(w[3487]),.data_in_3488(w[3488]),.data_in_3489(w[3489]),.data_in_3490(w[3490]),.data_in_3491(w[3491]),.data_in_3492(w[3492]),.data_in_3493(w[3493]),.data_in_3494(w[3494]),.data_in_3495(w[3495]),.data_in_3496(w[3496]),.data_in_3497(w[3497]),.data_in_3498(w[3498]),.data_in_3499(w[3499]),.data_in_3500(w[3500]),.data_in_3501(w[3501]),.data_in_3502(w[3502]),.data_in_3503(w[3503]),.data_in_3504(w[3504]),.data_in_3505(w[3505]),.data_in_3506(w[3506]),.data_in_3507(w[3507]),.data_in_3508(w[3508]),.data_in_3509(w[3509]),.data_in_3510(w[3510]),.data_in_3511(w[3511]),.data_in_3512(w[3512]),.data_in_3513(w[3513]),.data_in_3514(w[3514]),.data_in_3515(w[3515]),.data_in_3516(w[3516]),.data_in_3517(w[3517]),.data_in_3518(w[3518]),.data_in_3519(w[3519]),.data_in_3520(w[3520]),.data_in_3521(w[3521]),.data_in_3522(w[3522]),.data_in_3523(w[3523]),.data_in_3524(w[3524]),.data_in_3525(w[3525]),.data_in_3526(w[3526]),.data_in_3527(w[3527]),.data_in_3528(w[3528]),.data_in_3529(w[3529]),.data_in_3530(w[3530]),.data_in_3531(w[3531]),.data_in_3532(w[3532]),.data_in_3533(w[3533]),.data_in_3534(w[3534]),.data_in_3535(w[3535]),.data_in_3536(w[3536]),.data_in_3537(w[3537]),.data_in_3538(w[3538]),.data_in_3539(w[3539]),.data_in_3540(w[3540]),.data_in_3541(w[3541]),.data_in_3542(w[3542]),.data_in_3543(w[3543]),.data_in_3544(w[3544]),.data_in_3545(w[3545]),.data_in_3546(w[3546]),.data_in_3547(w[3547]),.data_in_3548(w[3548]),.data_in_3549(w[3549]),.data_in_3550(w[3550]),.data_in_3551(w[3551]),.data_in_3552(w[3552]),.data_in_3553(w[3553]),.data_in_3554(w[3554]),.data_in_3555(w[3555]),.data_in_3556(w[3556]),.data_in_3557(w[3557]),.data_in_3558(w[3558]),.data_in_3559(w[3559]),.data_in_3560(w[3560]),.data_in_3561(w[3561]),.data_in_3562(w[3562]),.data_in_3563(w[3563]),.data_in_3564(w[3564]),.data_in_3565(w[3565]),.data_in_3566(w[3566]),.data_in_3567(w[3567]),.data_in_3568(w[3568]),.data_in_3569(w[3569]),.data_in_3570(w[3570]),.data_in_3571(w[3571]),.data_in_3572(w[3572]),.data_in_3573(w[3573]),.data_in_3574(w[3574]),.data_in_3575(w[3575]),.data_in_3576(w[3576]),.data_in_3577(w[3577]),.data_in_3578(w[3578]),.data_in_3579(w[3579]),.data_in_3580(w[3580]),.data_in_3581(w[3581]),.data_in_3582(w[3582]),.data_in_3583(w[3583]),.data_in_3584(w[3584]),.data_in_3585(w[3585]),.data_in_3586(w[3586]),.data_in_3587(w[3587]),.data_in_3588(w[3588]),.data_in_3589(w[3589]),.data_in_3590(w[3590]),.data_in_3591(w[3591]),.data_in_3592(w[3592]),.data_in_3593(w[3593]),.data_in_3594(w[3594]),.data_in_3595(w[3595]),.data_in_3596(w[3596]),.data_in_3597(w[3597]),.data_in_3598(w[3598]),.data_in_3599(w[3599]),.data_in_3600(w[3600]),.data_in_3601(w[3601]),.data_in_3602(w[3602]),.data_in_3603(w[3603]),.data_in_3604(w[3604]),.data_in_3605(w[3605]),.data_in_3606(w[3606]),.data_in_3607(w[3607]),.data_in_3608(w[3608]),.data_in_3609(w[3609]),.data_in_3610(w[3610]),.data_in_3611(w[3611]),.data_in_3612(w[3612]),.data_in_3613(w[3613]),.data_in_3614(w[3614]),.data_in_3615(w[3615]),.data_in_3616(w[3616]),.data_in_3617(w[3617]),.data_in_3618(w[3618]),.data_in_3619(w[3619]),.data_in_3620(w[3620]),.data_in_3621(w[3621]),.data_in_3622(w[3622]),.data_in_3623(w[3623]),.data_in_3624(w[3624]),.data_in_3625(w[3625]),.data_in_3626(w[3626]),.data_in_3627(w[3627]),.data_in_3628(w[3628]),.data_in_3629(w[3629]),.data_in_3630(w[3630]),.data_in_3631(w[3631]),.data_in_3632(w[3632]),.data_in_3633(w[3633]),.data_in_3634(w[3634]),.data_in_3635(w[3635]),.data_in_3636(w[3636]),.data_in_3637(w[3637]),.data_in_3638(w[3638]),.data_in_3639(w[3639]),.data_in_3640(w[3640]),.data_in_3641(w[3641]),.data_in_3642(w[3642]),.data_in_3643(w[3643]),.data_in_3644(w[3644]),.data_in_3645(w[3645]),.data_in_3646(w[3646]),.data_in_3647(w[3647]),.data_in_3648(w[3648]),.data_in_3649(w[3649]),.data_in_3650(w[3650]),.data_in_3651(w[3651]),.data_in_3652(w[3652]),.data_in_3653(w[3653]),.data_in_3654(w[3654]),.data_in_3655(w[3655]),.data_in_3656(w[3656]),.data_in_3657(w[3657]),.data_in_3658(w[3658]),.data_in_3659(w[3659]),.data_in_3660(w[3660]),.data_in_3661(w[3661]),.data_in_3662(w[3662]),.data_in_3663(w[3663]),.data_in_3664(w[3664]),.data_in_3665(w[3665]),.data_in_3666(w[3666]),.data_in_3667(w[3667]),.data_in_3668(w[3668]),.data_in_3669(w[3669]),.data_in_3670(w[3670]),.data_in_3671(w[3671]),.data_in_3672(w[3672]),.data_in_3673(w[3673]),.data_in_3674(w[3674]),.data_in_3675(w[3675]),.data_in_3676(w[3676]),.data_in_3677(w[3677]),.data_in_3678(w[3678]),.data_in_3679(w[3679]),.data_in_3680(w[3680]),.data_in_3681(w[3681]),.data_in_3682(w[3682]),.data_in_3683(w[3683]),.data_in_3684(w[3684]),.data_in_3685(w[3685]),.data_in_3686(w[3686]),.data_in_3687(w[3687]),.data_in_3688(w[3688]),.data_in_3689(w[3689]),.data_in_3690(w[3690]),.data_in_3691(w[3691]),.data_in_3692(w[3692]),.data_in_3693(w[3693]),.data_in_3694(w[3694]),.data_in_3695(w[3695]),.data_in_3696(w[3696]),.data_in_3697(w[3697]),.data_in_3698(w[3698]),.data_in_3699(w[3699]),.data_in_3700(w[3700]),.data_in_3701(w[3701]),.data_in_3702(w[3702]),.data_in_3703(w[3703]),.data_in_3704(w[3704]),.data_in_3705(w[3705]),.data_in_3706(w[3706]),.data_in_3707(w[3707]),.data_in_3708(w[3708]),.data_in_3709(w[3709]),.data_in_3710(w[3710]),.data_in_3711(w[3711]),.data_in_3712(w[3712]),.data_in_3713(w[3713]),.data_in_3714(w[3714]),.data_in_3715(w[3715]),.data_in_3716(w[3716]),.data_in_3717(w[3717]),.data_in_3718(w[3718]),.data_in_3719(w[3719]),.data_in_3720(w[3720]),.data_in_3721(w[3721]),.data_in_3722(w[3722]),.data_in_3723(w[3723]),.data_in_3724(w[3724]),.data_in_3725(w[3725]),.data_in_3726(w[3726]),.data_in_3727(w[3727]),.data_in_3728(w[3728]),.data_in_3729(w[3729]),.data_in_3730(w[3730]),.data_in_3731(w[3731]),.data_in_3732(w[3732]),.data_in_3733(w[3733]),.data_in_3734(w[3734]),.data_in_3735(w[3735]),.data_in_3736(w[3736]),.data_in_3737(w[3737]),.data_in_3738(w[3738]),.data_in_3739(w[3739]),.data_in_3740(w[3740]),.data_in_3741(w[3741]),.data_in_3742(w[3742]),.data_in_3743(w[3743]),.data_in_3744(w[3744]),.data_in_3745(w[3745]),.data_in_3746(w[3746]),.data_in_3747(w[3747]),.data_in_3748(w[3748]),.data_in_3749(w[3749]),.data_in_3750(w[3750]),.data_in_3751(w[3751]),.data_in_3752(w[3752]),.data_in_3753(w[3753]),.data_in_3754(w[3754]),.data_in_3755(w[3755]),.data_in_3756(w[3756]),.data_in_3757(w[3757]),.data_in_3758(w[3758]),.data_in_3759(w[3759]),.data_in_3760(w[3760]),.data_in_3761(w[3761]),.data_in_3762(w[3762]),.data_in_3763(w[3763]),.data_in_3764(w[3764]),.data_in_3765(w[3765]),.data_in_3766(w[3766]),.data_in_3767(w[3767]),.data_in_3768(w[3768]),.data_in_3769(w[3769]),.data_in_3770(w[3770]),.data_in_3771(w[3771]),.data_in_3772(w[3772]),.data_in_3773(w[3773]),.data_in_3774(w[3774]),.data_in_3775(w[3775]),.data_in_3776(w[3776]),.data_in_3777(w[3777]),.data_in_3778(w[3778]),.data_in_3779(w[3779]),.data_in_3780(w[3780]),.data_in_3781(w[3781]),.data_in_3782(w[3782]),.data_in_3783(w[3783]),.data_in_3784(w[3784]),.data_in_3785(w[3785]),.data_in_3786(w[3786]),.data_in_3787(w[3787]),.data_in_3788(w[3788]),.data_in_3789(w[3789]),.data_in_3790(w[3790]),.data_in_3791(w[3791]),.data_in_3792(w[3792]),.data_in_3793(w[3793]),.data_in_3794(w[3794]),.data_in_3795(w[3795]),.data_in_3796(w[3796]),.data_in_3797(w[3797]),.data_in_3798(w[3798]),.data_in_3799(w[3799]),.data_in_3800(w[3800]),.data_in_3801(w[3801]),.data_in_3802(w[3802]),.data_in_3803(w[3803]),.data_in_3804(w[3804]),.data_in_3805(w[3805]),.data_in_3806(w[3806]),.data_in_3807(w[3807]),.data_in_3808(w[3808]),.data_in_3809(w[3809]),.data_in_3810(w[3810]),.data_in_3811(w[3811]),.data_in_3812(w[3812]),.data_in_3813(w[3813]),.data_in_3814(w[3814]),.data_in_3815(w[3815]),.data_in_3816(w[3816]),.data_in_3817(w[3817]),.data_in_3818(w[3818]),.data_in_3819(w[3819]),.data_in_3820(w[3820]),.data_in_3821(w[3821]),.data_in_3822(w[3822]),.data_in_3823(w[3823]),.data_in_3824(w[3824]),.data_in_3825(w[3825]),.data_in_3826(w[3826]),.data_in_3827(w[3827]),.data_in_3828(w[3828]),.data_in_3829(w[3829]),.data_in_3830(w[3830]),.data_in_3831(w[3831]),.data_in_3832(w[3832]),.data_in_3833(w[3833]),.data_in_3834(w[3834]),.data_in_3835(w[3835]),.data_in_3836(w[3836]),.data_in_3837(w[3837]),.data_in_3838(w[3838]),.data_in_3839(w[3839]),.data_in_3840(w[3840]),.data_in_3841(w[3841]),.data_in_3842(w[3842]),.data_in_3843(w[3843]),.data_in_3844(w[3844]),.data_in_3845(w[3845]),.data_in_3846(w[3846]),.data_in_3847(w[3847]),.data_in_3848(w[3848]),.data_in_3849(w[3849]),.data_in_3850(w[3850]),.data_in_3851(w[3851]),.data_in_3852(w[3852]),.data_in_3853(w[3853]),.data_in_3854(w[3854]),.data_in_3855(w[3855]),.data_in_3856(w[3856]),.data_in_3857(w[3857]),.data_in_3858(w[3858]),.data_in_3859(w[3859]),.data_in_3860(w[3860]),.data_in_3861(w[3861]),.data_in_3862(w[3862]),.data_in_3863(w[3863]),.data_in_3864(w[3864]),.data_in_3865(w[3865]),.data_in_3866(w[3866]),.data_in_3867(w[3867]),.data_in_3868(w[3868]),.data_in_3869(w[3869]),.data_in_3870(w[3870]),.data_in_3871(w[3871]),.data_in_3872(w[3872]),.data_in_3873(w[3873]),.data_in_3874(w[3874]),.data_in_3875(w[3875]),.data_in_3876(w[3876]),.data_in_3877(w[3877]),.data_in_3878(w[3878]),.data_in_3879(w[3879]),.data_in_3880(w[3880]),.data_in_3881(w[3881]),.data_in_3882(w[3882]),.data_in_3883(w[3883]),.data_in_3884(w[3884]),.data_in_3885(w[3885]),.data_in_3886(w[3886]),.data_in_3887(w[3887]),.data_in_3888(w[3888]),.data_in_3889(w[3889]),.data_in_3890(w[3890]),.data_in_3891(w[3891]),.data_in_3892(w[3892]),.data_in_3893(w[3893]),.data_in_3894(w[3894]),.data_in_3895(w[3895]),.data_in_3896(w[3896]),.data_in_3897(w[3897]),.data_in_3898(w[3898]),.data_in_3899(w[3899]),.data_in_3900(w[3900]),.data_in_3901(w[3901]),.data_in_3902(w[3902]),.data_in_3903(w[3903]),.data_in_3904(w[3904]),.data_in_3905(w[3905]),.data_in_3906(w[3906]),.data_in_3907(w[3907]),.data_in_3908(w[3908]),.data_in_3909(w[3909]),.data_in_3910(w[3910]),.data_in_3911(w[3911]),.data_in_3912(w[3912]),.data_in_3913(w[3913]),.data_in_3914(w[3914]),.data_in_3915(w[3915]),.data_in_3916(w[3916]),.data_in_3917(w[3917]),.data_in_3918(w[3918]),.data_in_3919(w[3919]),.data_in_3920(w[3920]),.data_in_3921(w[3921]),.data_in_3922(w[3922]),.data_in_3923(w[3923]),.data_in_3924(w[3924]),.data_in_3925(w[3925]),.data_in_3926(w[3926]),.data_in_3927(w[3927]),.data_in_3928(w[3928]),.data_in_3929(w[3929]),.data_in_3930(w[3930]),.data_in_3931(w[3931]),.data_in_3932(w[3932]),.data_in_3933(w[3933]),.data_in_3934(w[3934]),.data_in_3935(w[3935]),.data_in_3936(w[3936]),.data_in_3937(w[3937]),.data_in_3938(w[3938]),.data_in_3939(w[3939]),.data_in_3940(w[3940]),.data_in_3941(w[3941]),.data_in_3942(w[3942]),.data_in_3943(w[3943]),.data_in_3944(w[3944]),.data_in_3945(w[3945]),.data_in_3946(w[3946]),.data_in_3947(w[3947]),.data_in_3948(w[3948]),.data_in_3949(w[3949]),.data_in_3950(w[3950]),.data_in_3951(w[3951]),.data_in_3952(w[3952]),.data_in_3953(w[3953]),.data_in_3954(w[3954]),.data_in_3955(w[3955]),.data_in_3956(w[3956]),.data_in_3957(w[3957]),.data_in_3958(w[3958]),.data_in_3959(w[3959]),.data_in_3960(w[3960]),.data_in_3961(w[3961]),.data_in_3962(w[3962]),.data_in_3963(w[3963]),.data_in_3964(w[3964]),.data_in_3965(w[3965]),.data_in_3966(w[3966]),.data_in_3967(w[3967]),.data_in_3968(w[3968]),.data_in_3969(w[3969]),.data_in_3970(w[3970]),.data_in_3971(w[3971]),.data_in_3972(w[3972]),.data_in_3973(w[3973]),.data_in_3974(w[3974]),.data_in_3975(w[3975]),.data_in_3976(w[3976]),.data_in_3977(w[3977]),.data_in_3978(w[3978]),.data_in_3979(w[3979]),.data_in_3980(w[3980]),.data_in_3981(w[3981]),.data_in_3982(w[3982]),.data_in_3983(w[3983]),.data_in_3984(w[3984]),.data_in_3985(w[3985]),.data_in_3986(w[3986]),.data_in_3987(w[3987]),.data_in_3988(w[3988]),.data_in_3989(w[3989]),.data_in_3990(w[3990]),.data_in_3991(w[3991]),.data_in_3992(w[3992]),.data_in_3993(w[3993]),.data_in_3994(w[3994]),.data_in_3995(w[3995]),.data_in_3996(w[3996]),.data_in_3997(w[3997]),.data_in_3998(w[3998]),.data_in_3999(w[3999]),.data_in_4000(w[4000]),.data_in_4001(w[4001]),.data_in_4002(w[4002]),.data_in_4003(w[4003]),.data_in_4004(w[4004]),.data_in_4005(w[4005]),.data_in_4006(w[4006]),.data_in_4007(w[4007]),.data_in_4008(w[4008]),.data_in_4009(w[4009]),.data_in_4010(w[4010]),.data_in_4011(w[4011]),.data_in_4012(w[4012]),.data_in_4013(w[4013]),.data_in_4014(w[4014]),.data_in_4015(w[4015]),.data_in_4016(w[4016]),.data_in_4017(w[4017]),.data_in_4018(w[4018]),.data_in_4019(w[4019]),.data_in_4020(w[4020]),.data_in_4021(w[4021]),.data_in_4022(w[4022]),.data_in_4023(w[4023]),.data_in_4024(w[4024]),.data_in_4025(w[4025]),.data_in_4026(w[4026]),.data_in_4027(w[4027]),.data_in_4028(w[4028]),.data_in_4029(w[4029]),.data_in_4030(w[4030]),.data_in_4031(w[4031]),.data_in_4032(w[4032]),.data_in_4033(w[4033]),.data_in_4034(w[4034]),.data_in_4035(w[4035]),.data_in_4036(w[4036]),.data_in_4037(w[4037]),.data_in_4038(w[4038]),.data_in_4039(w[4039]),.data_in_4040(w[4040]),.data_in_4041(w[4041]),.data_in_4042(w[4042]),.data_in_4043(w[4043]),.data_in_4044(w[4044]),.data_in_4045(w[4045]),.data_in_4046(w[4046]),.data_in_4047(w[4047]),.data_in_4048(w[4048]),.data_in_4049(w[4049]),.data_in_4050(w[4050]),.data_in_4051(w[4051]),.data_in_4052(w[4052]),.data_in_4053(w[4053]),
                .data_in_4054(w[4054]),.data_in_4055(w[4055]),.data_in_4056(w[4056]),.data_in_4057(w[4057]),
                .data_in_4058(w[4058]),.data_in_4059(w[4059]),.data_in_4060(w[4060]),.data_in_4061(w[4061]),.data_in_4062(w[4062]),.data_in_4063(w[4063]),.data_in_4064(w[4064]),.data_in_4065(w[4065]),.data_in_4066(w[4066]),
                .data_in_4067(w[4067]),.data_in_4068(w[4068]),.data_in_4069(w[4069]),.data_in_4070(w[4070]),.data_in_4071(w[4071]),.data_in_4072(w[4072]),.data_in_4073(w[4073]),.data_in_4074(w[4074]),.data_in_4075(w[4075]),
                .data_in_4076(w[4076]),.data_in_4077(w[4077]),.data_in_4078(w[4078]),.data_in_4079(w[4079]),.data_in_4080(w[4080]),.data_in_4081(w[4081]),.data_in_4082(w[4082]),.data_in_4083(w[4083]),.data_in_4084(w[4084]),
                .data_in_4085(w[4085]),.data_in_4086(w[4086]),.data_in_4087(w[4087]),.data_in_4088(w[4088]),.data_in_4089(w[4089]),.data_in_4090(w[4090]),.data_in_4091(w[4091]),.data_in_4092(w[4092]),.data_in_4093(w[4093]),
                .data_in_4094(w[4094]),.data_in_4095(w[4095]),
                 
                .data_out_0(wa[0]),.data_out_1(wa[1]),.data_out_2(wa[2]),.data_out_3(wa[3]),.data_out_4(wa[4]),.data_out_5(wa[5]),.data_out_6(wa[6]),.data_out_7(wa[7]),.data_out_8(wa[8]),.data_out_9(wa[9]),.data_out_10(wa[10]),
                .data_out_11(wa[11]),.data_out_12(wa[12]),.data_out_13(wa[13]),.data_out_14(wa[14]),.data_out_15(wa[15]),.data_out_16(wa[16]),.data_out_17(wa[17]),.data_out_18(wa[18]),.data_out_19(wa[19]),.data_out_20(wa[20]),
                .data_out_21(wa[21]),.data_out_22(wa[22]),.data_out_23(wa[23]),.data_out_24(wa[24]),.data_out_25(wa[25]),.data_out_26(wa[26]),.data_out_27(wa[27]),.data_out_28(wa[28]),.data_out_29(wa[29]),.data_out_30(wa[30]),
                .data_out_31(wa[31]),.data_out_32(wa[32]),.data_out_33(wa[33]),.data_out_34(wa[34]),.data_out_35(wa[35]),.data_out_36(wa[36]),.data_out_37(wa[37]),.data_out_38(wa[38]),.data_out_39(wa[39]),.data_out_40(wa[40]),
                .data_out_41(wa[41]),.data_out_42(wa[42]),.data_out_43(wa[43]),.data_out_44(wa[44]),.data_out_45(wa[45]),.data_out_46(wa[46]),.data_out_47(wa[47]),.data_out_48(wa[48]),.data_out_49(wa[49]),.data_out_50(wa[50]),
                .data_out_51(wa[51]),.data_out_52(wa[52]),.data_out_53(wa[53]),.data_out_54(wa[54]),.data_out_55(wa[55]),.data_out_56(wa[56]),.data_out_57(wa[57]),.data_out_58(wa[58]),.data_out_59(wa[59]),.data_out_60(wa[60]),
                .data_out_61(wa[61]),.data_out_62(wa[62]),.data_out_63(wa[63]),.data_out_64(wa[64]),.data_out_65(wa[65]),.data_out_66(wa[66]),.data_out_67(wa[67]),.data_out_68(wa[68]),.data_out_69(wa[69]),.data_out_70(wa[70]),
                .data_out_71(wa[71]),.data_out_72(wa[72]),.data_out_73(wa[73]),.data_out_74(wa[74]),.data_out_75(wa[75]),.data_out_76(wa[76]),.data_out_77(wa[77]),.data_out_78(wa[78]),.data_out_79(wa[79]),.data_out_80(wa[80]),
                .data_out_81(wa[81]),.data_out_82(wa[82]),.data_out_83(wa[83]),.data_out_84(wa[84]),.data_out_85(wa[85]),.data_out_86(wa[86]),.data_out_87(wa[87]),.data_out_88(wa[88]),.data_out_89(wa[89]),.data_out_90(wa[90]),
                .data_out_91(wa[91]),.data_out_92(wa[92]),.data_out_93(wa[93]),.data_out_94(wa[94]),.data_out_95(wa[95]),.data_out_96(wa[96]),.data_out_97(wa[97]),.data_out_98(wa[98]),.data_out_99(wa[99]),.data_out_100(wa[100]),
                .data_out_101(wa[101]),.data_out_102(wa[102]),.data_out_103(wa[103]),.data_out_104(wa[104]),.data_out_105(wa[105]),.data_out_106(wa[106]),.data_out_107(wa[107]),.data_out_108(wa[108]),.data_out_109(wa[109]),
                .data_out_110(wa[110]),.data_out_111(wa[111]),.data_out_112(wa[112]),.data_out_113(wa[113]),.data_out_114(wa[114]),.data_out_115(wa[115]),.data_out_116(wa[116]),.data_out_117(wa[117]),.data_out_118(wa[118]),
                .data_out_119(wa[119]),.data_out_120(wa[120]),.data_out_121(wa[121]),.data_out_122(wa[122]),.data_out_123(wa[123]),.data_out_124(wa[124]),.data_out_125(wa[125]),.data_out_126(wa[126]),.data_out_127(wa[127]),
                .data_out_128(wa[128]),.data_out_129(wa[129]),.data_out_130(wa[130]),.data_out_131(wa[131]),.data_out_132(wa[132]),.data_out_133(wa[133]),.data_out_134(wa[134]),.data_out_135(wa[135]),.data_out_136(wa[136]),
                .data_out_137(wa[137]),.data_out_138(wa[138]),.data_out_139(wa[139]),.data_out_140(wa[140]),.data_out_141(wa[141]),.data_out_142(wa[142]),.data_out_143(wa[143]),.data_out_144(wa[144]),.data_out_145(wa[145]),
                .data_out_146(wa[146]),.data_out_147(wa[147]),.data_out_148(wa[148]),.data_out_149(wa[149]),.data_out_150(wa[150]),.data_out_151(wa[151]),.data_out_152(wa[152]),.data_out_153(wa[153]),.data_out_154(wa[154]),
                .data_out_155(wa[155]),.data_out_156(wa[156]),.data_out_157(wa[157]),.data_out_158(wa[158]),.data_out_159(wa[159]),.data_out_160(wa[160]),.data_out_161(wa[161]),.data_out_162(wa[162]),.data_out_163(wa[163]),
                .data_out_164(wa[164]),.data_out_165(wa[165]),.data_out_166(wa[166]),.data_out_167(wa[167]),.data_out_168(wa[168]),.data_out_169(wa[169]),.data_out_170(wa[170]),.data_out_171(wa[171]),.data_out_172(wa[172]),
                .data_out_173(wa[173]),.data_out_174(wa[174]),.data_out_175(wa[175]),.data_out_176(wa[176]),.data_out_177(wa[177]),.data_out_178(wa[178]),.data_out_179(wa[179]),.data_out_180(wa[180]),.data_out_181(wa[181]),
                .data_out_182(wa[182]),.data_out_183(wa[183]),.data_out_184(wa[184]),.data_out_185(wa[185]),.data_out_186(wa[186]),.data_out_187(wa[187]),.data_out_188(wa[188]),.data_out_189(wa[189]),.data_out_190(wa[190]),
                .data_out_191(wa[191]),.data_out_192(wa[192]),.data_out_193(wa[193]),.data_out_194(wa[194]),.data_out_195(wa[195]),.data_out_196(wa[196]),.data_out_197(wa[197]),.data_out_198(wa[198]),.data_out_199(wa[199]),
                .data_out_200(wa[200]),.data_out_201(wa[201]),.data_out_202(wa[202]),.data_out_203(wa[203]),.data_out_204(wa[204]),.data_out_205(wa[205]),.data_out_206(wa[206]),.data_out_207(wa[207]),.data_out_208(wa[208]),
                .data_out_209(wa[209]),.data_out_210(wa[210]),.data_out_211(wa[211]),.data_out_212(wa[212]),.data_out_213(wa[213]),.data_out_214(wa[214]),.data_out_215(wa[215]),.data_out_216(wa[216]),.data_out_217(wa[217]),
                .data_out_218(wa[218]),.data_out_219(wa[219]),.data_out_220(wa[220]),.data_out_221(wa[221]),.data_out_222(wa[222]),.data_out_223(wa[223]),.data_out_224(wa[224]),.data_out_225(wa[225]),.data_out_226(wa[226]),
                .data_out_227(wa[227]),.data_out_228(wa[228]),.data_out_229(wa[229]),.data_out_230(wa[230]),.data_out_231(wa[231]),.data_out_232(wa[232]),.data_out_233(wa[233]),.data_out_234(wa[234]),.data_out_235(wa[235]),
                .data_out_236(wa[236]),.data_out_237(wa[237]),.data_out_238(wa[238]),.data_out_239(wa[239]),.data_out_240(wa[240]),.data_out_241(wa[241]),.data_out_242(wa[242]),.data_out_243(wa[243]),.data_out_244(wa[244]),
                .data_out_245(wa[245]),.data_out_246(wa[246]),.data_out_247(wa[247]),.data_out_248(wa[248]),.data_out_249(wa[249]),.data_out_250(wa[250]),.data_out_251(wa[251]),.data_out_252(wa[252]),.data_out_253(wa[253]),
                .data_out_254(wa[254]),.data_out_255(wa[255]),.data_out_256(wa[256]),.data_out_257(wa[257]),.data_out_258(wa[258]),.data_out_259(wa[259]),.data_out_260(wa[260]),.data_out_261(wa[261]),.data_out_262(wa[262]),
                .data_out_263(wa[263]),.data_out_264(wa[264]),.data_out_265(wa[265]),.data_out_266(wa[266]),.data_out_267(wa[267]),.data_out_268(wa[268]),.data_out_269(wa[269]),.data_out_270(wa[270]),.data_out_271(wa[271]),
                .data_out_272(wa[272]),.data_out_273(wa[273]),.data_out_274(wa[274]),.data_out_275(wa[275]),.data_out_276(wa[276]),.data_out_277(wa[277]),.data_out_278(wa[278]),.data_out_279(wa[279]),.data_out_280(wa[280]),
                .data_out_281(wa[281]),.data_out_282(wa[282]),.data_out_283(wa[283]),.data_out_284(wa[284]),.data_out_285(wa[285]),.data_out_286(wa[286]),.data_out_287(wa[287]),.data_out_288(wa[288]),.data_out_289(wa[289]),
                .data_out_290(wa[290]),.data_out_291(wa[291]),.data_out_292(wa[292]),.data_out_293(wa[293]),.data_out_294(wa[294]),.data_out_295(wa[295]),.data_out_296(wa[296]),.data_out_297(wa[297]),.data_out_298(wa[298]),
                .data_out_299(wa[299]),.data_out_300(wa[300]),.data_out_301(wa[301]),.data_out_302(wa[302]),.data_out_303(wa[303]),.data_out_304(wa[304]),.data_out_305(wa[305]),.data_out_306(wa[306]),.data_out_307(wa[307]),
                .data_out_308(wa[308]),.data_out_309(wa[309]),.data_out_310(wa[310]),.data_out_311(wa[311]),.data_out_312(wa[312]),.data_out_313(wa[313]),.data_out_314(wa[314]),.data_out_315(wa[315]),.data_out_316(wa[316]),
                .data_out_317(wa[317]),.data_out_318(wa[318]),.data_out_319(wa[319]),.data_out_320(wa[320]),.data_out_321(wa[321]),.data_out_322(wa[322]),.data_out_323(wa[323]),.data_out_324(wa[324]),.data_out_325(wa[325]),
                .data_out_326(wa[326]),.data_out_327(wa[327]),.data_out_328(wa[328]),.data_out_329(wa[329]),.data_out_330(wa[330]),.data_out_331(wa[331]),.data_out_332(wa[332]),.data_out_333(wa[333]),.data_out_334(wa[334]),
                .data_out_335(wa[335]),.data_out_336(wa[336]),.data_out_337(wa[337]),.data_out_338(wa[338]),.data_out_339(wa[339]),.data_out_340(wa[340]),.data_out_341(wa[341]),.data_out_342(wa[342]),.data_out_343(wa[343]),
                .data_out_344(wa[344]),.data_out_345(wa[345]),.data_out_346(wa[346]),.data_out_347(wa[347]),.data_out_348(wa[348]),.data_out_349(wa[349]),.data_out_350(wa[350]),.data_out_351(wa[351]),.data_out_352(wa[352]),
                .data_out_353(wa[353]),.data_out_354(wa[354]),.data_out_355(wa[355]),.data_out_356(wa[356]),.data_out_357(wa[357]),.data_out_358(wa[358]),.data_out_359(wa[359]),.data_out_360(wa[360]),.data_out_361(wa[361]),
                .data_out_362(wa[362]),.data_out_363(wa[363]),.data_out_364(wa[364]),.data_out_365(wa[365]),.data_out_366(wa[366]),.data_out_367(wa[367]),.data_out_368(wa[368]),.data_out_369(wa[369]),.data_out_370(wa[370]),
                .data_out_371(wa[371]),.data_out_372(wa[372]),.data_out_373(wa[373]),.data_out_374(wa[374]),.data_out_375(wa[375]),.data_out_376(wa[376]),.data_out_377(wa[377]),.data_out_378(wa[378]),.data_out_379(wa[379]),
                .data_out_380(wa[380]),.data_out_381(wa[381]),.data_out_382(wa[382]),.data_out_383(wa[383]),.data_out_384(wa[384]),.data_out_385(wa[385]),.data_out_386(wa[386]),.data_out_387(wa[387]),.data_out_388(wa[388]),
                .data_out_389(wa[389]),.data_out_390(wa[390]),.data_out_391(wa[391]),.data_out_392(wa[392]),.data_out_393(wa[393]),.data_out_394(wa[394]),.data_out_395(wa[395]),.data_out_396(wa[396]),.data_out_397(wa[397]),
                .data_out_398(wa[398]),.data_out_399(wa[399]),.data_out_400(wa[400]),.data_out_401(wa[401]),.data_out_402(wa[402]),.data_out_403(wa[403]),.data_out_404(wa[404]),.data_out_405(wa[405]),.data_out_406(wa[406]),
                .data_out_407(wa[407]),.data_out_408(wa[408]),.data_out_409(wa[409]),.data_out_410(wa[410]),.data_out_411(wa[411]),.data_out_412(wa[412]),.data_out_413(wa[413]),.data_out_414(wa[414]),.data_out_415(wa[415]),
                .data_out_416(wa[416]),.data_out_417(wa[417]),.data_out_418(wa[418]),.data_out_419(wa[419]),.data_out_420(wa[420]),.data_out_421(wa[421]),.data_out_422(wa[422]),.data_out_423(wa[423]),.data_out_424(wa[424]),
                .data_out_425(wa[425]),.data_out_426(wa[426]),.data_out_427(wa[427]),.data_out_428(wa[428]),.data_out_429(wa[429]),.data_out_430(wa[430]),.data_out_431(wa[431]),.data_out_432(wa[432]),.data_out_433(wa[433]),
                .data_out_434(wa[434]),.data_out_435(wa[435]),.data_out_436(wa[436]),.data_out_437(wa[437]),.data_out_438(wa[438]),.data_out_439(wa[439]),.data_out_440(wa[440]),.data_out_441(wa[441]),.data_out_442(wa[442]),
                .data_out_443(wa[443]),.data_out_444(wa[444]),.data_out_445(wa[445]),.data_out_446(wa[446]),.data_out_447(wa[447]),.data_out_448(wa[448]),.data_out_449(wa[449]),.data_out_450(wa[450]),.data_out_451(wa[451]),
                .data_out_452(wa[452]),.data_out_453(wa[453]),.data_out_454(wa[454]),.data_out_455(wa[455]),.data_out_456(wa[456]),.data_out_457(wa[457]),.data_out_458(wa[458]),.data_out_459(wa[459]),.data_out_460(wa[460]),
                .data_out_461(wa[461]),.data_out_462(wa[462]),.data_out_463(wa[463]),.data_out_464(wa[464]),.data_out_465(wa[465]),.data_out_466(wa[466]),.data_out_467(wa[467]),.data_out_468(wa[468]),.data_out_469(wa[469]),
                .data_out_470(wa[470]),.data_out_471(wa[471]),.data_out_472(wa[472]),.data_out_473(wa[473]),.data_out_474(wa[474]),.data_out_475(wa[475]),.data_out_476(wa[476]),.data_out_477(wa[477]),.data_out_478(wa[478]),
                .data_out_479(wa[479]),.data_out_480(wa[480]),.data_out_481(wa[481]),.data_out_482(wa[482]),.data_out_483(wa[483]),.data_out_484(wa[484]),.data_out_485(wa[485]),.data_out_486(wa[486]),.data_out_487(wa[487]),
                .data_out_488(wa[488]),.data_out_489(wa[489]),.data_out_490(wa[490]),.data_out_491(wa[491]),.data_out_492(wa[492]),.data_out_493(wa[493]),.data_out_494(wa[494]),.data_out_495(wa[495]),.data_out_496(wa[496]),
                .data_out_497(wa[497]),.data_out_498(wa[498]),.data_out_499(wa[499]),.data_out_500(wa[500]),.data_out_501(wa[501]),.data_out_502(wa[502]),.data_out_503(wa[503]),.data_out_504(wa[504]),.data_out_505(wa[505]),
                .data_out_506(wa[506]),.data_out_507(wa[507]),.data_out_508(wa[508]),.data_out_509(wa[509]),.data_out_510(wa[510]),.data_out_511(wa[511]),.data_out_512(wa[512]),.data_out_513(wa[513]),.data_out_514(wa[514]),
                .data_out_515(wa[515]),.data_out_516(wa[516]),.data_out_517(wa[517]),.data_out_518(wa[518]),.data_out_519(wa[519]),.data_out_520(wa[520]),.data_out_521(wa[521]),.data_out_522(wa[522]),.data_out_523(wa[523]),
                .data_out_524(wa[524]),.data_out_525(wa[525]),.data_out_526(wa[526]),.data_out_527(wa[527]),.data_out_528(wa[528]),.data_out_529(wa[529]),.data_out_530(wa[530]),.data_out_531(wa[531]),.data_out_532(wa[532]),
                .data_out_533(wa[533]),.data_out_534(wa[534]),.data_out_535(wa[535]),.data_out_536(wa[536]),.data_out_537(wa[537]),.data_out_538(wa[538]),.data_out_539(wa[539]),.data_out_540(wa[540]),.data_out_541(wa[541]),
                .data_out_542(wa[542]),.data_out_543(wa[543]),.data_out_544(wa[544]),.data_out_545(wa[545]),.data_out_546(wa[546]),.data_out_547(wa[547]),.data_out_548(wa[548]),.data_out_549(wa[549]),.data_out_550(wa[550]),
                .data_out_551(wa[551]),.data_out_552(wa[552]),.data_out_553(wa[553]),.data_out_554(wa[554]),.data_out_555(wa[555]),.data_out_556(wa[556]),.data_out_557(wa[557]),.data_out_558(wa[558]),.data_out_559(wa[559]),
                .data_out_560(wa[560]),.data_out_561(wa[561]),.data_out_562(wa[562]),.data_out_563(wa[563]),.data_out_564(wa[564]),.data_out_565(wa[565]),.data_out_566(wa[566]),.data_out_567(wa[567]),.data_out_568(wa[568]),
                .data_out_569(wa[569]),.data_out_570(wa[570]),.data_out_571(wa[571]),.data_out_572(wa[572]),.data_out_573(wa[573]),.data_out_574(wa[574]),.data_out_575(wa[575]),.data_out_576(wa[576]),.data_out_577(wa[577]),
                .data_out_578(wa[578]),.data_out_579(wa[579]),.data_out_580(wa[580]),.data_out_581(wa[581]),.data_out_582(wa[582]),.data_out_583(wa[583]),.data_out_584(wa[584]),.data_out_585(wa[585]),.data_out_586(wa[586]),
                .data_out_587(wa[587]),.data_out_588(wa[588]),.data_out_589(wa[589]),.data_out_590(wa[590]),.data_out_591(wa[591]),.data_out_592(wa[592]),.data_out_593(wa[593]),.data_out_594(wa[594]),.data_out_595(wa[595]),
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
