Noobmaster69korg/EMG_gesture_classifier_Verilog/verilog_code_files/L1_main.v

`timescale 1ns / 1ps
  
module Layer_1 (
    input clk,
    input data_reset,
    input reset,
    input signed [7:0] ch0,
    input signed [7:0] ch1,
    input signed [7:0] ch2,
    input signed [7:0] ch3,
    input signed [7:0] ch4,
    input signed [7:0] ch5,
    input clk_2,   
 /*   output signed [17:0] data_out_0,
    output signed [17:0] data_out_1,
    output signed [17:0] data_out_2,
    output signed [17:0] data_out_3,
    output signed [17:0] data_out_4,
    output signed [17:0] data_out_5,
    output signed [17:0] data_out_6,
    output signed [17:0] data_out_7,
    output signed [17:0] data_out_8,
    output signed [17:0] data_out_9,
    output signed [17:0] data_out_10,
    output signed [17:0] data_out_11,
    output signed [17:0] data_out_12,
    output signed [17:0] data_out_13,
    output signed [17:0] data_out_14,
    output signed [17:0] data_out_15,
    output signed [17:0] data_out_16,
    output signed [17:0] data_out_17,
    output signed [17:0] data_out_18,
    output signed [17:0] data_out_19,
    output signed [17:0] data_out_20,
    output signed [17:0] data_out_21,
    output signed [17:0] data_out_22,
    output signed [17:0] data_out_23,
    output signed [17:0] data_out_24,
    output signed [17:0] data_out_25,
    output signed [17:0] data_out_26,
    output signed [17:0] data_out_27,
    output signed [17:0] data_out_28,
    output signed [17:0] data_out_29,
    output signed [17:0] data_out_30,
    output signed [17:0] data_out_31, */
    
    output signed [17:0] d_out_1,
    output signed [17:0] d_out_2,
    output signed [17:0] d_out_3,
    output signed [17:0] d_out_4,
    output signed [17:0] d_out_5,
    output signed [17:0] d_out_6,
    output signed [17:0] d_out_7,
    output signed [17:0] d_out_8,
    output signed [17:0] d_out_9,
    output signed [17:0] d_out_10,
    output signed [17:0] d_out_11,
    output signed [17:0] d_out_12,
    output signed [17:0] d_out_13,
    output signed [17:0] d_out_14,
    output signed [17:0] d_out_15,
    output signed [17:0] d_out_16,
    output signed [17:0] d_out_17,
    output signed [17:0] d_out_18,
    output signed [17:0] d_out_19,
    output signed [17:0] d_out_20,
    output signed [17:0] d_out_21,
    output signed [17:0] d_out_22,
    output signed [17:0] d_out_23,
    output signed [17:0] d_out_24,
    output signed [17:0] d_out_25,
    output signed [17:0] d_out_26,
    output signed [17:0] d_out_27,
    output signed [17:0] d_out_28,
    output signed [17:0] d_out_29,
    output signed [17:0] d_out_30,
    output signed [17:0] d_out_31,
    output signed [17:0] d_out_32,
    output reset_next_stage  


);
    (*dont_touch = "true"*)wire signed [17:0] result_out [31:0]; //input to RELU block
    (*dont_touch = "true"*)wire signed [17:0] wxb [31:0]; // output of RELU block and subsequent input to Max_pooling
    (*dont_touch = "true"*)wire signed [17:0] wxc [31:0]; // output of Max_pooling block
    wire signed [7:0] w0 [31:0]; //12 weights for 32 filters
    wire signed [7:0] w1 [31:0];
    wire signed [7:0] w2 [31:0];
    wire signed [7:0] w3 [31:0];
    wire signed [7:0] w4 [31:0];
    wire signed [7:0] w5 [31:0];
    wire signed [7:0] w6 [31:0];
    wire signed [7:0] w7 [31:0];
    wire signed [7:0] w8 [31:0];
    wire signed [7:0] w9 [31:0];
    wire signed [7:0] w10 [31:0];
    wire signed [7:0] w11 [31:0];
    wire signed [7:0] bias [31:0]; // 1 bias for 32 filters
    reg q1,q2; //q2 is reset of max_pooling.  q1 is used to delay it by one cycle  
   // reg clk_2;
    wire reset_next_stage_1; // intermidiate variable for handling reset_next_stage
    wire [1:0] cycle_count; // used in counter_508 module
    (*dont_touch = "true"*) reg bram_reset; // used in write_enable for brams. 1:write into bram. 0:read from bram
    (*dont_touch = "true"*) wire [8:0] addr; // address to traverse the BRAMs
    
    initial begin
        bram_reset <= 0;
    end


    
    genvar i ;
    generate // generates 32 filter 
    for (i = 0 ; i < 32 ; i = i+1)begin
        filter f0 (.clk(clk),.reset(reset),.bias(bias[i]),.ch0(ch0),.ch1(ch1),.ch2(ch2),.ch3(ch3),.ch4(ch4),.ch5(ch5),
                   .w0(w0[i]),.w1(w1[i]),.w2(w2[i]),.w3(w3[i]),.w4(w4[i]),.w5(w5[i]),.w6(w6[i]),.w7(w7[i]),.w8(w8[i]),.w9(w9[i]),.w10(w10[i]),.w11(w11[i]),.result(result_out[i]));
    end  
    endgenerate
    
    //loads the 12 weights and 1 bias to 32 filters. wX_Y: X is filter mumber. Y is weight number
    weight_loader_L1 A1 (.clk(clk),.reset(reset),.w0_0(w0[0]), .w0_1(w1[0]), .w0_2(w2[0]), .w0_3(w3[0]), .w0_4(w4[0]), .w0_5(w5[0]), .w0_6(w6[0]), .w0_7(w7[0]), .w0_8(w8[0]), .w0_9(w9[0]), .w0_10(w10[0]), .w0_11(w11[0]), 
                        .w1_0(w0[1]), .w1_1(w1[1]), .w1_2(w2[1]), .w1_3(w3[1]), .w1_4(w4[1]), .w1_5(w5[1]), .w1_6(w6[1]), .w1_7(w7[1]), .w1_8(w8[1]), .w1_9(w9[1]), .w1_10(w10[1]), .w1_11(w11[1]), 
                        .w2_0(w0[2]), .w2_1(w1[2]), .w2_2(w2[2]), .w2_3(w3[2]), .w2_4(w4[2]), .w2_5(w5[2]), .w2_6(w6[2]), .w2_7(w7[2]), .w2_8(w8[2]), .w2_9(w9[2]), .w2_10(w10[2]), .w2_11(w11[2]), 
                        .w3_0(w0[3]), .w3_1(w1[3]), .w3_2(w2[3]), .w3_3(w3[3]), .w3_4(w4[3]), .w3_5(w5[3]), .w3_6(w6[3]), .w3_7(w7[3]), .w3_8(w8[3]), .w3_9(w9[3]), .w3_10(w10[3]), .w3_11(w11[3]), 
                        .w4_0(w0[4]), .w4_1(w1[4]), .w4_2(w2[4]), .w4_3(w3[4]), .w4_4(w4[4]), .w4_5(w5[4]), .w4_6(w6[4]), .w4_7(w7[4]), .w4_8(w8[4]), .w4_9(w9[4]), .w4_10(w10[4]), .w4_11(w11[4]), 
                        .w5_0(w0[5]), .w5_1(w1[5]), .w5_2(w2[5]), .w5_3(w3[5]), .w5_4(w4[5]), .w5_5(w5[5]), .w5_6(w6[5]), .w5_7(w7[5]), .w5_8(w8[5]), .w5_9(w9[5]), .w5_10(w10[5]), .w5_11(w11[5]), 
                        .w6_0(w0[6]), .w6_1(w1[6]), .w6_2(w2[6]), .w6_3(w3[6]), .w6_4(w4[6]), .w6_5(w5[6]), .w6_6(w6[6]), .w6_7(w7[6]), .w6_8(w8[6]), .w6_9(w9[6]), .w6_10(w10[6]), .w6_11(w11[6]), 
                        .w7_0(w0[7]), .w7_1(w1[7]), .w7_2(w2[7]), .w7_3(w3[7]), .w7_4(w4[7]), .w7_5(w5[7]), .w7_6(w6[7]), .w7_7(w7[7]), .w7_8(w8[7]), .w7_9(w9[7]), .w7_10(w10[7]), .w7_11(w11[7]), 
                        .w8_0(w0[8]), .w8_1(w1[8]), .w8_2(w2[8]), .w8_3(w3[8]), .w8_4(w4[8]), .w8_5(w5[8]), .w8_6(w6[8]), .w8_7(w7[8]), .w8_8(w8[8]), .w8_9(w9[8]), .w8_10(w10[8]), .w8_11(w11[8]), 
                        .w9_0(w0[9]), .w9_1(w1[9]), .w9_2(w2[9]), .w9_3(w3[9]), .w9_4(w4[9]), .w9_5(w5[9]), .w9_6(w6[9]), .w9_7(w7[9]), .w9_8(w8[9]), .w9_9(w9[9]), .w9_10(w10[9]), .w9_11(w11[9]), 
                        .w10_0(w0[10]), .w10_1(w1[10]), .w10_2(w2[10]), .w10_3(w3[10]), .w10_4(w4[10]), .w10_5(w5[10]), .w10_6(w6[10]), .w10_7(w7[10]), .w10_8(w8[10]), .w10_9(w9[10]), .w10_10(w10[10]), .w10_11(w11[10]), 
                        .w11_0(w0[11]), .w11_1(w1[11]), .w11_2(w2[11]), .w11_3(w3[11]), .w11_4(w4[11]), .w11_5(w5[11]), .w11_6(w6[11]), .w11_7(w7[11]), .w11_8(w8[11]), .w11_9(w9[11]), .w11_10(w10[11]), .w11_11(w11[11]), 
                        .w12_0(w0[12]), .w12_1(w1[12]), .w12_2(w2[12]), .w12_3(w3[12]), .w12_4(w4[12]), .w12_5(w5[12]), .w12_6(w6[12]), .w12_7(w7[12]), .w12_8(w8[12]), .w12_9(w9[12]), .w12_10(w10[12]), .w12_11(w11[12]), 
                        .w13_0(w0[13]), .w13_1(w1[13]), .w13_2(w2[13]), .w13_3(w3[13]), .w13_4(w4[13]), .w13_5(w5[13]), .w13_6(w6[13]), .w13_7(w7[13]), .w13_8(w8[13]), .w13_9(w9[13]), .w13_10(w10[13]), .w13_11(w11[13]), 
                        .w14_0(w0[14]), .w14_1(w1[14]), .w14_2(w2[14]), .w14_3(w3[14]), .w14_4(w4[14]), .w14_5(w5[14]), .w14_6(w6[14]), .w14_7(w7[14]), .w14_8(w8[14]), .w14_9(w9[14]), .w14_10(w10[14]), .w14_11(w11[14]), 
                        .w15_0(w0[15]), .w15_1(w1[15]), .w15_2(w2[15]), .w15_3(w3[15]), .w15_4(w4[15]), .w15_5(w5[15]), .w15_6(w6[15]), .w15_7(w7[15]), .w15_8(w8[15]), .w15_9(w9[15]), .w15_10(w10[15]), .w15_11(w11[15]), 
                        .w16_0(w0[16]), .w16_1(w1[16]), .w16_2(w2[16]), .w16_3(w3[16]), .w16_4(w4[16]), .w16_5(w5[16]), .w16_6(w6[16]), .w16_7(w7[16]), .w16_8(w8[16]), .w16_9(w9[16]), .w16_10(w10[16]), .w16_11(w11[16]), 
                        .w17_0(w0[17]), .w17_1(w1[17]), .w17_2(w2[17]), .w17_3(w3[17]), .w17_4(w4[17]), .w17_5(w5[17]), .w17_6(w6[17]), .w17_7(w7[17]), .w17_8(w8[17]), .w17_9(w9[17]), .w17_10(w10[17]), .w17_11(w11[17]), 
                        .w18_0(w0[18]), .w18_1(w1[18]), .w18_2(w2[18]), .w18_3(w3[18]), .w18_4(w4[18]), .w18_5(w5[18]), .w18_6(w6[18]), .w18_7(w7[18]), .w18_8(w8[18]), .w18_9(w9[18]), .w18_10(w10[18]), .w18_11(w11[18]), 
                        .w19_0(w0[19]), .w19_1(w1[19]), .w19_2(w2[19]), .w19_3(w3[19]), .w19_4(w4[19]), .w19_5(w5[19]), .w19_6(w6[19]), .w19_7(w7[19]), .w19_8(w8[19]), .w19_9(w9[19]), .w19_10(w10[19]), .w19_11(w11[19]), 
                        .w20_0(w0[20]), .w20_1(w1[20]), .w20_2(w2[20]), .w20_3(w3[20]), .w20_4(w4[20]), .w20_5(w5[20]), .w20_6(w6[20]), .w20_7(w7[20]), .w20_8(w8[20]), .w20_9(w9[20]), .w20_10(w10[20]), .w20_11(w11[20]), 
                        .w21_0(w0[21]), .w21_1(w1[21]), .w21_2(w2[21]), .w21_3(w3[21]), .w21_4(w4[21]), .w21_5(w5[21]), .w21_6(w6[21]), .w21_7(w7[21]), .w21_8(w8[21]), .w21_9(w9[21]), .w21_10(w10[21]), .w21_11(w11[21]), 
                        .w22_0(w0[22]), .w22_1(w1[22]), .w22_2(w2[22]), .w22_3(w3[22]), .w22_4(w4[22]), .w22_5(w5[22]), .w22_6(w6[22]), .w22_7(w7[22]), .w22_8(w8[22]), .w22_9(w9[22]), .w22_10(w10[22]), .w22_11(w11[22]), 
                        .w23_0(w0[23]), .w23_1(w1[23]), .w23_2(w2[23]), .w23_3(w3[23]), .w23_4(w4[23]), .w23_5(w5[23]), .w23_6(w6[23]), .w23_7(w7[23]), .w23_8(w8[23]), .w23_9(w9[23]), .w23_10(w10[23]), .w23_11(w11[23]), 
                        .w24_0(w0[24]), .w24_1(w1[24]), .w24_2(w2[24]), .w24_3(w3[24]), .w24_4(w4[24]), .w24_5(w5[24]), .w24_6(w6[24]), .w24_7(w7[24]), .w24_8(w8[24]), .w24_9(w9[24]), .w24_10(w10[24]), .w24_11(w11[24]), 
                        .w25_0(w0[25]), .w25_1(w1[25]), .w25_2(w2[25]), .w25_3(w3[25]), .w25_4(w4[25]), .w25_5(w5[25]), .w25_6(w6[25]), .w25_7(w7[25]), .w25_8(w8[25]), .w25_9(w9[25]), .w25_10(w10[25]), .w25_11(w11[25]), 
                        .w26_0(w0[26]), .w26_1(w1[26]), .w26_2(w2[26]), .w26_3(w3[26]), .w26_4(w4[26]), .w26_5(w5[26]), .w26_6(w6[26]), .w26_7(w7[26]), .w26_8(w8[26]), .w26_9(w9[26]), .w26_10(w10[26]), .w26_11(w11[26]), 
                        .w27_0(w0[27]), .w27_1(w1[27]), .w27_2(w2[27]), .w27_3(w3[27]), .w27_4(w4[27]), .w27_5(w5[27]), .w27_6(w6[27]), .w27_7(w7[27]), .w27_8(w8[27]), .w27_9(w9[27]), .w27_10(w10[27]), .w27_11(w11[27]), 
                        .w28_0(w0[28]), .w28_1(w1[28]), .w28_2(w2[28]), .w28_3(w3[28]), .w28_4(w4[28]), .w28_5(w5[28]), .w28_6(w6[28]), .w28_7(w7[28]), .w28_8(w8[28]), .w28_9(w9[28]), .w28_10(w10[28]), .w28_11(w11[28]), 
                        .w29_0(w0[29]), .w29_1(w1[29]), .w29_2(w2[29]), .w29_3(w3[29]), .w29_4(w4[29]), .w29_5(w5[29]), .w29_6(w6[29]), .w29_7(w7[29]), .w29_8(w8[29]), .w29_9(w9[29]), .w29_10(w10[29]), .w29_11(w11[29]), 
                        .w30_0(w0[30]), .w30_1(w1[30]), .w30_2(w2[30]), .w30_3(w3[30]), .w30_4(w4[30]), .w30_5(w5[30]), .w30_6(w6[30]), .w30_7(w7[30]), .w30_8(w8[30]), .w30_9(w9[30]), .w30_10(w10[30]), .w30_11(w11[30]), 
                        .w31_0(w0[31]), .w31_1(w1[31]), .w31_2(w2[31]), .w31_3(w3[31]), .w31_4(w4[31]), .w31_5(w5[31]), .w31_6(w6[31]), .w31_7(w7[31]), .w31_8(w8[31]), .w31_9(w9[31]), .w31_10(w10[31]), .w31_11(w11[31]),
                        .bias_0(bias[0]), .bias_1(bias[1]), .bias_2(bias[2]), .bias_3(bias[3]), .bias_4(bias[4]), .bias_5(bias[5]), .bias_6(bias[6]), .bias_7(bias[7]), .bias_8(bias[8]), .bias_9(bias[9]), .bias_10(bias[10]),
                        .bias_11(bias[11]), .bias_12(bias[12]), .bias_13(bias[13]), .bias_14(bias[14]), .bias_15(bias[15]), .bias_16(bias[16]), .bias_17(bias[17]), .bias_18(bias[18]), .bias_19(bias[19]), .bias_20(bias[20]),
                        .bias_21(bias[21]), .bias_22(bias[22]), .bias_23(bias[23]), .bias_24(bias[24]), .bias_25(bias[25]), .bias_26(bias[26]), .bias_27(bias[27]), .bias_28(bias[28]), .bias_29(bias[29]), .bias_30(bias[30]),
                        .bias_31(bias[31]) 
);

    relu A2 (.reset(reset),.data_in_1(result_out[0]), .data_in_2(result_out[1]), .data_in_3(result_out[2]), .data_in_4(result_out[3]), .data_in_5(result_out[4]), .data_in_6(result_out[5]), .data_in_7(result_out[6]),
             .data_in_8(result_out[7]), .data_in_9(result_out[8]), .data_in_10(result_out[9]), .data_in_11(result_out[10]), .data_in_12(result_out[11]), .data_in_13(result_out[12]), .data_in_14(result_out[13]), .data_in_15(result_out[14]),
             .data_in_16(result_out[15]), .data_in_17(result_out[16]), .data_in_18(result_out[17]), .data_in_19(result_out[18]), .data_in_20(result_out[19]), .data_in_21(result_out[20]), .data_in_22(result_out[21]), .data_in_23(result_out[22]),
             .data_in_24(result_out[23]), .data_in_25(result_out[24]), .data_in_26(result_out[25]), .data_in_27(result_out[26]), .data_in_28(result_out[27]), .data_in_29(result_out[28]), .data_in_30(result_out[29]), .data_in_31(result_out[30]),
             .data_in_32(result_out[31]),.data_out_1(wxb[0]), .data_out_2(wxb[1]), .data_out_3(wxb[2]), .data_out_4(wxb[3]), .data_out_5(wxb[4]), .data_out_6(wxb[5]), .data_out_7(wxb[6]), .data_out_8(wxb[7]), .data_out_9(wxb[8]), .data_out_10(wxb[9]),
             .data_out_11(wxb[10]), .data_out_12(wxb[11]), .data_out_13(wxb[12]), .data_out_14(wxb[13]), .data_out_15(wxb[14]), .data_out_16(wxb[15]), .data_out_17(wxb[16]), .data_out_18(wxb[17]), .data_out_19(wxb[18]), .data_out_20(wxb[19]), .data_out_21(wxb[20]),
             .data_out_22(wxb[21]), .data_out_23(wxb[22]), .data_out_24(wxb[23]), .data_out_25(wxb[24]), .data_out_26(wxb[25]), .data_out_27(wxb[26]), .data_out_28(wxb[27]), .data_out_29(wxb[28]), .data_out_30(wxb[29]), .data_out_31(wxb[30]), .data_out_32(wxb[31]));

    max_pooling A3(.clk(clk),.reset(q2),.data_in_1(wxb[0]), .data_in_2(wxb[1]), .data_in_3(wxb[2]), .data_in_4(wxb[3]), .data_in_5(wxb[4]), .data_in_6(wxb[5]), .data_in_7(wxb[6]), .data_in_8(wxb[7]), .data_in_9(wxb[8]), .data_in_10(wxb[9]), .data_in_11(wxb[10]),
                   .data_in_12(wxb[11]), .data_in_13(wxb[12]), .data_in_14(wxb[13]), .data_in_15(wxb[14]), .data_in_16(wxb[15]), .data_in_17(wxb[16]), .data_in_18(wxb[17]), .data_in_19(wxb[18]), .data_in_20(wxb[19]), .data_in_21(wxb[20]), .data_in_22(wxb[21]),
                   .data_in_23(wxb[22]), .data_in_24(wxb[23]), .data_in_25(wxb[24]), .data_in_26(wxb[25]), .data_in_27(wxb[26]), .data_in_28(wxb[27]), .data_in_29(wxb[28]), .data_in_30(wxb[29]), .data_in_31(wxb[30]), .data_in_32(wxb[31]),.data_out_1(wxc[0]), .data_out_2(wxc[1]),
                   .data_out_3(wxc[2]), .data_out_4(wxc[3]), .data_out_5(wxc[4]), .data_out_6(wxc[5]), .data_out_7(wxc[6]), .data_out_8(wxc[7]), .data_out_9(wxc[8]), .data_out_10(wxc[9]), .data_out_11(wxc[10]), .data_out_12(wxc[11]), .data_out_13(wxc[12]), .data_out_14(wxc[13]),
                   .data_out_15(wxc[14]), .data_out_16(wxc[15]), .data_out_17(wxc[16]), .data_out_18(wxc[17]), .data_out_19(wxc[18]), .data_out_20(wxc[19]), .data_out_21(wxc[20]), .data_out_22(wxc[21]), .data_out_23(wxc[22]), .data_out_24(wxc[23]), .data_out_25(wxc[24]), .data_out_26(wxc[25]),
                   .data_out_27(wxc[26]), .data_out_28(wxc[27]), .data_out_29(wxc[28]), .data_out_30(wxc[29]), .data_out_31(wxc[30]), .data_out_32(wxc[31]),.reset_next_stage(reset_next_stage_1));
  
  // bram_0 to bram_32 hold the output maps of layer1                 
 (*dont_touch = "true"*)    bram_0 b0 (.clka(clk_2),.addra(addr),.dina(wxc[0]),.douta(d_out_1),.wea(bram_reset),.ena(1'b1)); 
 (*dont_touch = "true"*)    bram_1 b1 (.clka(clk_2),.addra(addr),.dina(wxc[1]),.douta(d_out_2),.wea(bram_reset),.ena(1'b1)); 
     bram_2 b2 (.clka(clk_2),.addra(addr),.dina(wxc[2]),.douta(d_out_3),.wea(bram_reset),.ena(1'b1)); 
     bram_3 b3 (.clka(clk_2),.addra(addr),.dina(wxc[3]),.douta(d_out_4),.wea(bram_reset),.ena(1'b1)); 
     bram_4 b4 (.clka(clk_2),.addra(addr),.dina(wxc[4]),.douta(d_out_5),.wea(bram_reset),.ena(1'b1)); 
     bram_5 b5 (.clka(clk_2),.addra(addr),.dina(wxc[5]),.douta(d_out_6),.wea(bram_reset),.ena(1'b1)); 
     bram_6 b6 (.clka(clk_2),.addra(addr),.dina(wxc[6]),.douta(d_out_7),.wea(bram_reset),.ena(1'b1)); 
     bram_7 b7 (.clka(clk_2),.addra(addr),.dina(wxc[7]),.douta(d_out_8),.wea(bram_reset),.ena(1'b1)); 
     bram_8 b8 (.clka(clk_2),.addra(addr),.dina(wxc[8]),.douta(d_out_9),.wea(bram_reset),.ena(1'b1)); 
     bram_9 b9 (.clka(clk_2),.addra(addr),.dina(wxc[9]),.douta(d_out_10),.wea(bram_reset),.ena(1'b1)); 
     bram_10 b10 (.clka(clk_2),.addra(addr),.dina(wxc[10]),.douta(d_out_11),.wea(bram_reset),.ena(1'b1)); 
     bram_11 b11 (.clka(clk_2),.addra(addr),.dina(wxc[11]),.douta(d_out_12),.wea(bram_reset),.ena(1'b1)); 
     bram_12 b12 (.clka(clk_2),.addra(addr),.dina(wxc[12]),.douta(d_out_13),.wea(bram_reset),.ena(1'b1)); 
     bram_13 b13 (.clka(clk_2),.addra(addr),.dina(wxc[13]),.douta(d_out_14),.wea(bram_reset),.ena(1'b1)); 
     bram_14 b14 (.clka(clk_2),.addra(addr),.dina(wxc[14]),.douta(d_out_15),.wea(bram_reset),.ena(1'b1)); 
     bram_15 b15 (.clka(clk_2),.addra(addr),.dina(wxc[15]),.douta(d_out_16),.wea(bram_reset),.ena(1'b1)); 
     bram_16 b16 (.clka(clk_2),.addra(addr),.dina(wxc[16]),.douta(d_out_17),.wea(bram_reset),.ena(1'b1)); 
     bram_17 b17 (.clka(clk_2),.addra(addr),.dina(wxc[17]),.douta(d_out_18),.wea(bram_reset),.ena(1'b1)); 
     bram_18 b18 (.clka(clk_2),.addra(addr),.dina(wxc[18]),.douta(d_out_19),.wea(bram_reset),.ena(1'b1)); 
     bram_19 b19 (.clka(clk_2),.addra(addr),.dina(wxc[19]),.douta(d_out_20),.wea(bram_reset),.ena(1'b1)); 
     bram_20 b20 (.clka(clk_2),.addra(addr),.dina(wxc[20]),.douta(d_out_21),.wea(bram_reset),.ena(1'b1)); 
     bram_21 b21 (.clka(clk_2),.addra(addr),.dina(wxc[21]),.douta(d_out_22),.wea(bram_reset),.ena(1'b1)); 
     bram_22 b22 (.clka(clk_2),.addra(addr),.dina(wxc[22]),.douta(d_out_23),.wea(bram_reset),.ena(1'b1)); 
     bram_23 b23 (.clka(clk_2),.addra(addr),.dina(wxc[23]),.douta(d_out_24),.wea(bram_reset),.ena(1'b1)); 
     bram_24 b24 (.clka(clk_2),.addra(addr),.dina(wxc[24]),.douta(d_out_25),.wea(bram_reset),.ena(1'b1)); 
     bram_25 b25 (.clka(clk_2),.addra(addr),.dina(wxc[25]),.douta(d_out_26),.wea(bram_reset),.ena(1'b1)); 
     bram_26 b26 (.clka(clk_2),.addra(addr),.dina(wxc[26]),.douta(d_out_27),.wea(bram_reset),.ena(1'b1)); 
     bram_27 b27 (.clka(clk_2),.addra(addr),.dina(wxc[27]),.douta(d_out_28),.wea(bram_reset),.ena(1'b1)); 
     bram_28 b28 (.clka(clk_2),.addra(addr),.dina(wxc[28]),.douta(d_out_29),.wea(bram_reset),.ena(1'b1)); 
     bram_29 b29 (.clka(clk_2),.addra(addr),.dina(wxc[29]),.douta(d_out_30),.wea(bram_reset),.ena(1'b1)); 
     bram_30 b30 (.clka(clk_2),.addra(addr),.dina(wxc[30]),.douta(d_out_31),.wea(bram_reset),.ena(1'b1)); 
     bram_31 b31 (.clka(clk_2),.addra(addr),.dina(wxc[31]),.douta(d_out_32),.wea(bram_reset),.ena(1'b1)); 
     
    
 /*   always@(posedge clk)begin           // Generation of clock/2 block 
        if(reset)
            clk_2 <= 0;
        else
            clk_2 <= ~clk_2 ;
    */
    
    
    always@(posedge clk)begin       // always block for reset logic for maxpooling : q2 is the input to the maxpooling 
        q1<= data_reset;
        q2<= q1;
    end // from what I understand, Max_pooling gets reset TWO clock cycle after data_reset is activated
    
    
    reg x1,x2,x3;
    always@(posedge clk_2)begin //NOTE: 2x slower clock is used
        x1 <= reset_next_stage_1;  // reset_next_stage_1 is controlled by Max_Pooling module
        x2 <= x1; 
        x3 <= x2;       // similiarly x3 is delayed by 3 clock cycles. x3 is used to control r1
    end
    
    reg y1,y2;
    wire r1;
    always @(posedge clk_2)begin //NOTE: 2x slower clock is used
        y1 <= r1; // r1 is handelled by counter 508 module
        y2 <= y1; //y2 is delayed by 2 clock cycles
    end 
    
 (*dont_touch = "true"*)   assign reset_next_stage = y2 & r1 ; // effectively makes reset_next_stage high IF r1 is high for 2 clock cycles.
     
    wire reset_temp; 
(*dont_touch = "true"*)    counter_508_4times A4 (.clk(clk_2),.reset(reset_next_stage_1),.count(addr),.cycle_count(cycle_count),.done_n(reset_temp));
(*dont_touch = "true"*)   assign r1 = ( reset_temp || x3 );
    
    
    
    
    
    
    always@(*)begin
        if(reset_next_stage_1)begin
            bram_reset = 0; //reading from bram
        end 
        else begin
            if(cycle_count > 2'b0)
                bram_reset  = 0;
            else
                bram_reset = 1; //writing into bram
       end
       end
        
        // data_out is getting assigned the outputs of max_pooling
        assign data_out_0 = wxc[0]; 
        assign data_out_1 = wxc[1]; 
        assign data_out_2 = wxc[2]; 
        assign data_out_3 = wxc[3]; 
        assign data_out_4 = wxc[4]; 
        assign data_out_5 = wxc[5]; 
        assign data_out_6 = wxc[6]; 
        assign data_out_7 = wxc[7]; 
        assign data_out_8 = wxc[8];   
        assign data_out_9 = wxc[9]; 
        assign data_out_10 = wxc[10]; 
        assign data_out_11 = wxc[11]; 
        assign data_out_12 = wxc[12]; 
        assign data_out_13 = wxc[13]; 
        assign data_out_14 = wxc[14]; 
        assign data_out_15 = wxc[15]; 
        assign data_out_16 = wxc[16]; 
        assign data_out_17 = wxc[17]; 
        assign data_out_18 = wxc[18]; 
        assign data_out_19 = wxc[19]; 
        assign data_out_20 = wxc[20]; 
        assign data_out_21 = wxc[21]; 
        assign data_out_22 = wxc[22]; 
        assign data_out_23 = wxc[23]; 
        assign data_out_24 = wxc[24]; 
        assign data_out_25 = wxc[25]; 
        assign data_out_26 = wxc[26]; 
        assign data_out_27 = wxc[27]; 
        assign data_out_28 = wxc[28]; 
        assign data_out_29 = wxc[29]; 
        assign data_out_30 = wxc[30]; 
        assign data_out_31 = wxc[31];   


endmodule 
     
module counter_508_4times (
    input clk,
    input reset,
    output reg [8:0] count,   // 9 bits to count up to 508
    output reg [1:0]cycle_count, // To count 0 to 3 (4 cycles)
    output reg done_n          // Active low during counting, high when done
);

  //  reg [1:0] cycle_count;     

    always @(posedge clk or posedge reset) begin
        if (reset) begin
            count       <= 9'd0;
            cycle_count <= 2'd0;
            done_n      <= 1'b0;
        end 
        else begin
            if (done_n == 1'b0) begin
                if (count < 9'd508) begin
                    count <= count + 1; 
                end 
                else begin // count is 508
                    if (cycle_count < 2'd3) begin
                        cycle_count <= cycle_count + 1;
                        count <= 9'd1;
                    end 
                    else begin
                        done_n <= 1'b1;      // Done after 4 cycles
                        count  <= 9'd508;    // Hold at 508 so no mroe counting for now
                    end
                end
            end
        end
    end

endmodule
 
   
module filter (
    input   clk,
    input   reset,  
    input  signed [7:0] bias,
    input  signed  [7:0]  ch0,
    input  signed  [7:0]  ch1,
    input  signed  [7:0]  ch2,
    input  signed  [7:0]  ch3,
    input  signed  [7:0]  ch4,
    input  signed  [7:0]  ch5,
    input  signed  [7:0]  w0,
    input  signed  [7:0]  w1,
    input  signed  [7:0]  w2,
    input  signed  [7:0]  w3,
    input  signed  [7:0]  w4,
    input  signed  [7:0]  w5,
    input  signed  [7:0]  w6,
    input  signed  [7:0]  w7,
    input  signed  [7:0]  w8,
    input  signed  [7:0]  w9,
    input  signed  [7:0]  w10,
    input  signed  [7:0]  w11, 
    output signed [17:0] result
);
    reg signed [15:0] products_phase1 [0:5];
    reg signed [15:0] products_phase2 [0:5];
    wire signed [15:0] temp [0:5];
    
    genvar i;
    always @(posedge clk) begin
        if (reset) begin
                products_phase1[0] <= 0;
                products_phase1[1] <= 0;
                products_phase1[2] <= 0;
                products_phase1[3] <= 0;
                products_phase1[4] <= 0;
                products_phase1[5] <= 0;
               
                products_phase2[0] <= 0;
                products_phase2[1] <= 0;
                products_phase2[2] <= 0;
                products_phase2[3] <= 0;
                products_phase2[4] <= 0;
                products_phase2[5] <= 0;
        end 
        else begin // here the rest of the emg ensures that at each clk cycle, u get a new row for ch0 to ch1
                products_phase1[0] <= ch0 * w0;
                products_phase1[1] <= ch1 * w1;
                products_phase1[2] <= ch2 * w2;
                products_phase1[3] <= ch3 * w3;
                products_phase1[4] <= ch4 * w4;
                products_phase1[5] <= ch5 * w5;
               
                products_phase2[0] <= ch0 * w6;
                products_phase2[1] <= ch1 * w7;
                products_phase2[2] <= ch2 * w8;
                products_phase2[3] <= ch3 * w9;
                products_phase2[4] <= ch4 * w10;
                products_phase2[5] <= ch5 * w11;
        end
    end
    generate 
    for(i = 0 ; i<6 ; i=i+1)begin  //6 D-flipFlop are instantiated
        DFF_15bits_L1 D(.Q(temp[i]),.D(products_phase1[i]),.clk(clk),.reset(reset)); // refer to diagram in Pradyuman Bhaiya's. makes sense
    end
    endgenerate 
    
           assign result = temp[0] + products_phase2[0] + // result is the one the convolution output. like these 1018 outputs are achieved for each of the 32 filters.
                    temp[1] + products_phase2[1] +
                    temp[2] + products_phase2[2] +
                    temp[3] + products_phase2[3] +
                    temp[4] + products_phase2[4] +
                    temp[5] + products_phase2[5] + bias;
                    
                
    endmodule
    

module DFF_15bits_L1(
    input clk,
    input reset,
    input  signed [15:0] D,
    output reg signed [15:0] Q
    );
    always @(posedge clk)begin
        if(reset)
            Q <= 0;
        else
            Q <= D;
    end
    endmodule
   
  

module weight_loader_L1 #(parameter N = 32)(
    input clk,
    input reset,
    
    output reg signed [7:0] bias_0,
    output reg signed [7:0] bias_1,
    output reg signed [7:0] bias_2,
    output reg signed [7:0] bias_3,
    output reg signed [7:0] bias_4,
    output reg signed [7:0] bias_5,
    output reg signed [7:0] bias_6,
    output reg signed [7:0] bias_7,
    output reg signed [7:0] bias_8,
    output reg signed [7:0] bias_9,
    output reg signed [7:0] bias_10,
    output reg signed [7:0] bias_11,
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
    output reg signed [7:0] w29_8,
    output reg signed [7:0] w29_9,
    output reg signed [7:0] w29_10,
    output reg signed [7:0] w29_11,
    output reg signed [7:0] w30_0,
    output reg signed [7:0] w30_1,
    output reg signed [7:0] w30_2,
    output reg signed [7:0] w30_3,
    output reg signed [7:0] w30_4,
    output reg signed [7:0] w30_5,
    output reg signed [7:0] w30_6,
    output reg signed [7:0] w30_7,
    output reg signed [7:0] w30_8,
    output reg signed [7:0] w30_9,
    output reg signed [7:0] w30_10,
    output reg signed [7:0] w30_11,
    output reg signed [7:0] w31_0,
    output reg signed [7:0] w31_1,
    output reg signed [7:0] w31_2,
    output reg signed [7:0] w31_3,
    output reg signed [7:0] w31_4,
    output reg signed [7:0] w31_5,
    output reg signed [7:0] w31_6,
    output reg signed [7:0] w31_7,
    output reg signed [7:0] w31_8,
    output reg signed [7:0] w31_9,
    output reg signed [7:0] w31_10,
    output reg signed [7:0] w31_11
    );
    localparam width = N * 96; // 96 = 12(no. of weights)x8(weights are 8 bit)
    reg signed [width - 1:0] shift_reg; //each weight gets loaded into this
    reg signed [255:0] bias_reg; // 256 = 32(no. of biases)x8(weights are 8 bit)
    reg [8:0] counter = 0 ; 
    reg [8:0] flag = 0;
    reg [5:0] counter_2 = 0;
    reg [5:0] flag_2 = 0;
    wire [7:0] data_out;
    wire [7:0] bias_out;  
    reg ena_reg = 0;
    reg ena_reg_2 = 0;
    
    
    
    // these brams are used in only READ mode
    blk_mem_gen_0_L1 b0 (.clka(clk),.ena(ena_reg),.addra(counter),.douta(data_out));  //contains weights of layer 1
    blk_mem_gen_1_L1 b1 (.clka(clk),.ena(ena_reg_2),.addra(counter_2),.douta(bias_out)); //contains biases for layer1
    
    always@(posedge clk)begin
        if(reset)begin
            counter <= 0;
            flag <= 0;
            shift_reg <= 0;
            ena_reg <= 0;
        end
        else begin
            if(counter < 386) begin //386 because of 2 cycle latency
                flag = flag + 1; 
                ena_reg = 1; // enables to read from paramter memory
                if(flag > 1) begin
                    shift_reg <= {shift_reg[width -8:0],data_out}; // left-shifting the register. read parameter comes here
                    //bias_reg <= {bias_reg[247:0],bias_out};
                    counter <= counter + 1;
                 end 
             end
             else begin 
                ena_reg = 0;
             end
         end    
     end
    
    always@(posedge clk)begin
        if(reset)begin
            ena_reg_2 = 0;
            counter_2 <= 0;
            bias_reg = 0;
            flag_2 <= 0 ;
        end
        else begin
            if(counter_2 < 34)begin
            flag_2 = flag_2 + 1;
            ena_reg_2 <= 1;
                if(flag_2 > 1)begin
                    counter_2 <= counter_2 + 1;
                    bias_reg <= {bias_reg[247:0],bias_out};
                end
            end
            else
                ena_reg_2 <= 0;
        end
    end
    always@(*)begin
        if(counter_2 == 34)begin // assigning the values read from memory to bias variables
            bias_0 <= bias_reg[256 - (0*8) - 1 : 256 - (1*8)]; 
            bias_1 <= bias_reg[256 - (1*8) - 1 : 256 - (2*8)]; 
            bias_2 <= bias_reg[256 - (2*8) - 1 : 256 - (3*8)]; 
            bias_3 <= bias_reg[256 - (3*8) - 1 : 256 - (4*8)]; 
            bias_4 <= bias_reg[256 - (4*8) - 1 : 256 - (5*8)]; 
            bias_5 <= bias_reg[256 - (5*8) - 1 : 256 - (6*8)]; 
            bias_6 <= bias_reg[256 - (6*8) - 1 : 256 - (7*8)]; 
            bias_7 <= bias_reg[256 - (7*8) - 1 : 256 - (8*8)]; 
            bias_8 <= bias_reg[256 - (8*8) - 1 : 256 - (9*8)]; 
            bias_9 <= bias_reg[256 - (9*8) - 1 : 256 - (10*8)]; 
            bias_10 <= bias_reg[256 - (10*8) - 1 : 256 - (11*8)]; 
            bias_11 <= bias_reg[256 - (11*8) - 1 : 256 - (12*8)]; 
            bias_12 <= bias_reg[256 - (12*8) - 1 : 256 - (13*8)]; 
            bias_13 <= bias_reg[256 - (13*8) - 1 : 256 - (14*8)]; 
            bias_14 <= bias_reg[256 - (14*8) - 1 : 256 - (15*8)]; 
            bias_15 <= bias_reg[256 - (15*8) - 1 : 256 - (16*8)]; 
            bias_16 <= bias_reg[256 - (16*8) - 1 : 256 - (17*8)]; 
            bias_17 <= bias_reg[256 - (17*8) - 1 : 256 - (18*8)]; 
            bias_18 <= bias_reg[256 - (18*8) - 1 : 256 - (19*8)]; 
            bias_19 <= bias_reg[256 - (19*8) - 1 : 256 - (20*8)]; 
            bias_20 <= bias_reg[256 - (20*8) - 1 : 256 - (21*8)]; 
            bias_21 <= bias_reg[256 - (21*8) - 1 : 256 - (22*8)]; 
            bias_22 <= bias_reg[256 - (22*8) - 1 : 256 - (23*8)]; 
            bias_23 <= bias_reg[256 - (23*8) - 1 : 256 - (24*8)]; 
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
             w31_5<= 0 ;
             w31_6<= 0 ;
             w31_7<= 0 ;
             w31_8<= 0 ;
             w31_9<= 0 ;
             w31_10<= 0 ;
             w31_11<= 0 ;
    
        end
        end
endmodule


//////////////////////////////////////

`timescale 1ns / 1ps


module relu(
    input reset,
    input signed [17:0] data_in_1, data_in_2, data_in_3, data_in_4, data_in_5, data_in_6, data_in_7, data_in_8,
    input signed [17:0] data_in_9, data_in_10, data_in_11, data_in_12, data_in_13, data_in_14, data_in_15, data_in_16,
    input signed [17:0] data_in_17, data_in_18, data_in_19, data_in_20, data_in_21, data_in_22, data_in_23, data_in_24,
    input signed [17:0] data_in_25, data_in_26, data_in_27, data_in_28, data_in_29, data_in_30, data_in_31, data_in_32,
   (*dont_touch = "true"*) output reg signed [17:0] data_out_1, data_out_2, data_out_3, data_out_4, data_out_5, data_out_6, data_out_7, data_out_8,
   (*dont_touch = "true"*) output reg signed [17:0] data_out_9, data_out_10, data_out_11, data_out_12, data_out_13, data_out_14, data_out_15, data_out_16,
   (*dont_touch = "true"*) output reg signed [17:0] data_out_17, data_out_18, data_out_19, data_out_20, data_out_21, data_out_22, data_out_23, data_out_24,
   (*dont_touch = "true"*) output reg signed [17:0] data_out_25, data_out_26, data_out_27, data_out_28, data_out_29, data_out_30, data_out_31, data_out_32
);

    always @(*) begin
        if (reset) begin
            data_out_1 <= 0; data_out_2 <= 0; data_out_3 <= 0; data_out_4 <= 0;
            data_out_5 <= 0; data_out_6 <= 0; data_out_7 <= 0; data_out_8 <= 0;
            data_out_9 <= 0; data_out_10 <= 0; data_out_11 <= 0; data_out_12 <= 0;
            data_out_13 <= 0; data_out_14 <= 0; data_out_15 <= 0; data_out_16 <= 0;
            data_out_17 <= 0; data_out_18 <= 0; data_out_19 <= 0; data_out_20 <= 0;
            data_out_21 <= 0; data_out_22 <= 0; data_out_23 <= 0; data_out_24 <= 0;
            data_out_25 <= 0; data_out_26 <= 0; data_out_27 <= 0; data_out_28 <= 0;
            data_out_29 <= 0; data_out_30 <= 0; data_out_31 <= 0; data_out_32 <= 0;
        end 
        else begin // implements rectification
            data_out_1 <= (data_in_1[17] == 0) ? data_in_1 : 0;
            data_out_2 <= (data_in_2[17] == 0) ? data_in_2 : 0;
            data_out_3 <= (data_in_3[17] == 0) ? data_in_3 : 0;
            data_out_4 <= (data_in_4[17] == 0) ? data_in_4 : 0;
            data_out_5 <= (data_in_5[17] == 0) ? data_in_5 : 0;
            data_out_6 <= (data_in_6[17] == 0) ? data_in_6 : 0;
            data_out_7 <= (data_in_7[17] == 0) ? data_in_7 : 0;
            data_out_8 <= (data_in_8[17] == 0) ? data_in_8 : 0;
            data_out_9 <= (data_in_9[17] == 0) ? data_in_9 : 0;
            data_out_10 <= (data_in_10[17] == 0) ? data_in_10 : 0;
            data_out_11 <= (data_in_11[17] == 0) ? data_in_11 : 0;
            data_out_12 <= (data_in_12[17] == 0) ? data_in_12 : 0;
            data_out_13 <= (data_in_13[17] == 0) ? data_in_13 : 0;
            data_out_14 <= (data_in_14[17] == 0) ? data_in_14 : 0;
            data_out_15 <= (data_in_15[17] == 0) ? data_in_15 : 0;
            data_out_16 <= (data_in_16[17] == 0) ? data_in_16 : 0;
            data_out_17 <= (data_in_17[17] == 0) ? data_in_17 : 0;
            data_out_18 <= (data_in_18[17] == 0) ? data_in_18 : 0;
            data_out_19 <= (data_in_19[17] == 0) ? data_in_19 : 0;
            data_out_20 <= (data_in_20[17] == 0) ? data_in_20 : 0;
            data_out_21 <= (data_in_21[17] == 0) ? data_in_21 : 0;
            data_out_22 <= (data_in_22[17] == 0) ? data_in_22 : 0;
            data_out_23 <= (data_in_23[17] == 0) ? data_in_23 : 0;
            data_out_24 <= (data_in_24[17] == 0) ? data_in_24 : 0;
            data_out_25 <= (data_in_25[17] == 0) ? data_in_25 : 0;
            data_out_26 <= (data_in_26[17] == 0) ? data_in_26 : 0;
            data_out_27 <= (data_in_27[17] == 0) ? data_in_27 : 0;
            data_out_28 <= (data_in_28[17] == 0) ? data_in_28 : 0;
            data_out_29 <= (data_in_29[17] == 0) ? data_in_29 : 0;
            data_out_30 <= (data_in_30[17] == 0) ? data_in_30 : 0;
            data_out_31 <= (data_in_31[17] == 0) ? data_in_31 : 0;
            data_out_32 <= (data_in_32[17] == 0) ? data_in_32 : 0;
        end
    end

endmodule






module max_pooling(
    input clk,
    input reset,
    (*dont_touch = "true"*)  output reset_next_stage,
    input signed [17:0] data_in_1, data_in_2, data_in_3, data_in_4, data_in_5, data_in_6, data_in_7, data_in_8,
    input signed [17:0] data_in_9, data_in_10, data_in_11, data_in_12, data_in_13, data_in_14, data_in_15, data_in_16,
    input signed [17:0] data_in_17, data_in_18, data_in_19, data_in_20, data_in_21, data_in_22, data_in_23, data_in_24,
    input signed [17:0] data_in_25, data_in_26, data_in_27, data_in_28, data_in_29, data_in_30, data_in_31, data_in_32,
    output signed [17:0] data_out_1, data_out_2, data_out_3, data_out_4, data_out_5, data_out_6, data_out_7, data_out_8,
   (*dont_touch = "true"*) output signed [17:0] data_out_9, data_out_10, data_out_11, data_out_12, data_out_13, data_out_14, data_out_15, data_out_16,
   (*dont_touch = "true"*) output signed [17:0] data_out_17, data_out_18, data_out_19, data_out_20, data_out_21, data_out_22, data_out_23, data_out_24,
   (*dont_touch = "true"*) output signed [17:0] data_out_25, data_out_26, data_out_27, data_out_28, data_out_29, data_out_30, data_out_31, data_out_32
    );
    
    max m1  (.clk(clk),.reset(reset),.data_in(data_in_1),.data_out(data_out_1));
    max m2  (.clk(clk),.reset(reset),.data_in(data_in_2),.data_out(data_out_2));
    max m3  (.clk(clk),.reset(reset),.data_in(data_in_3),.data_out(data_out_3));
    max m4  (.clk(clk),.reset(reset),.data_in(data_in_4),.data_out(data_out_4));
    max m5  (.clk(clk),.reset(reset),.data_in(data_in_5),.data_out(data_out_5));
    max m6  (.clk(clk),.reset(reset),.data_in(data_in_6),.data_out(data_out_6));
    max m7  (.clk(clk),.reset(reset),.data_in(data_in_7),.data_out(data_out_7));
    max m8  (.clk(clk),.reset(reset),.data_in(data_in_8),.data_out(data_out_8));
    max m9  (.clk(clk),.reset(reset),.data_in(data_in_9),.data_out(data_out_9));
    max m10 (.clk(clk),.reset(reset),.data_in(data_in_10),.data_out(data_out_10));
    max m11 (.clk(clk),.reset(reset),.data_in(data_in_11),.data_out(data_out_11));
    max m12 (.clk(clk),.reset(reset),.data_in(data_in_12),.data_out(data_out_12));
    max m13 (.clk(clk),.reset(reset),.data_in(data_in_13),.data_out(data_out_13));
    max m14 (.clk(clk),.reset(reset),.data_in(data_in_14),.data_out(data_out_14));
    max m15 (.clk(clk),.reset(reset),.data_in(data_in_15),.data_out(data_out_15));
    max m16 (.clk(clk),.reset(reset),.data_in(data_in_16),.data_out(data_out_16));
    max m17 (.clk(clk),.reset(reset),.data_in(data_in_17),.data_out(data_out_17));
    max m18 (.clk(clk),.reset(reset),.data_in(data_in_18),.data_out(data_out_18));
    max m19 (.clk(clk),.reset(reset),.data_in(data_in_19),.data_out(data_out_19));
    max m20 (.clk(clk),.reset(reset),.data_in(data_in_20),.data_out(data_out_20));
    max m21 (.clk(clk),.reset(reset),.data_in(data_in_21),.data_out(data_out_21));
    max m22 (.clk(clk),.reset(reset),.data_in(data_in_22),.data_out(data_out_22));
    max m23 (.clk(clk),.reset(reset),.data_in(data_in_23),.data_out(data_out_23));
    max m24 (.clk(clk),.reset(reset),.data_in(data_in_24),.data_out(data_out_24));
    max m25 (.clk(clk),.reset(reset),.data_in(data_in_25),.data_out(data_out_25));
    max m26 (.clk(clk),.reset(reset),.data_in(data_in_26),.data_out(data_out_26));
    max m27 (.clk(clk),.reset(reset),.data_in(data_in_27),.data_out(data_out_27));
    max m28 (.clk(clk),.reset(reset),.data_in(data_in_28),.data_out(data_out_28));
    max m29 (.clk(clk),.reset(reset),.data_in(data_in_29),.data_out(data_out_29));
    max m30 (.clk(clk),.reset(reset),.data_in(data_in_30),.data_out(data_out_30));
    max m31 (.clk(clk),.reset(reset),.data_in(data_in_31),.data_out(data_out_31));
    max m32 (.clk(clk),.reset(reset),.data_in(data_in_32),.data_out(data_out_32));
    
    reset_next_1 m33 (.clk(clk),.reset(reset),.out(reset_next_stage));
    endmodule

module max (
    input clk,
    input signed [17:0]data_in,
    input reset,
  //  output reg reset_next_stage,
   (*dont_touch = "true"*) output reg signed [17:0]data_out
    );
 
    reg signed [17:0] q1,q2 = 0;
    reg [8:0]flag = 1;
    reg [3:0] counter = 0;
    always@(posedge clk)begin
        if(reset)begin
            data_out <= 0;
            q1 <= 0;
            q2 <= 0;
            flag <= 0;
        end
        else begin //say values are 3 and 4. output should be 4
            q1 <= data_in; //1st clk cycle, q1 is 3 and q2 is 0. flag updated to 1
            q2 <= q1; //2nd clk cycle, q1 is 4, q2 is 3. flag updated to 2
            flag = flag + 1; 
            if(flag == 3)begin // 3rd clk cycle flag is 3 but non blocking assigment
                data_out <= (q1>q2)?q1:q2; // so q1 equal to 4 and q2 equal to 3 is considered here
                flag <= 1;
            end   
        end
     end
     
 /*    always@(posedge clk) begin
        if(reset) begin
            reset_next_stage <= 1;
            counter <= 0;
        end
        else begin
            if((counter > 1) && (counter < 6))
                reset_next_stage <= 0;
            else
                reset_next_stage <= 1;    
        counter <= counter + 1;       
     end end      */
   endmodule 
   
   
module reset_next_1( //handles reset output of max_pooling
    input clk,
    input reset,
    output reg out
    );
    reg q1,q2;
    always @(posedge clk)begin
        q1 <= reset;
        q2 <= q1;
        out <= q2;
    end
endmodule
    
