Noobmaster69korg/EMG_gesture_classifier_Verilog/verilog_code_files/Dense2.v

`timescale 1ns / 1ps


module Dense2_top_module(

input clk,
(*keep = "true" *)input reset,   
input signed [31:0] data_in_1,
input signed [31:0] data_in_2,
input signed [31:0] data_in_3,
input signed [31:0] data_in_4,
input signed [31:0] data_in_5,
input signed [31:0] data_in_6,
input signed [31:0] data_in_7,
input signed [31:0] data_in_8,
input signed [31:0] data_in_9,
input signed [31:0] data_in_10,
input signed [31:0] data_in_11,
input signed [31:0] data_in_12,
input signed [31:0] data_in_13,
input signed [31:0] data_in_14,
input signed [31:0] data_in_15,
input signed [31:0] data_in_16,
input signed [31:0] data_in_17,
input signed [31:0] data_in_18,
input signed [31:0] data_in_19,
input signed [31:0] data_in_20,
input signed [31:0] data_in_21,
input signed [31:0] data_in_22,
input signed [31:0] data_in_23,
input signed [31:0] data_in_24,
input signed [31:0] data_in_25,
input signed [31:0] data_in_26,
input signed [31:0] data_in_27,
input signed [31:0] data_in_28,
input signed [31:0] data_in_29,
input signed [31:0] data_in_30,
input signed [31:0] data_in_31,
input signed [31:0] data_in_32,
input signed [31:0] data_in_33,
input signed [31:0] data_in_34,
input signed [31:0] data_in_35,
input signed [31:0] data_in_36,
input signed [31:0] data_in_37,
input signed [31:0] data_in_38,
input signed [31:0] data_in_39,
input signed [31:0] data_in_40,
input signed [31:0] data_in_41,
input signed [31:0] data_in_42,
input signed [31:0] data_in_43,
input signed [31:0] data_in_44,
input signed [31:0] data_in_45,
input signed [31:0] data_in_46,
input signed [31:0] data_in_47,
input signed [31:0] data_in_48,
input signed [31:0] data_in_49,
input signed [31:0] data_in_50,
input signed [31:0] data_in_51,
input signed [31:0] data_in_52,
input signed [31:0] data_in_53,
input signed [31:0] data_in_54,
input signed [31:0] data_in_55,
input signed [31:0] data_in_56,
input signed [31:0] data_in_57,
input signed [31:0] data_in_58,
input signed [31:0] data_in_59,
input signed [31:0] data_in_60,
input signed [31:0] data_in_61,
input signed [31:0] data_in_62,
input signed [31:0] data_in_63,
input signed [31:0] data_in_64,


output reset_next_stage,
output signed [38:0] data_out


    );
  wire signed [15:0] q [63:0];
  wire signed [7:0] bias_wire;
  brams_for_layer_2 a1 (.clk(clk),.reset(reset),.bias(bias_wire),.data_out_1(q[0]),.data_out_2(q[1]),.data_out_3(q[2]),.data_out_4(q[3]),
                        .data_out_5(q[4]),.data_out_6(q[5]),.data_out_7(q[6]),.data_out_8(q[7]),.data_out_9(q[8]),     
                        .data_out_10(q[9]),.data_out_11(q[10]),.data_out_12(q[11]),.data_out_13(q[12]),.data_out_14(q[13]),
                        .data_out_15(q[14]),.data_out_16(q[15]),.data_out_17(q[16]),.data_out_18(q[17]),.data_out_19(q[18]),
                        .data_out_20(q[19]),.data_out_21(q[20]),.data_out_22(q[21]),.data_out_23(q[22]),.data_out_24(q[23]),
                        .data_out_25(q[24]),.data_out_26(q[25]),.data_out_27(q[26]),.data_out_28(q[27]),.data_out_29(q[28]),
                        .data_out_30(q[29]),.data_out_31(q[30]),.data_out_32(q[31]),.data_out_33(q[32]),.data_out_34(q[33]),
                        .data_out_35(q[34]),.data_out_36(q[35]),.data_out_37(q[36]),.data_out_38(q[37]),.data_out_39(q[38]),
                        .data_out_40(q[39]),.data_out_41(q[40]),.data_out_42(q[41]),.data_out_43(q[42]),.data_out_44(q[43]),
                        .data_out_45(q[44]),.data_out_46(q[45]),.data_out_47(q[46]),.data_out_48(q[47]),.data_out_49(q[48]),
                        .data_out_50(q[49]),.data_out_51(q[50]),.data_out_52(q[51]),.data_out_53(q[52]),.data_out_54(q[53]),
                        .data_out_55(q[54]),.data_out_56(q[55]),.data_out_57(q[56]),.data_out_58(q[57]),.data_out_59(q[58]),
                        .data_out_60(q[59]),.data_out_61(q[60]),.data_out_62(q[61]),.data_out_63(q[62]),.data_out_64(q[63]));
  
  Mac_units2         a2   (.clk(clk),.reset(reset),.bias(bias_wire),.ram_data_1(q[0]),.ram_data_2(q[1]),.ram_data_3(q[2]),.ram_data_4(q[3]),  
                         .ram_data_5(q[4]),.ram_data_6(q[5]),.ram_data_7(q[6]),.ram_data_8(q[7]),.ram_data_9(q[8]),.ram_data_10(q[9]),
                         .ram_data_11(q[10]),.ram_data_12(q[11]),.ram_data_13(q[12]),.ram_data_14(q[13]),.ram_data_15(q[14]),.ram_data_16(q[15]),
                         .ram_data_17(q[16]),.ram_data_18(q[17]),.ram_data_19(q[18]),.ram_data_20(q[19]),.ram_data_21(q[20]),.ram_data_22(q[21]),
                         .ram_data_23(q[22]),.ram_data_24(q[23]),.ram_data_25(q[24]),.ram_data_26(q[25]),.ram_data_27(q[26]),.ram_data_28(q[27]),
                         .ram_data_29(q[28]),.ram_data_30(q[29]),.ram_data_31(q[30]),.ram_data_32(q[31]),.ram_data_33(q[32]),.ram_data_34(q[33]),
                         .ram_data_35(q[34]),.ram_data_36(q[35]),.ram_data_37(q[36]),.ram_data_38(q[37]),.ram_data_39(q[38]),.ram_data_40(q[39]),
                         .ram_data_41(q[40]),.ram_data_42(q[41]),.ram_data_43(q[42]),.ram_data_44(q[43]),.ram_data_45(q[44]),.ram_data_46(q[45]),
                         .ram_data_47(q[46]),.ram_data_48(q[47]),.ram_data_49(q[48]),.ram_data_50(q[49]),.ram_data_51(q[50]),.ram_data_52(q[51]),
                         .ram_data_53(q[52]),.ram_data_54(q[53]),.ram_data_55(q[54]),.ram_data_56(q[55]),.ram_data_57(q[56]),.ram_data_58(q[57]),
                         .ram_data_59(q[58]),.ram_data_60(q[59]),.ram_data_61(q[60]),.ram_data_62(q[61]),.ram_data_63(q[62]),.ram_data_64(q[63]),
                         
                         .data_in_1(data_in_1),.data_in_2(data_in_2),.data_in_3(data_in_3),.data_in_4(data_in_4),.data_in_5(data_in_5),.data_in_6(data_in_6),
                         .data_in_7(data_in_7),.data_in_8(data_in_8),.data_in_9(data_in_9),.data_in_10(data_in_10),.data_in_11(data_in_11),.data_in_12(data_in_12),
                         .data_in_13(data_in_13),.data_in_14(data_in_14),.data_in_15(data_in_15),.data_in_16(data_in_16),.data_in_17(data_in_17),.data_in_18(data_in_18),
                         .data_in_19(data_in_19),.data_in_20(data_in_20),.data_in_21(data_in_21),.data_in_22(data_in_22),.data_in_23(data_in_23),.data_in_24(data_in_24),
                         .data_in_25(data_in_25),.data_in_26(data_in_26),.data_in_27(data_in_27),.data_in_28(data_in_28),.data_in_29(data_in_29),.data_in_30(data_in_30),
                         .data_in_31(data_in_31),.data_in_32(data_in_32),.data_in_33(data_in_33),.data_in_34(data_in_34),.data_in_35(data_in_35),.data_in_36(data_in_36),
                         .data_in_37(data_in_37),.data_in_38(data_in_38),.data_in_39(data_in_39),.data_in_40(data_in_40),.data_in_41(data_in_41),.data_in_42(data_in_42),
                         .data_in_43(data_in_43),.data_in_44(data_in_44),.data_in_45(data_in_45),.data_in_46(data_in_46),.data_in_47(data_in_47),.data_in_48(data_in_48),
                         .data_in_49(data_in_49),.data_in_50(data_in_50),.data_in_51(data_in_51),.data_in_52(data_in_52),.data_in_53(data_in_53),.data_in_54(data_in_54),
                         .data_in_55(data_in_55),.data_in_56(data_in_56),.data_in_57(data_in_57),.data_in_58(data_in_58),.data_in_59(data_in_59),.data_in_60(data_in_60),
                         .data_in_61(data_in_61),.data_in_62(data_in_62),.data_in_63(data_in_63),.data_in_64(data_in_64),.data_out(data_out));
                         
 reset_next_Dense_2   a3 (.clk(clk),.reset(reset),.out(reset_next_stage));
endmodule 


//////////////////////////////////////////// brams for Dense Layer_2 ////////////////////////////////////////////
module brams_for_layer_2 (
    input clk,
    input reset,
    
output signed [7:0] data_out_1,
output signed [7:0] data_out_2,
output signed [7:0] data_out_3,
output signed [7:0] data_out_4,
output signed [7:0] data_out_5,
output signed [7:0] data_out_6,
output signed [7:0] data_out_7,
output signed [7:0] data_out_8,
output signed [7:0] data_out_9,
output signed [7:0] data_out_10,
output signed [7:0] data_out_11,
output signed [7:0] data_out_12,
output signed [7:0] data_out_13,
output signed [7:0] data_out_14,
output signed [7:0] data_out_15,
output signed [7:0] data_out_16,
output signed [7:0] data_out_17,
output signed [7:0] data_out_18,
output signed [7:0] data_out_19,
output signed [7:0] data_out_20,
output signed [7:0] data_out_21,
output signed [7:0] data_out_22,
output signed [7:0] data_out_23,
output signed [7:0] data_out_24,
output signed [7:0] data_out_25,
output signed [7:0] data_out_26,
output signed [7:0] data_out_27,
output signed [7:0] data_out_28,
output signed [7:0] data_out_29,
output signed [7:0] data_out_30,
output signed [7:0] data_out_31,
output signed [7:0] data_out_32,
output signed [7:0] data_out_33,
output signed [7:0] data_out_34,
output signed [7:0] data_out_35,
output signed [7:0] data_out_36,
output signed [7:0] data_out_37,
output signed [7:0] data_out_38,
output signed [7:0] data_out_39,
output signed [7:0] data_out_40,
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
input clk,
input  signed [38:0] data_in_1,
input  signed [7:0] data_in_2,
output reg signed [36:0] data_out
);

always @(posedge clk) begin
	data_out = data_in_1 * data_in_2;
end
endmodule


///////////////////////////////////////  reset_next_stage_Dense2 //////////////////////////////////

module reset_next_Dense_2 (
    input clk,
    input reset,
(*keep = "ture"*)    output reg out
    );
    reg [3:0] counter = 0;
    always@(posedge clk) begin
        if(reset)begin
            out <= 1;
        end
        else begin
            if (counter > 3)begin
                out <= 0 ;
                counter <= 4;
            end
            else counter <= counter + 1;
        end
    end
    endmodule
