Noobmaster69korg/EMG_gesture_classifier_Verilog/verilog_code_files/L2_filter.v

`timescale 1ns/1ps

module filter_2 (
    input clk,
    input reset,
    input signed [7:0] bias,  
    input signed [17:0] ch0,
    input signed [17:0] ch1,
    input signed [17:0] ch2,
    input signed [17:0] ch3,
    input signed [17:0] ch4,
    input signed [17:0] ch5,
    input signed [17:0] ch6,
    input signed [17:0] ch7,
    input signed [17:0] ch8,
    input signed [17:0] ch9,
    input signed [17:0] ch10,
    input signed [17:0] ch11,
    input signed [17:0] ch12,
    input signed [17:0] ch13,
    input signed [17:0] ch14,
    input signed [17:0] ch15,
    input signed [17:0] ch16,
    input signed [17:0] ch17,
    input signed [17:0] ch18,
    input signed [17:0] ch19,
    input signed [17:0] ch20,
    input signed [17:0] ch21,
    input signed [17:0] ch22,
    input signed [17:0] ch23,
    input signed [17:0] ch24,
    input signed [17:0] ch25,
    input signed [17:0] ch26,
    input signed [17:0] ch27,
    input signed [17:0] ch28,
    input signed [17:0] ch29,
    input signed [17:0] ch30,
    input signed [17:0] ch31,
    input signed [7:0] w0,
    input signed [7:0] w1,
    input signed [7:0] w2,
    input signed [7:0] w3,
    input signed [7:0] w4,
    input signed [7:0] w5,
    input signed [7:0] w6,
    input signed [7:0] w7,
    input signed [7:0] w8,
    input signed [7:0] w9,
    input signed [7:0] w10,
    input signed [7:0] w11,
    input signed [7:0] w12,
    input signed [7:0] w13,
    input signed [7:0] w14,
    input signed [7:0] w15,
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
    
    assign ad[0] = ac[0] + ac[1];
    assign ad[1] = ac[2] + ac[3];
    assign ad[2] = ac[4] + ac[5];
    assign ad[3] = ac[6] + ac[7];
    
    assign ae[0] = ad[0] + ad[1];
    assign ae[1] = ad[2] + ad[3];
    
    assign result = ae[0] + ae[1] + bias ;

    
    
    
    
endmodule

module DFF_15bits(
    input clk,
    input reset,
    input  signed [26:0] D,
    output reg signed [26:0] Q
    );
    always @(posedge clk)begin
        if(reset)
            Q <= 0;
        else
            Q <= D;
    end
    endmodule
