Noobmaster69korg/EMG_gesture_classifier_Verilog/verilog_code_files/L2_mux_4096.v

`timescale 1ns / 1ps


module mux_4096(
input [1:0] sel,
input signed [7:0] data_in_0, 
input signed [7:0] data_in_1, 
input signed [7:0] data_in_2, 
input signed [7:0] data_in_3, 
input signed [7:0] data_in_4, 
input signed [7:0] data_in_5, 
input signed [7:0] data_in_6, 
input signed [7:0] data_in_7, 
input signed [7:0] data_in_8, 
input signed [7:0] data_in_9, 
input signed [7:0] data_in_10, 
input signed [7:0] data_in_11, 
input signed [7:0] data_in_12, 
input signed [7:0] data_in_13, 
input signed [7:0] data_in_14, 
input signed [7:0] data_in_15, 
input signed [7:0] data_in_16, 
input signed [7:0] data_in_17, 
input signed [7:0] data_in_18, 
input signed [7:0] data_in_19, 
input signed [7:0] data_in_20, 
input signed [7:0] data_in_21, 
input signed [7:0] data_in_22, 
input signed [7:0] data_in_23, 
input signed [7:0] data_in_24, 
input signed [7:0] data_in_25, 
input signed [7:0] data_in_26, 
input signed [7:0] data_in_27, 
input signed [7:0] data_in_28, 
input signed [7:0] data_in_29, 
input signed [7:0] data_in_30, 
input signed [7:0] data_in_31, 
input signed [7:0] data_in_32, 
input signed [7:0] data_in_33, 
input signed [7:0] data_in_34, 
input signed [7:0] data_in_35, 
input signed [7:0] data_in_36, 
input signed [7:0] data_in_37, 
input signed [7:0] data_in_38, 
input signed [7:0] data_in_39, 
input signed [7:0] data_in_40, 
input signed [7:0] data_in_41, 
input signed [7:0] data_in_42, 
input signed [7:0] data_in_43, 
input signed [7:0] data_in_44, 
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
input signed [7:0] data_in_3537, 
input signed [7:0] data_in_3538, 
input signed [7:0] data_in_3539, 
input signed [7:0] data_in_3540, 
input signed [7:0] data_in_3541, 
input signed [7:0] data_in_3542, 
input signed [7:0] data_in_3543, 
input signed [7:0] data_in_3544, 
input signed [7:0] data_in_3545, 
input signed [7:0] data_in_3546, 
input signed [7:0] data_in_3547, 
input signed [7:0] data_in_3548, 
input signed [7:0] data_in_3549, 
input signed [7:0] data_in_3550, 
input signed [7:0] data_in_3551, 
input signed [7:0] data_in_3552, 
input signed [7:0] data_in_3553, 
input signed [7:0] data_in_3554, 
input signed [7:0] data_in_3555, 
input signed [7:0] data_in_3556, 
input signed [7:0] data_in_3557, 
input signed [7:0] data_in_3558, 
input signed [7:0] data_in_3559,
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
