Noobmaster69korg/EMG_gesture_classifier_Verilog/verilog_code_files/L2_weight_loader.v

`timescale 1ns/1ps

module weight_loader #(parameter N = 32)(
    input clk,
    input reset,
    input signed [7:0] data_in,
    output reg signed [7:0] w0, 
    output reg signed [7:0] w1, 
    output reg signed [7:0] w2, 
    output reg signed [7:0] w3, 
    output reg signed [7:0] w4, 
    output reg signed [7:0] w5, 
    output reg signed [7:0] w6, 
    output reg signed [7:0] w7, 
    output reg signed [7:0] w8, 
    output reg signed [7:0] w9, 
    output reg signed [7:0] w10, 
    output reg signed [7:0] w11, 
    output reg signed [7:0] w12, 
    output reg signed [7:0] w13, 
    output reg signed [7:0] w14, 
    output reg signed [7:0] w15, 
    output reg signed [7:0] w16, 
    output reg signed [7:0] w17, 
    output reg signed [7:0] w18, 
    output reg signed [7:0] w19, 
    output reg signed [7:0] w20, 
    output reg signed [7:0] w21, 
    output reg signed [7:0] w22, 
    output reg signed [7:0] w23, 
    output reg signed [7:0] w24, 
    output reg signed [7:0] w25, 
    output reg signed [7:0] w26, 
    output reg signed [7:0] w27, 
    output reg signed [7:0] w28, 
    output reg signed [7:0] w29, 
    output reg signed [7:0] w30, 
    output reg signed [7:0] w31, 
    output reg signed [7:0] w32, 
    output reg signed [7:0] w33, 
    output reg signed [7:0] w34, 
    output reg signed [7:0] w35, 
    output reg signed [7:0] w36, 
    output reg signed [7:0] w37, 
    output reg signed [7:0] w38, 
    output reg signed [7:0] w39, 
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
        w27 <= 0; 
        w28 <= 0; 
        w29 <= 0; 
        w30 <= 0; 
        w31 <= 0; 
        w32 <= 0; 
        w33 <= 0; 
        w34 <= 0; 
        w35 <= 0; 
        w36 <= 0; 
        w37 <= 0; 
        w38 <= 0; 
        w39 <= 0; 
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
        end
        end
endmodule
