Noobmaster69korg/EMG_gesture_classifier_Verilog/verilog_code_files/L2_bram.v

`timescale 1ns / 1ps

`timescale 1ns / 1ps

module bram(
        input clk,
        input reset,
        
        output signed [7:0] data_out_1,
        output signed [7:0] data_out_2,
        output signed [7:0] data_out_3,
        output signed [7:0] data_out_4,
        output signed [7:0] data_out_5,
        output signed [7:0] data_out_6,
        output signed [7:0] data_out_7,
        output signed [7:0] data_out_8,
        output signed [7:0] data_out_9,
        output signed [7:0] data_out_10,
        output signed [7:0] data_out_11,
        output signed [7:0] data_out_12,
        output signed [7:0] data_out_13,
        output signed [7:0] data_out_14,
        output signed [7:0] data_out_15,
        output signed [7:0] data_out_16,
        output signed [7:0] data_out_17,
        output signed [7:0] data_out_18,
        output signed [7:0] data_out_19,
        output signed [7:0] data_out_20,
        output signed [7:0] data_out_21,
        output signed [7:0] data_out_22,
        output signed [7:0] data_out_23,
        output signed [7:0] data_out_24,
        output signed [7:0] data_out_25,
        output signed [7:0] data_out_26,
        output signed [7:0] data_out_27,
        output signed [7:0] data_out_28,
        output signed [7:0] data_out_29,
        output signed [7:0] data_out_30,
        output signed [7:0] data_out_31,
        output signed [7:0] data_out_32,
        output signed [7:0] data_out_33,
        output signed [7:0] data_out_34,
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
blk_mem_gen_34 A34(.clka(clk),.ena(!reset),.addra(counter),.douta(data_out_35));
blk_mem_gen_35 A35(.clka(clk),.ena(!reset),.addra(counter),.douta(data_out_36));
blk_mem_gen_36 A36(.clka(clk),.ena(!reset),.addra(counter),.douta(data_out_37));
blk_mem_gen_37 A37(.clka(clk),.ena(!reset),.addra(counter),.douta(data_out_38));
blk_mem_gen_38 A38(.clka(clk),.ena(!reset),.addra(counter),.douta(data_out_39));
blk_mem_gen_39 A39(.clka(clk),.ena(!reset),.addra(counter),.douta(data_out_40));
blk_mem_gen_40 A40(.clka(clk),.ena(!reset),.addra(counter),.douta(data_out_41));
blk_mem_gen_41 A41(.clka(clk),.ena(!reset),.addra(counter),.douta(data_out_42));
blk_mem_gen_42 A42(.clka(clk),.ena(!reset),.addra(counter),.douta(data_out_43));
blk_mem_gen_43 A43(.clka(clk),.ena(!reset),.addra(counter),.douta(data_out_44));
blk_mem_gen_44 A44(.clka(clk),.ena(!reset),.addra(counter),.douta(data_out_45));
blk_mem_gen_45 A45(.clka(clk),.ena(!reset),.addra(counter),.douta(data_out_46));
blk_mem_gen_46 A46(.clka(clk),.ena(!reset),.addra(counter),.douta(data_out_47));
blk_mem_gen_47 A47(.clka(clk),.ena(!reset),.addra(counter),.douta(data_out_48));
blk_mem_gen_48 A48(.clka(clk),.ena(!reset),.addra(counter),.douta(data_out_49));
blk_mem_gen_49 A49(.clka(clk),.ena(!reset),.addra(counter),.douta(data_out_50));
blk_mem_gen_50 A50(.clka(clk),.ena(!reset),.addra(counter),.douta(data_out_51));
blk_mem_gen_51 A51(.clka(clk),.ena(!reset),.addra(counter),.douta(data_out_52));
blk_mem_gen_52 A52(.clka(clk),.ena(!reset),.addra(counter),.douta(data_out_53));
blk_mem_gen_53 A53(.clka(clk),.ena(!reset),.addra(counter),.douta(data_out_54));
blk_mem_gen_54 A54(.clka(clk),.ena(!reset),.addra(counter),.douta(data_out_55));
blk_mem_gen_55 A55(.clka(clk),.ena(!reset),.addra(counter),.douta(data_out_56));
blk_mem_gen_56 A56(.clka(clk),.ena(!reset),.addra(counter),.douta(data_out_57));
blk_mem_gen_57 A57(.clka(clk),.ena(!reset),.addra(counter),.douta(data_out_58));
blk_mem_gen_58 A58(.clka(clk),.ena(!reset),.addra(counter),.douta(data_out_59));
blk_mem_gen_59 A59(.clka(clk),.ena(!reset),.addra(counter),.douta(data_out_60));
blk_mem_gen_60 A60(.clka(clk),.ena(!reset),.addra(counter),.douta(data_out_61));
blk_mem_gen_61 A61(.clka(clk),.ena(!reset),.addra(counter),.douta(data_out_62));
blk_mem_gen_62 A62(.clka(clk),.ena(!reset),.addra(counter),.douta(data_out_63));
blk_mem_gen_63 A63(.clka(clk),.ena(!reset),.addra(counter),.douta(data_out_64));



endmodule 
