Noobmaster69korg/EMG_gesture_classifier_Verilog/verilog_code_files/L2_negDFF.v

`timescale 1ns / 1ps


module L2_negDFF(
    input  D,
    input clk,
    output reg Q

    );
    
    always@(negedge  clk)begin
        Q <= D;
    end
endmodule

module L2_posDFF(
    input D,
    input clk,
    output reg Q
    );
    always@(posedge clk)begin
        Q <= D;
    end
    endmodule
